UNCAMotorsports/UNCAMotorsports-2017/C-CAN/README.md

PSoC 5LP FIles

This is a collection of the files for the C-CAN, a configurable CAN-based sensor interface designed around a Cypress PSoC 5LP development board. You need PSoC Creator to work with these files; Once PSoC Creator is installed, you can edit the project by opening bootloader-000.cywrk in the bootloader folder.
