UNCAMotorsports/UNCAMotorsports-2017/Brake System Plausibility Device/BSPD_Schematic.PNG

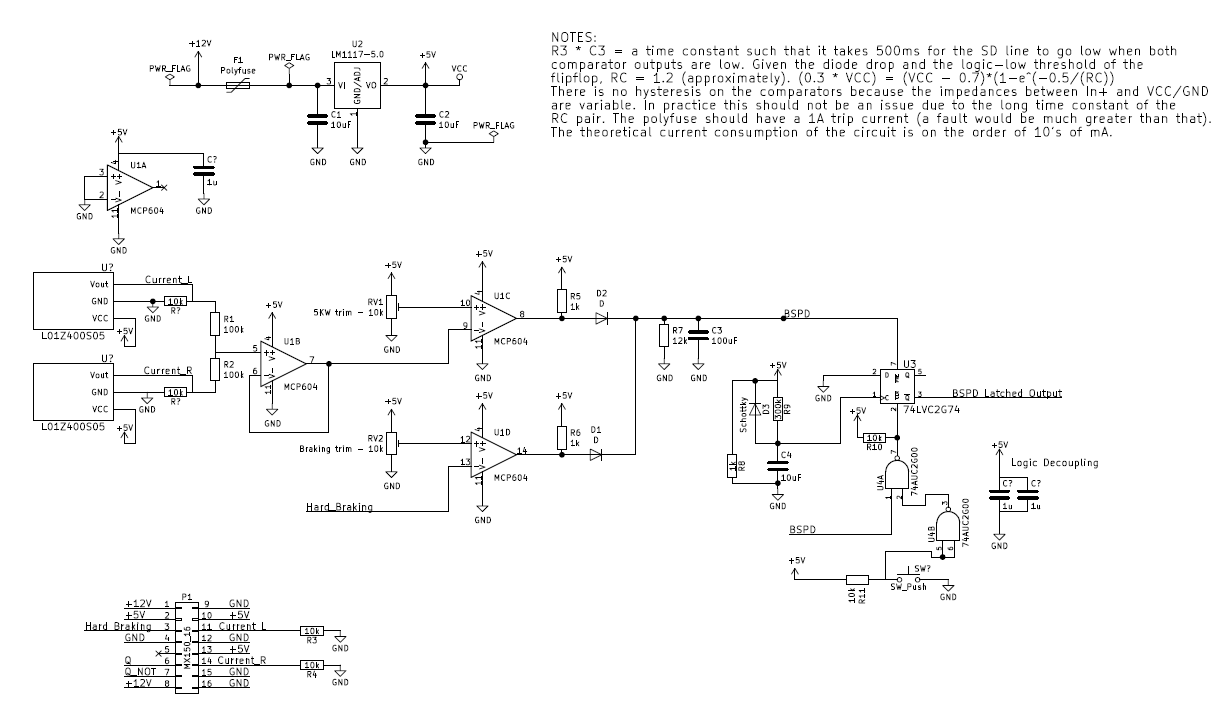
Brake System Plausibility Device/BSPD_Schematic.PNG
