UNCAMotorsports/UNCAMotorsports-2017/ESF_Diagrams/shutdown_circuit.png

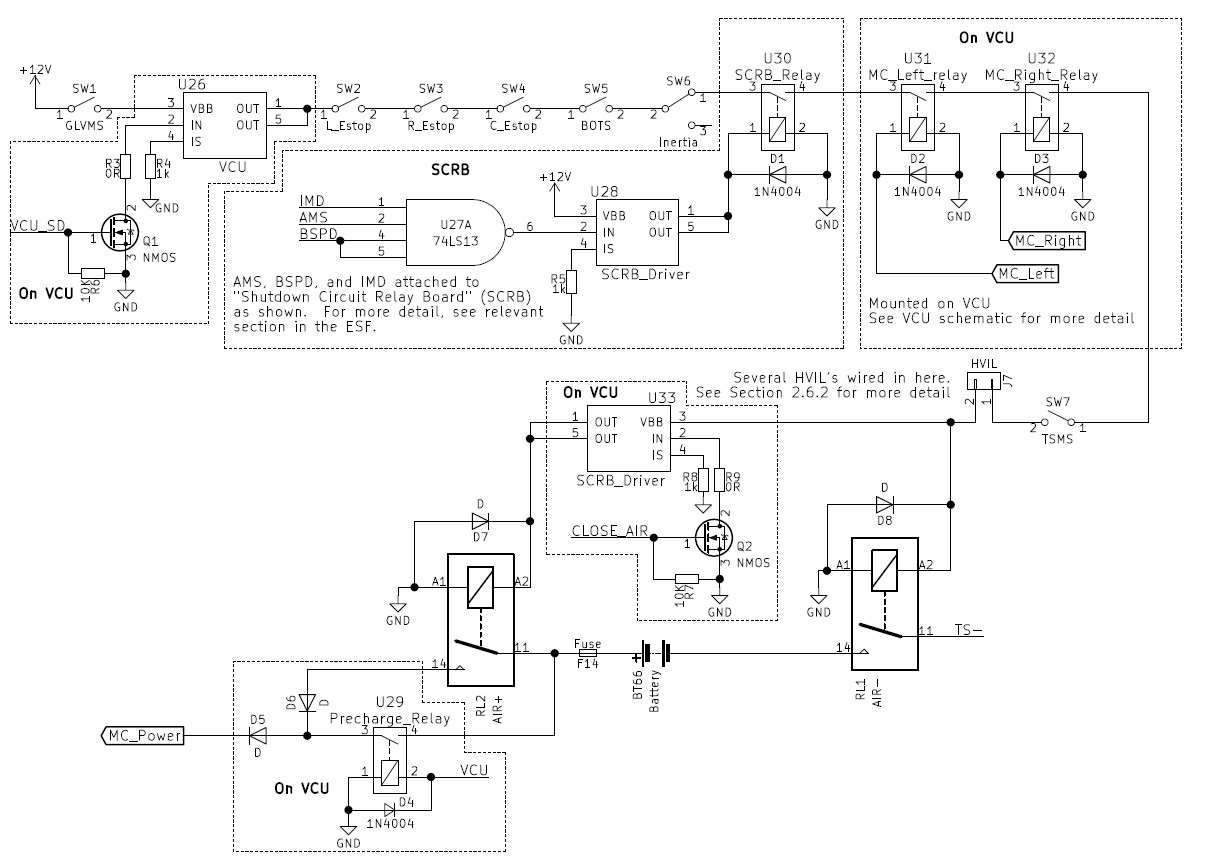
ESF_Diagrams/shutdown_circuit.png
