UNCAMotorsports/UNCAMotorsports-2017/IMD/IMD_Schematic.PNG

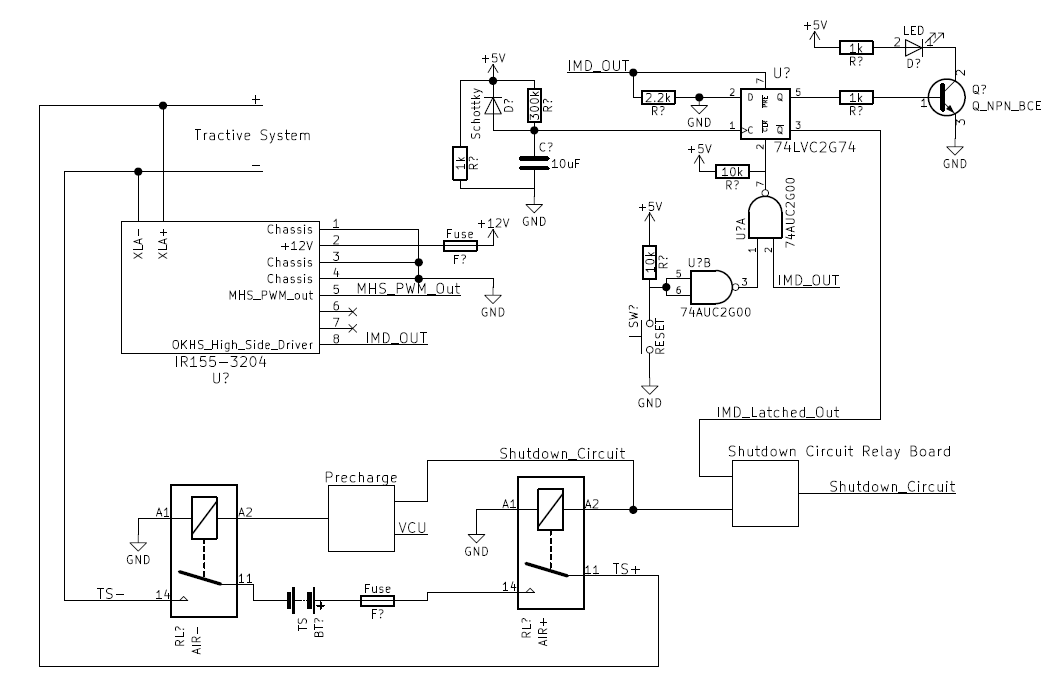
IMD/IMD_Schematic.PNG
