UNCAMotorsports/UNCAMotorsports-2017/latching_IMD-BMS-BSPD.PNG

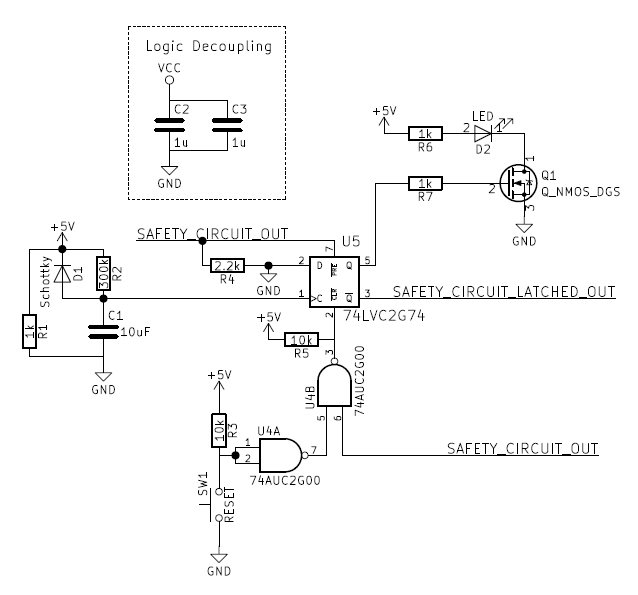
latching_IMD-BMS-BSPD.PNG
