UNCAMotorsports/UNCAMotorsports-2017/Reset_latching_IMD-BMS.PNG

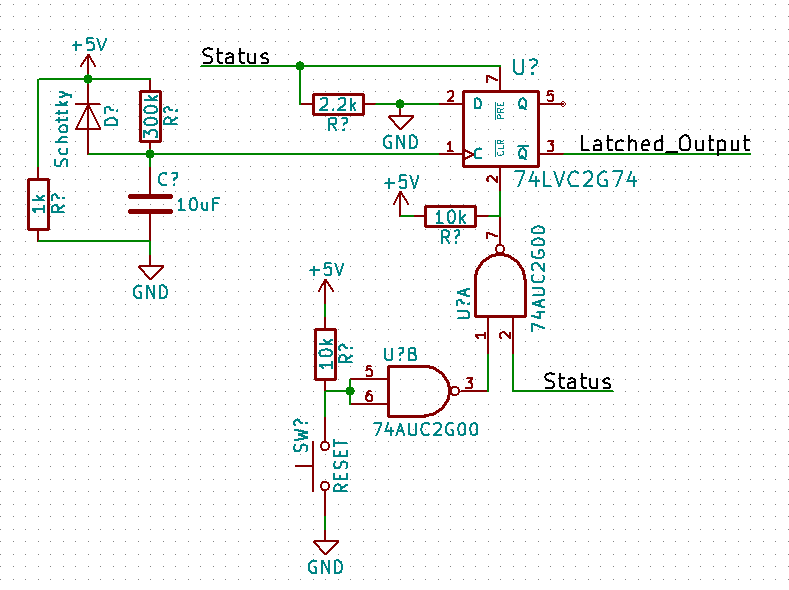
Reset_latching_IMD-BMS.PNG
