UNCAMotorsports/UNCAMotorsports-2017/shutdown_circuit/IMD.PNG

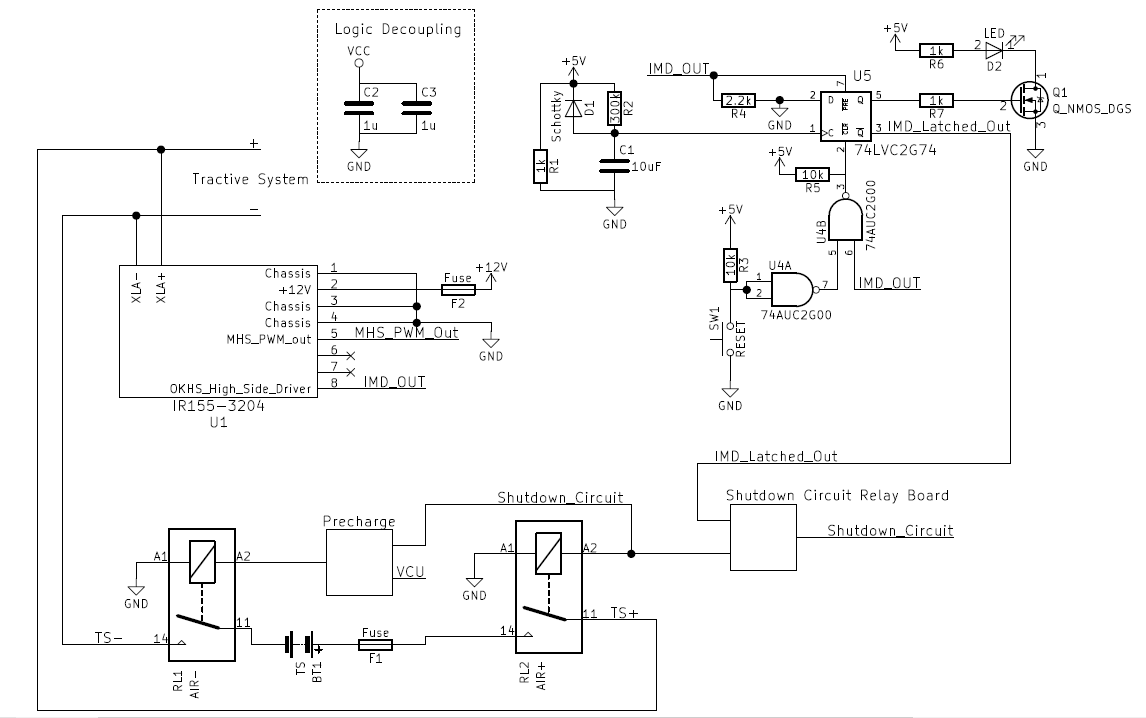
shutdown_circuit/IMD.PNG
