UNCAMotorsports/UNCAMotorsports-2017/shutdown_circuit/shutdown_relay_esf.png

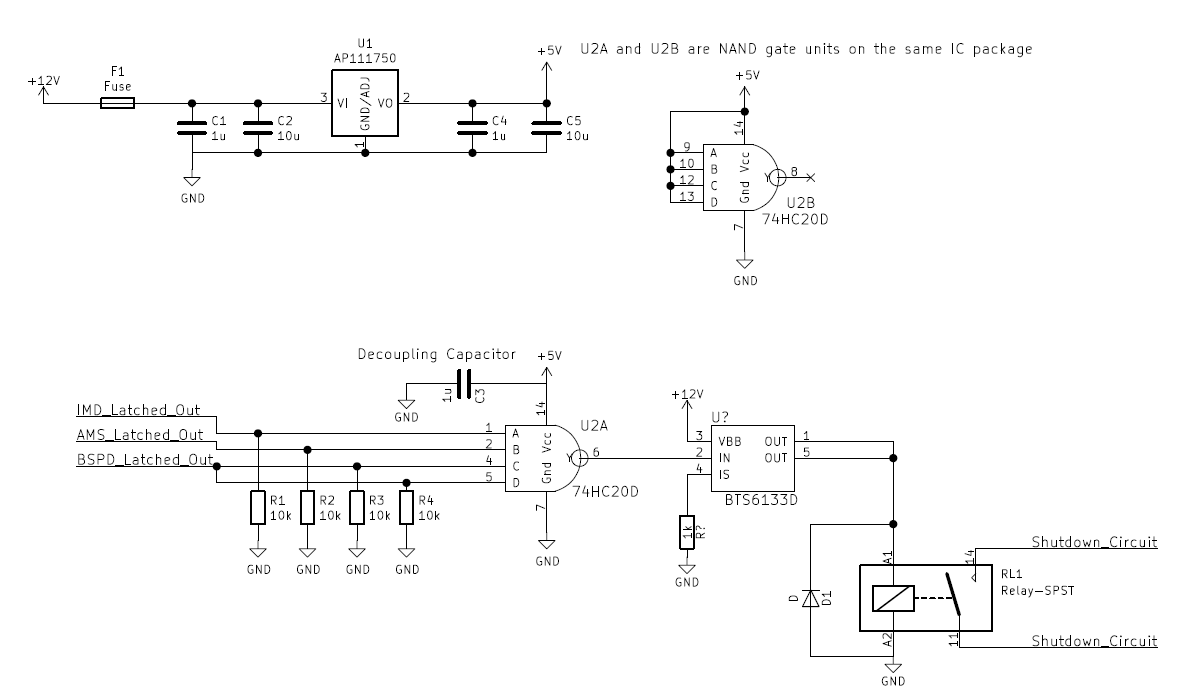
shutdown_circuit/shutdown_relay_esf.png
