UNCAMotorsports/UNCAMotorsports-2017/shutdown_circuit/VCU_shutdown_circuit.png

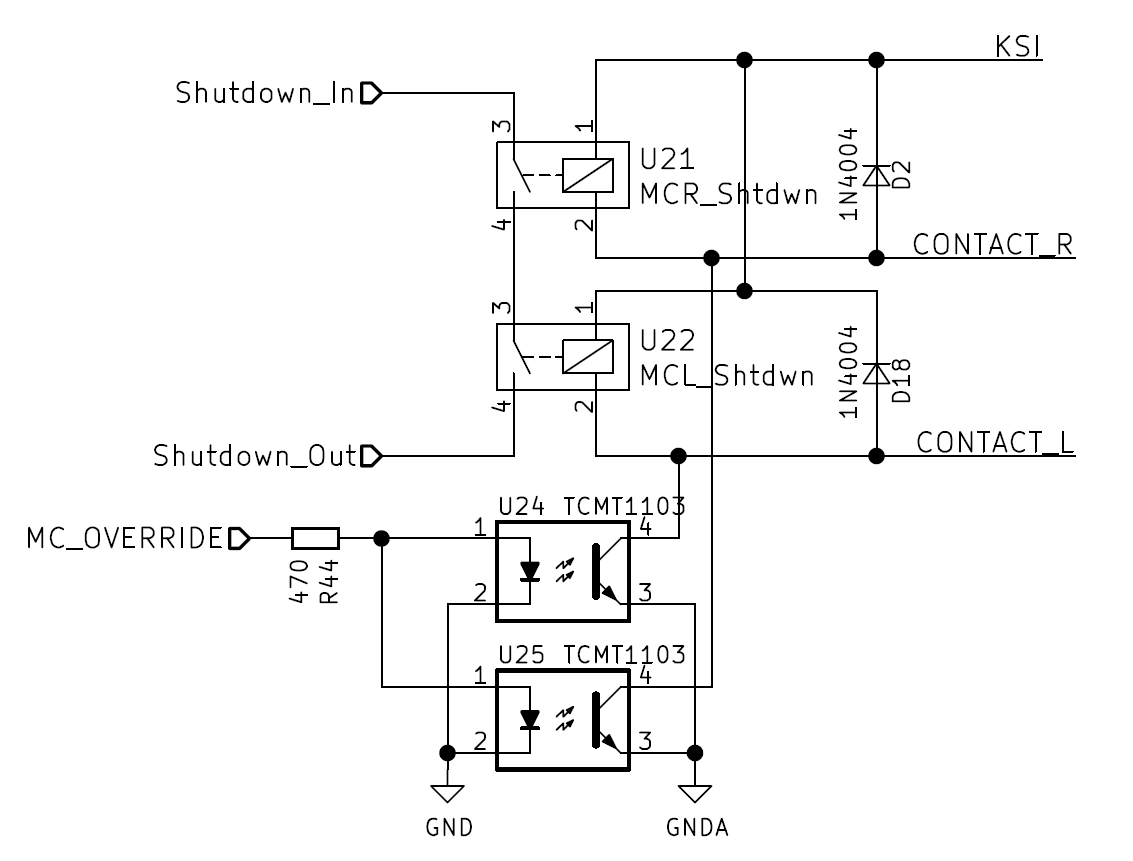
shutdown_circuit/VCU_shutdown_circuit.png
