UNCAMotorsports/UNCAMotorsports-2017/tsal/TSAL.PNG

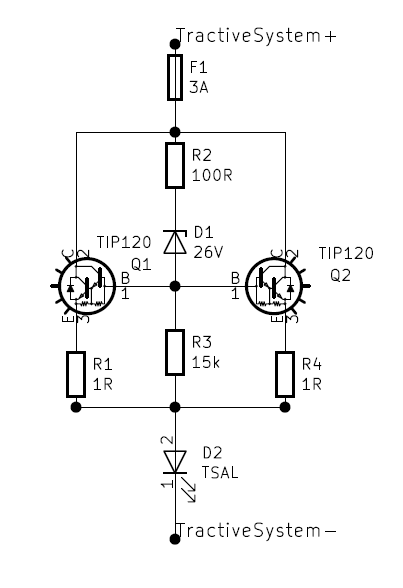
tsal/TSAL.PNG
