UNCAMotorsports/UNCAMotorsports-2017/Energy_Meter/BOM.txt

Current Shunt: Murata 3020-01105-0. 1000A 50mV shunt.
