UNCAMotorsports/UNCAMotorsports-2017/C-CAN/C-CAN_PSoC_DevKit/Bootloader.cydsn/ComponentUpdateLog.txt

Last Modified Date & Time: 10/16/2016 03:30:00

Bootloader: TopDesign.cysch
	USBFS [v3.0] to [v3.10]

Bootloader: Bootloader.cydwr
	cy_boot [v5.40] to [v5.50]

C-CAN: C-CAN.cydwr
	cy_boot [v5.40] to [v5.50]
