UNCAMotorsports/UNCAMotorsports-2017/C-CAN_Y17/enclosure_m12/working_version/5conn/Assem1.SLDASM

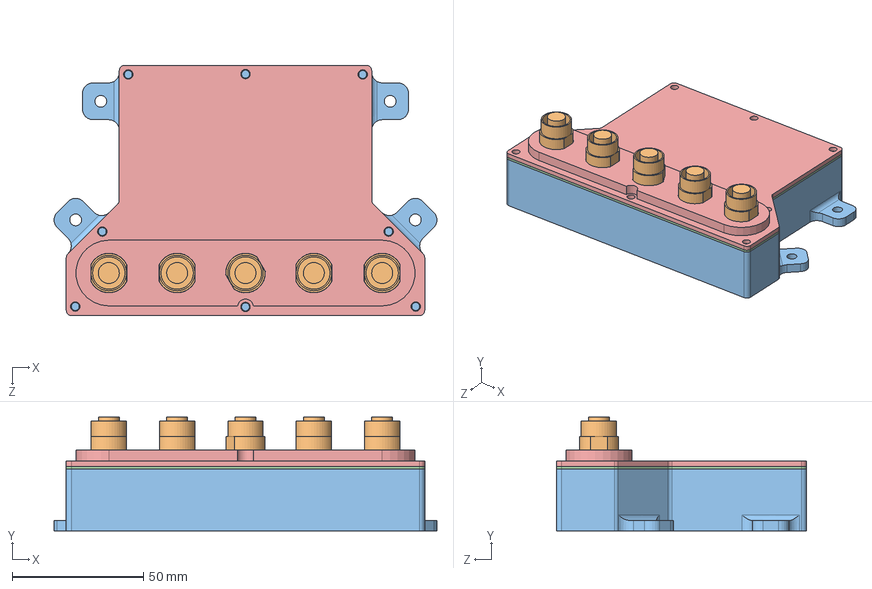
[picture p13: CAD file, 2017-06-10]
C-CAN_Y17/enclosure_m12/working_version/5conn/Assem1.SLDASM
145.7 x 43.2 x 95.2 mm
C-CAN_Y17
m12_connector_female x 5
5_connector_box
5_connector_gasket
5_connector_lid
