UNCAMotorsports/UNCAMotorsports-2017/C-CAN_Y17/enclosure_m12/working_version/new_b_and_c.SLDASM

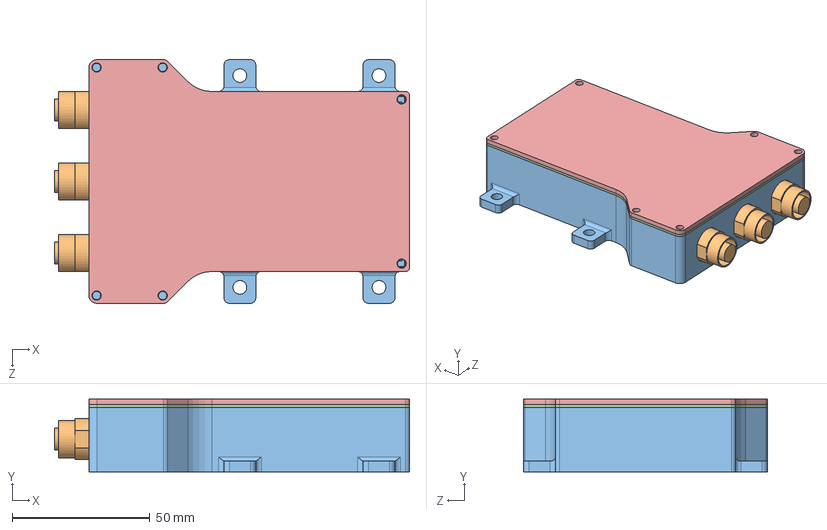
[picture p14: CAD file, 2017-06-07]
C-CAN_Y17/enclosure_m12/working_version/new_b_and_c.SLDASM
129.0 x 26.5 x 88.6 mm
C-CAN_Y17
m12_connector_female x 3
Gasket
lid
