UNCAMotorsports/UNCAMotorsports-2017/shutdown_circuit/scrub_buspod.SLDASM

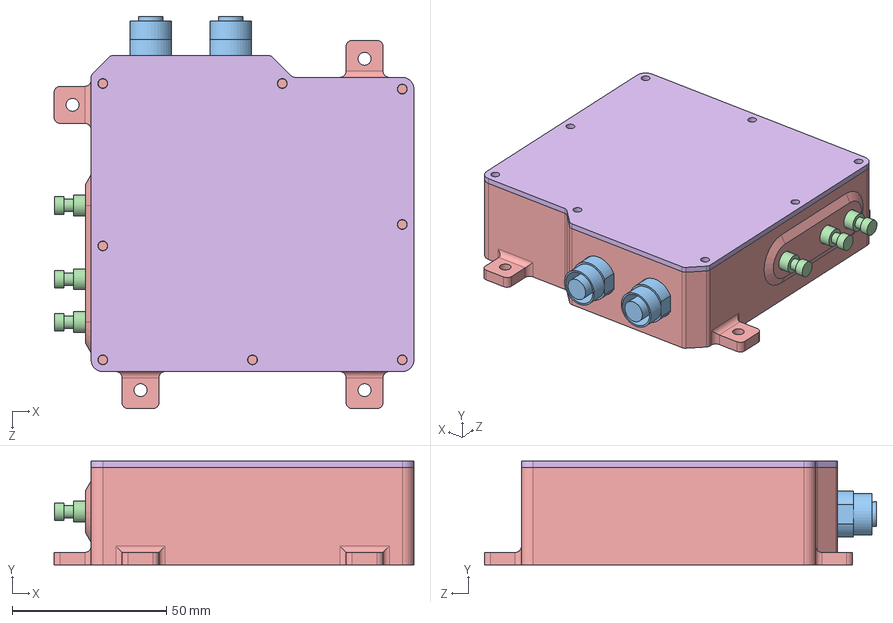
[picture p15: CAD file, 2017-06-13]
shutdown_circuit/scrub_buspod.SLDASM
116.5 x 33.5 x 127.0 mm
bspd x 3
scrb x 3
m12_connector_female x 2
push_button x 3
buspod_box
buspod_lid
