UNCAMotorsports/UNCAMotorsports-2017/C-CAN_Y17/enclosure_molex/Board_and_Connectors.SLDASM

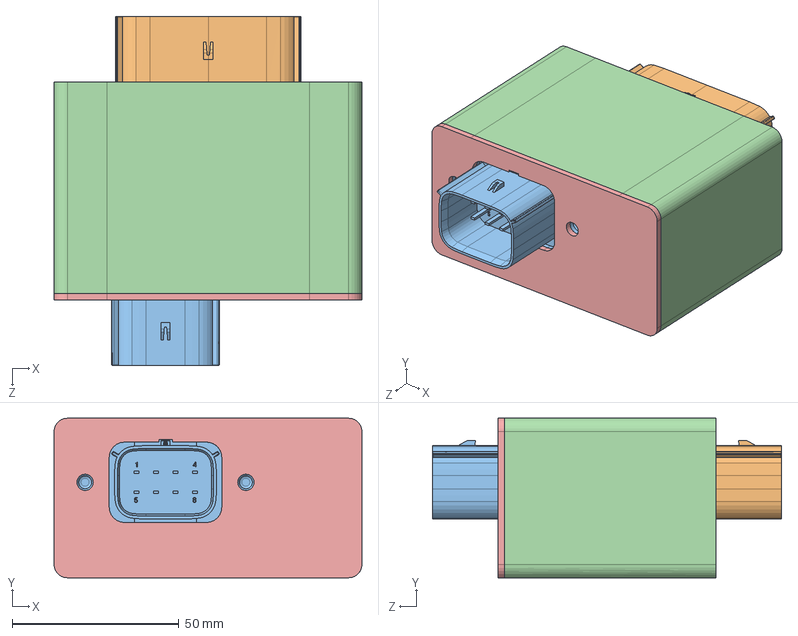
[picture p16: CAD file, 2017-03-09]
C-CAN_Y17/enclosure_molex/Board_and_Connectors.SLDASM
92.5 x 47.9 x 104.8 mm
C-CAN_Y17
mx150_16_pin
mx150_8_pin
C-CAN_Enclosure_1
C_CAN_Enclosure_2
