UNCAMotorsports/UNCAMotorsports-2017/C-CAN_Y17/enclosure_m12/Board_and_Connectors_2.SLDASM

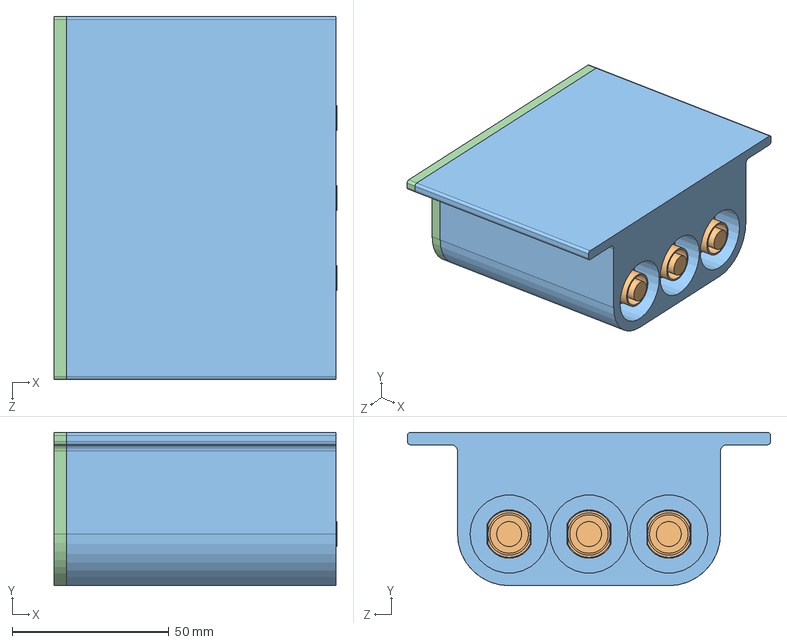
[picture p17: CAD file, 2017-04-11]
C-CAN_Y17/enclosure_m12/Board_and_Connectors_2.SLDASM
90.4 x 49.0 x 116.0 mm
C-CAN_Y17
m12_connector_female x 3
lid
