UNCAMotorsports/UNCAMotorsports-2017/C-CAN_Y17/C-CAN_Y17.stp

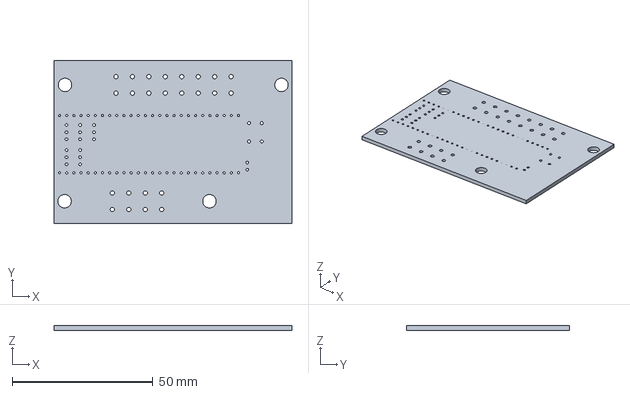
[picture p18: CAD file, 2017-03-09]
C-CAN_Y17/C-CAN_Y17.stp
84.5 x 57.8 x 1.60 mm
