UNCAMotorsports/UNCAMotorsports-2017/C-CAN_Y17/enclosure_m12/m12_connector_female.SLDPRT

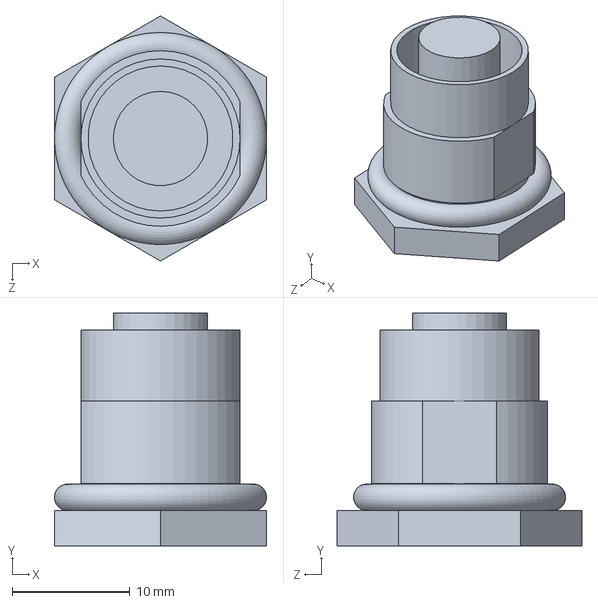
[picture p19: CAD file, 2017-06-13]
C-CAN_Y17/enclosure_m12/m12_connector_female.SLDPRT
18.0 x 19.8 x 20.8 mm
