UNCAMotorsports/UNCAMotorsports-2017/C-CAN_Y17/enclosure_m12/New folder/lid2.STL

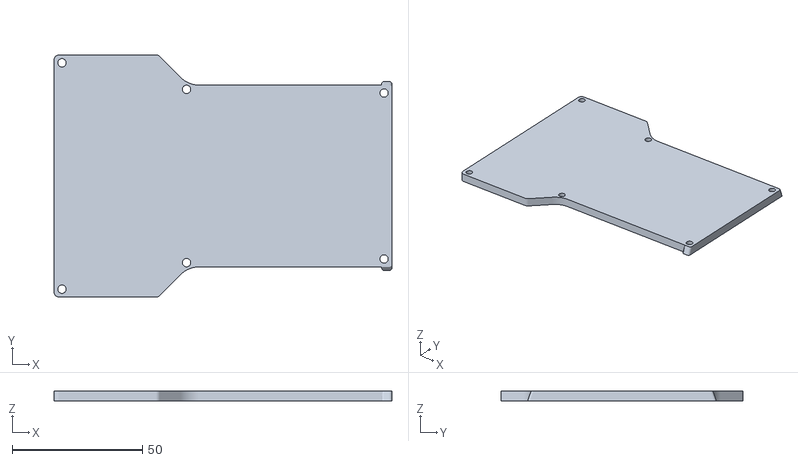
[picture p20: CAD file, 2017-04-20]
C-CAN_Y17/enclosure_m12/New folder/lid2.STL
129.8 x 93.0 x 4.00
