UNCAMotorsports/UNCAMotorsports-2017/C-CAN_Y17/enclosure_m12/working_version/C-CAN_Y17.SLDPRT

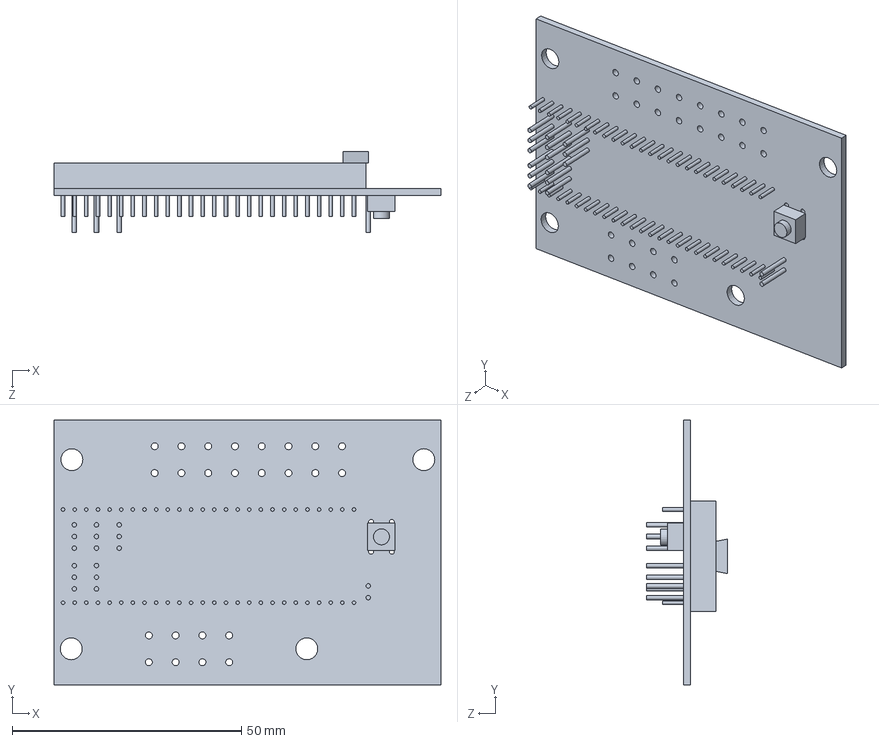
[picture p21: CAD file, 2017-06-07]
C-CAN_Y17/enclosure_m12/working_version/C-CAN_Y17.SLDPRT
84.5 x 57.8 x 17.6 mm
