UNCAMotorsports/UNCAMotorsports-2017/step_files/mx150_16_pin/mx150_16_pin.SLDPRT

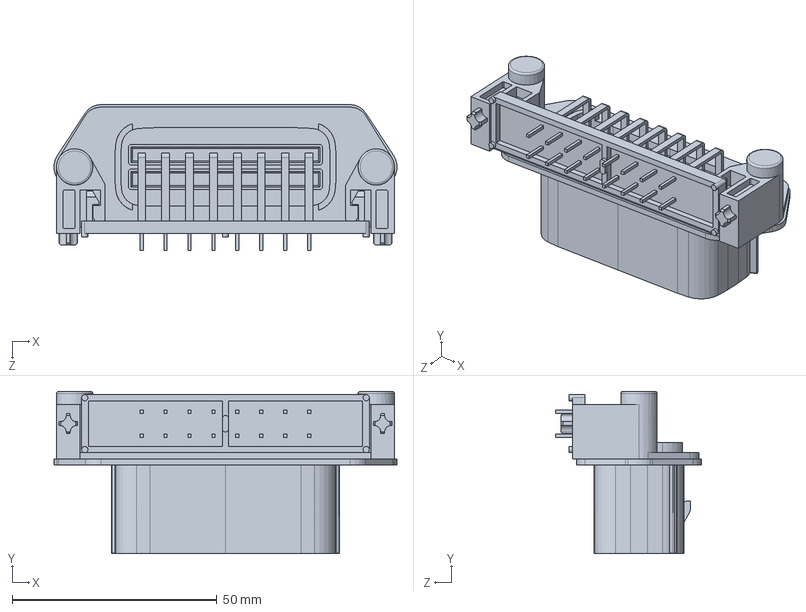
[picture p22: CAD file, 2017-03-09]
step_files/mx150_16_pin/mx150_16_pin.SLDPRT
83.8 x 39.6 x 35.6 mm
