UNCAMotorsports/UNCAMotorsports-2017/step_files/mx150_8_pin/mx150_8_pin.stp

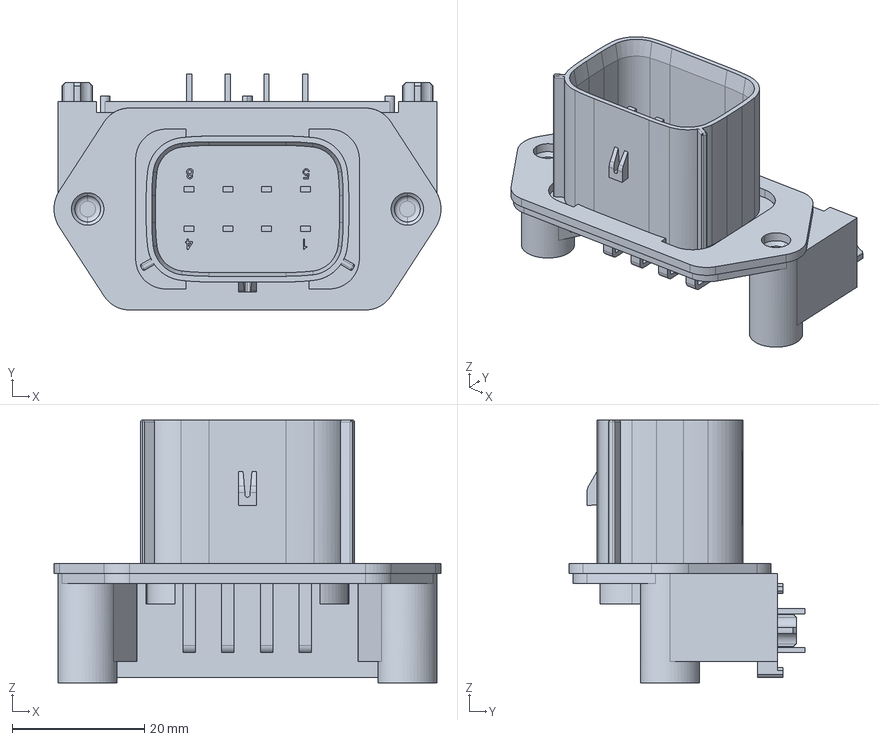
[picture p23: CAD file, 2017-03-09]
step_files/mx150_8_pin/mx150_8_pin.stp
58.4 x 35.6 x 39.6 mm
