UNCAMotorsports/UNCAMotorsports-2017/VehicleController/VehicleController1.step

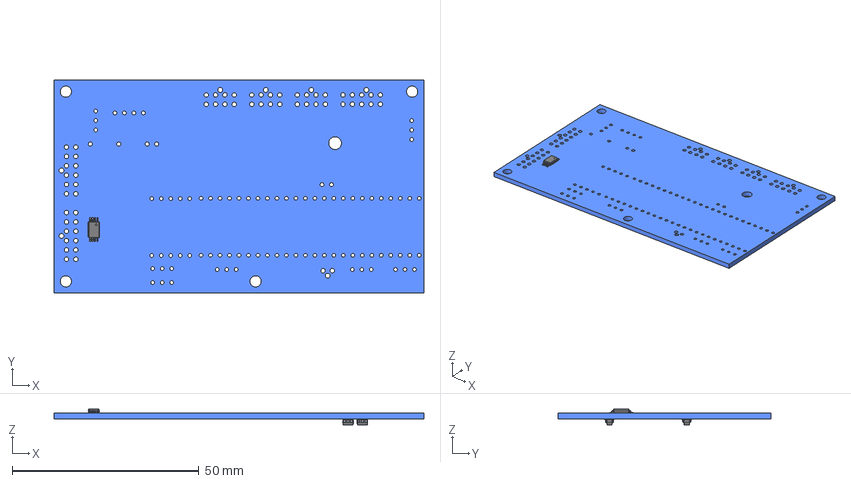
[picture p24: CAD file, 2017-09-07]
VehicleController/VehicleController1.step
99.1 x 57.1 x 4.25 mm
Pcb
SOT_23_6_
SOT_23_6_001
TSSOP_8_44x3mm_Pitch065mm_
