UNCAMotorsports/UNCAMotorsports-2017/C-CAN_Y17/enclosure_m12/working_version/box2.sldprt

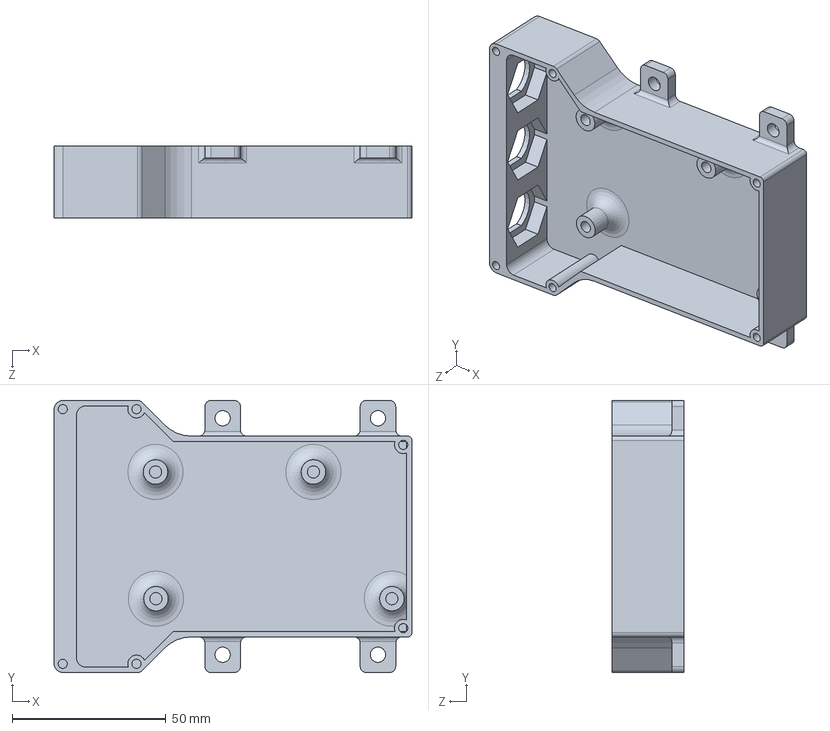
[picture p25: CAD file, 2017-06-07]
C-CAN_Y17/enclosure_m12/working_version/box2.sldprt
116.6 x 88.6 x 23.5 mm
