UNCAMotorsports/UNCAMotorsports-2017/shutdown_circuit/scrb.SLDPRT

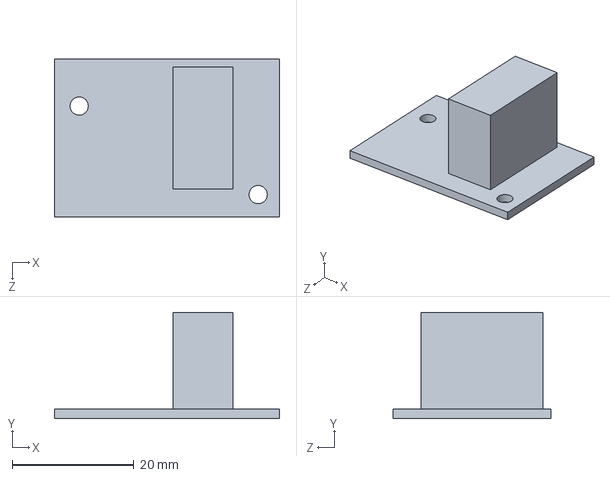
[picture p26: CAD file, 2017-06-13]
shutdown_circuit/scrb.SLDPRT
36.9 x 17.5 x 25.9 mm
