UNCAMotorsports/UNCAMotorsports-2017/VehicleController/VehicleController.stp

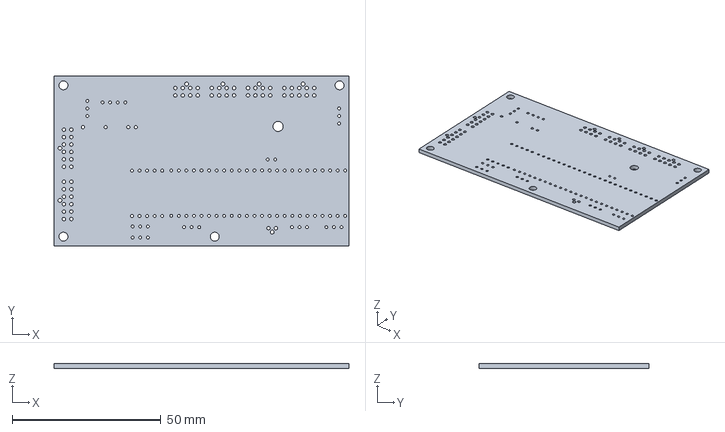
[picture p27: CAD file, 2017-06-15]
VehicleController/VehicleController.stp
99.1 x 57.1 x 1.60 mm
