UNCAMotorsports/UNCAMotorsports-2017/C-CAN_Y17/enclosure_m12/box.sldprt

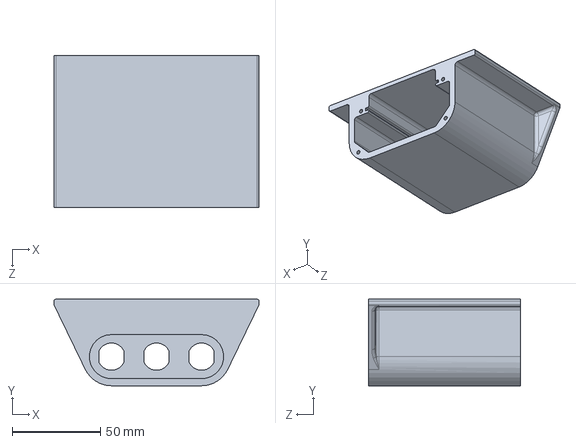
[picture p28: CAD file, 2017-04-16]
C-CAN_Y17/enclosure_m12/box.sldprt
116.0 x 49.0 x 86.2 mm
