UNCAMotorsports/UNCAMotorsports-2017/shutdown_circuit/push_button.SLDPRT

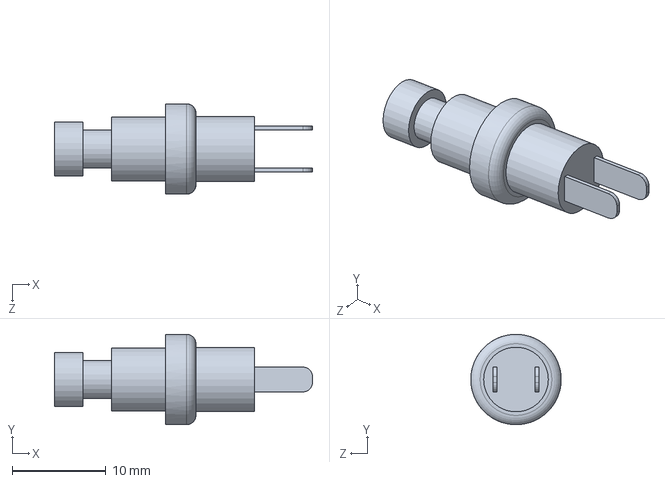
[picture p29: CAD file, 2017-06-13]
shutdown_circuit/push_button.SLDPRT
27.6 x 9.66 x 9.66 mm
