UNCAMotorsports/UNCAMotorsports-2017/C-CAN_Y17/enclosure_m12/lid2.STL

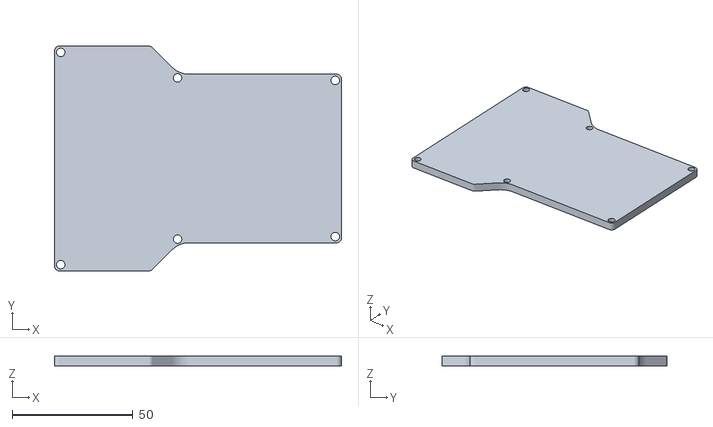
[picture p30: CAD file, 2017-04-13]
C-CAN_Y17/enclosure_m12/lid2.STL
118.8 x 93.0 x 4.00
