UNCAMotorsports/UNCAMotorsports-2017/shutdown_circuit/bspd.SLDPRT

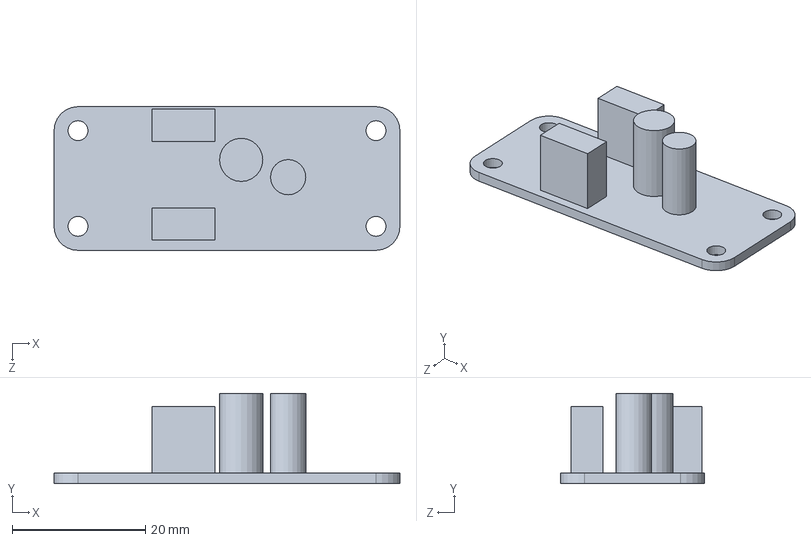
[picture p31: CAD file, 2017-06-13]
shutdown_circuit/bspd.SLDPRT
52.0 x 13.6 x 21.6 mm
