UNCAMotorsports/UNCAMotorsports-2017/C-CAN_Y17/enclosure_m12/working_version/lid.sldprt

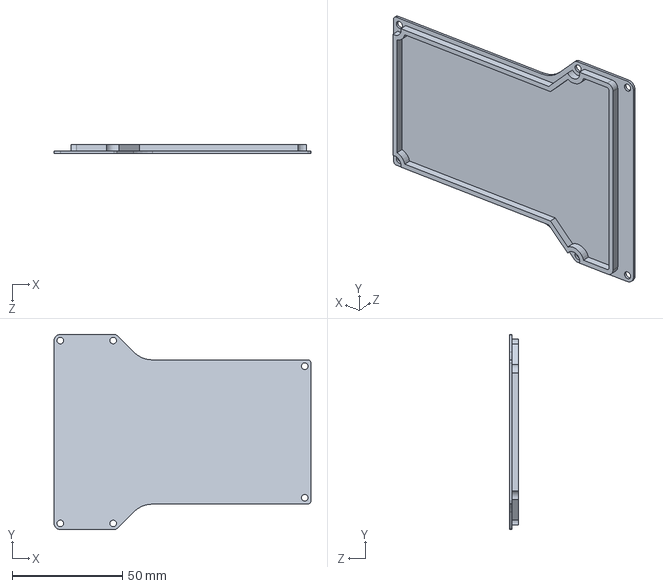
[picture p32: CAD file, 2017-06-07]
C-CAN_Y17/enclosure_m12/working_version/lid.sldprt
116.6 x 88.6 x 4.00 mm
