UNCAMotorsports/UNCAMotorsports-2017/shutdown_circuit/shutdown_circuit.stp

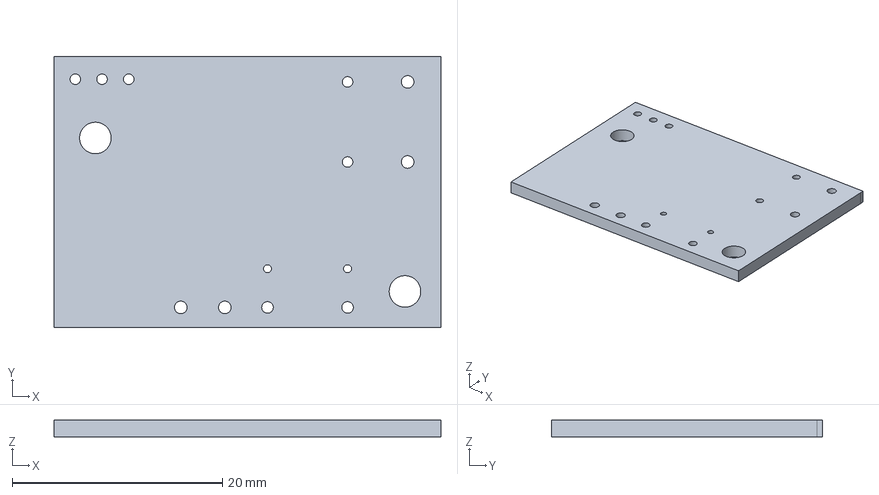
[picture p34: CAD file, 2017-06-10]
shutdown_circuit/shutdown_circuit.stp
36.8 x 25.8 x 1.60 mm
