UNCAMotorsports/UNCAMotorsports-2017/(list of files, cad)

Other CAD files:
C-CAN_Y17/enclosure_molex/C-CAN_Y17.SLDPRT
shutdown_circuit/Part4.sldprt
C-CAN_Y17/enclosure_m12/C-CAN_Y17.SLDPRT
C-CAN_Y17/enclosure_m12/working_version/5conn/Part1.sldprt
C-CAN_Y17/enclosure_molex/C_CAN_Enclosure_2.SLDPRT
C-CAN_Y17/enclosure_m12/working_version/5conn/5_connector_gasket.sldprt
C-CAN_Y17/enclosure_m12/working_version/m12_connector_female.SLDPRT
C-CAN_Y17/enclosure_molex/Part15.sldprt
C-CAN_Y17/enclosure_m12/working_version/5conn/5_connector_lid.sldprt
C-CAN_Y17/enclosure_molex/COMPOUND.sldprt
C-CAN_Y17/enclosure_m12/Part2.sldprt
C-CAN_Y17/enclosure_m12/working_version/5conn/5_connector_box.SLDPRT
C-CAN_Y17/enclosure_m12/working_version/Gasket.sldprt
C-CAN_Y17/enclosure_molex/C-CAN_Enclosure_1.SLDPRT
C-CAN_Y17/enclosure_m12/Part4.sldprt
shutdown_circuit/buspod_lid.sldprt
C-CAN_Y17/enclosure_m12/lid.sldprt
C-CAN_Y17/enclosure_molex/Part14.sldprt
shutdown_circuit/buspod_box.sldprt
shutdown_circuit/shutdown_circuit.wrl.sldprt
C-CAN_Y17/Gerbers/C-CAN_Y17-F.Mask.dxf
C-CAN_Y17/enclosure_m12/box.STL
C-CAN_Y17/enclosure_m12/lid.STL
C-CAN_Y17/enclosure_m12/m3_nut.SLDPRT
C-CAN_Y17/enclosure_m12/working_version/5conn/5_connector_box.STL
C-CAN_Y17/enclosure_m12/working_version/5conn/5_connector_lid.STL
C-CAN_Y17/enclosure_m12/working_version/Gasket.STL
C-CAN_Y17/enclosure_m12/working_version/box2.STL
C-CAN_Y17/enclosure_m12/working_version/lid.STL
VehicleController/VehicleController.FCStd
VehicleController/VehicleController.SLDPRT
shutdown_circuit/buspod_box.STL
shutdown_circuit/buspod_lid.STL
step_files/194270032.stp
step_files/194270049.SLDPRT
step_files/194270049.stp
step_files/mx150_8_pin/mx150_8_pin.SLDPRT
