UNCAMotorsports/UNCAMotorsports-2017/TestMule/Test Data/Aug31_no_differential.csv

Version | Millis | Throttle | Left | Right | Steer | leftRPM | rightRPM
1 | 135 | 0 | 0 | 0 | 16.25 | 0 | 0
1 | 140 | 0 | 0 | 0 | 16.25 | 0 | 0
1 | 145 | 0 | 0 | 0 | 16.25 | 0 | 0
1 | 150 | 0 | 0 | 0 | 16.25 | 0 | 0
1 | 155 | 0 | 0 | 0 | 16.200000762939453 | 0 | 0
1 | 160 | 0 | 0 | 0 | 16.25 | 0 | 0
1 | 165 | 0 | 0 | 0 | 16.350000381469727 | 0 | 0
1 | 170 | 0 | 0 | 0 | 16.25 | 0 | 0
1 | 175 | 0 | 0 | 0 | 16.200000762939453 | 0 | 0
1 | 180 | 0 | 0 | 0 | 16.30000114440918 | 0 | 0
1 | 185 | 0 | 0 | 0 | 16.149999618530273 | 0 | 0
1 | 190 | 0 | 0 | 0 | 16.30000114440918 | 0 | 0
1 | 195 | 0 | 0 | 0 | 16.25 | 0 | 0
1 | 200 | 0 | 0 | 0 | 16.200000762939453 | 0 | 0
1 | 205 | 0 | 0 | 0 | 16.30000114440918 | 0 | 0
1 | 210 | 0 | 0 | 0 | 16.25 | 0 | 0
1 | 215 | 0 | 0 | 0 | 16.350000381469727 | 0 | 0
1 | 220 | 0 | 0 | 0 | 16.25 | 0 | 0
1 | 225 | 0 | 0 | 0 | 16.149999618530273 | 0 | 0
1 | 230 | 0 | 0 | 0 | 16.30000114440918 | 0 | 0
1 | 235 | 0 | 0 | 0 | 16.30000114440918 | 0 | 0
1 | 240 | 0 | 0 | 0 | 16.25 | 0 | 0
1 | 245 | 0 | 0 | 0 | 16.25 | 0 | 0
1 | 250 | 0 | 0 | 0 | 16.200000762939453 | 0 | 0
1 | 255 | 0 | 0 | 0 | 16.30000114440918 | 0 | 0
1 | 300 | 0 | 0 | 0 | 16.149999618530273 | 0 | 0
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
