UNCAMotorsports/UNCAMotorsports-2017/C-CAN/TODO.rtf

8/21/16
Get the system timer interrupt to change the rate of sampling for the sensors/encoders. Global variables? Handler functions?
