UNCAMotorsports/UNCAMotorsports-2017/TestMule/TestMule.pdf

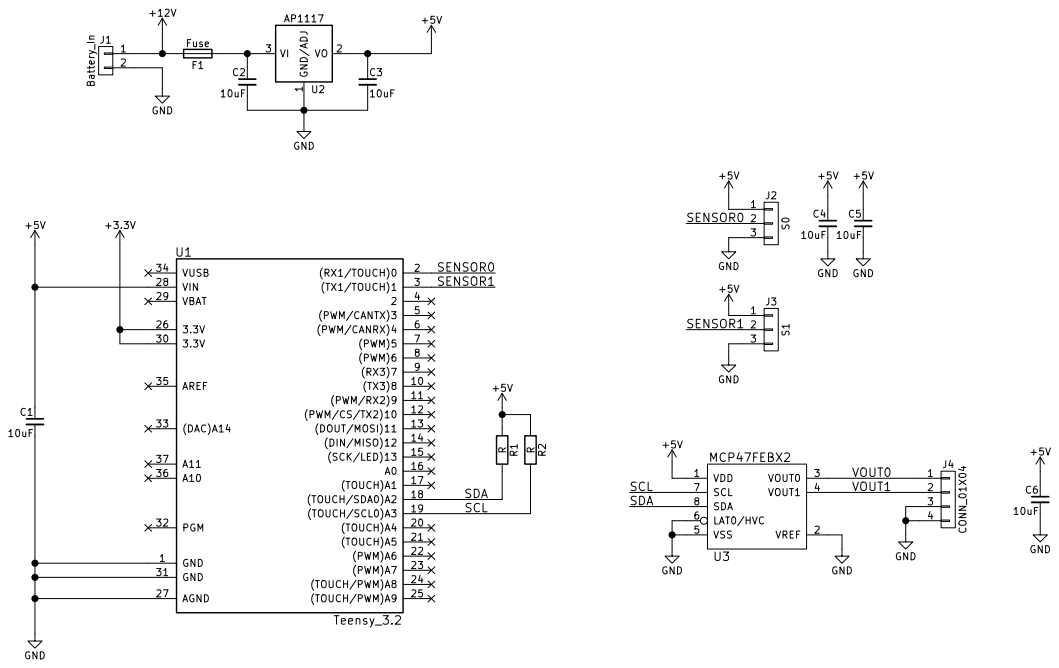
[picture p35: page 1]

Id: 1/1 Title: TestMule Controller File: TestMule.sch Sheet: / UNC Asheville Motorsports GND 1
