UNCAMotorsports/UNCAMotorsports-2017/VehicleController/VehicleController.pdf

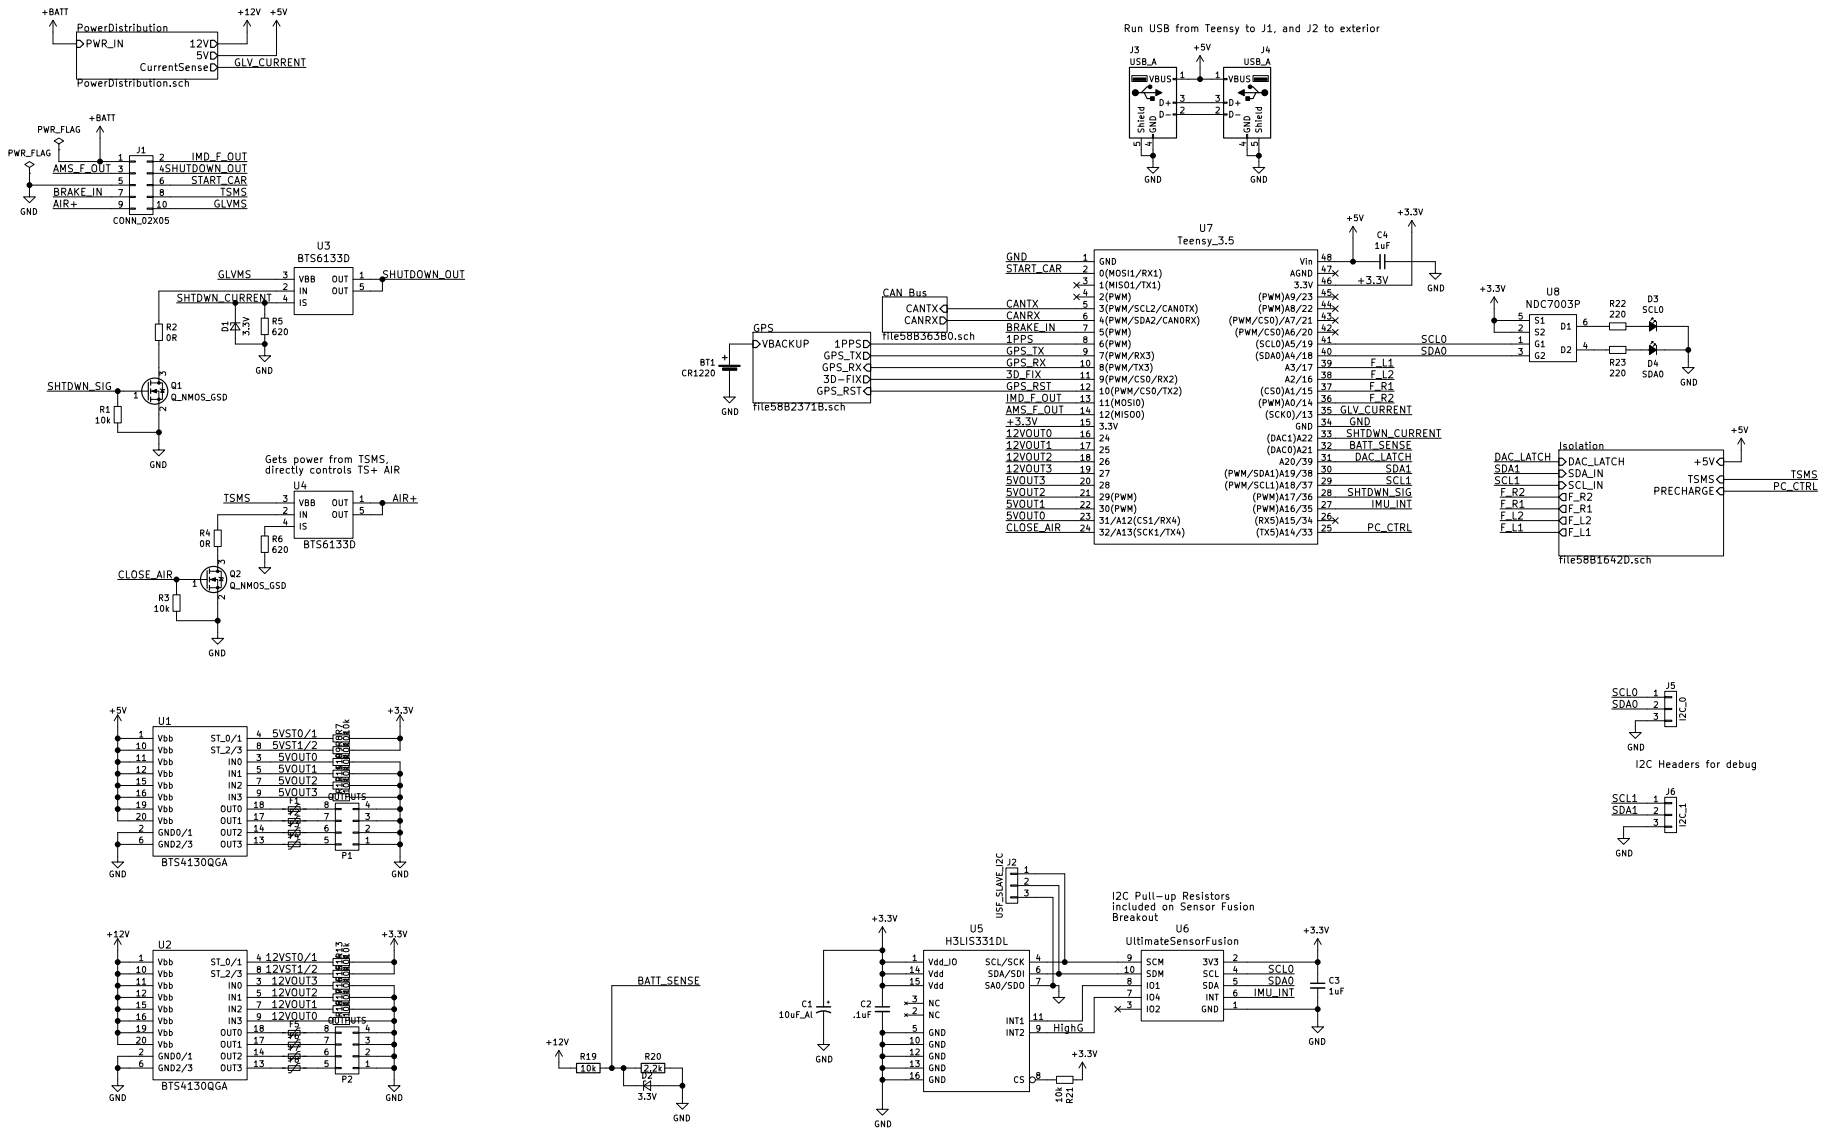
[picture p36: page 1]

PowerDistribution PowerDistribution.sch CurrentSense

9 | | 10

3D-FIX GPS_TX GPS_RX GPS_RST | 1PPS | 6(PWM) 8

7(PWM/RX3) 9 | SDA0

3D_FIX | | 9(PWM/CS0/RX2) 11

10(PWM/CS0/TX2) 12

IMD_F_OUT | | 11(MOSI0) 13

directly controls TS+ AIR

I2C Pull-up Resistors
included on Sensor Fusion Breakout

HighG

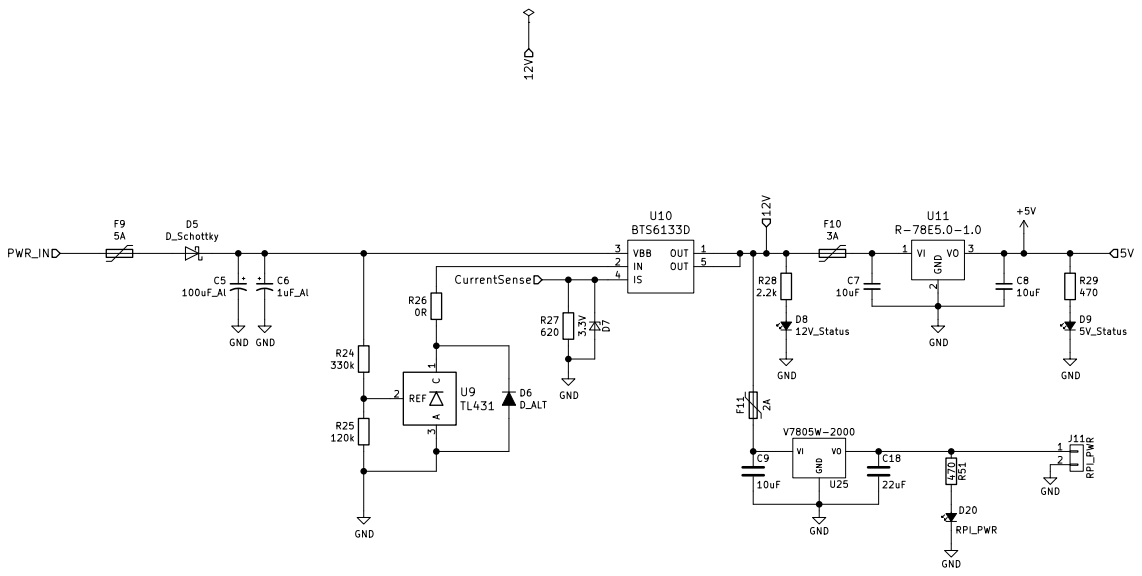
[picture p37: page 2]

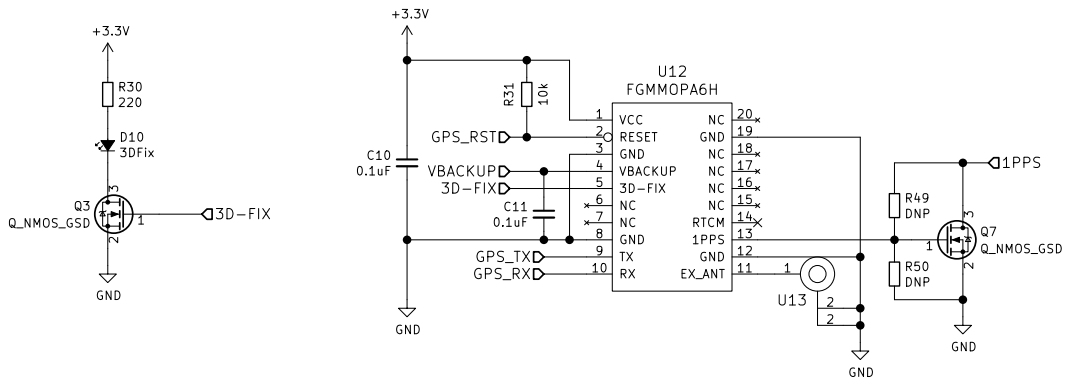
[picture p38: page 3]

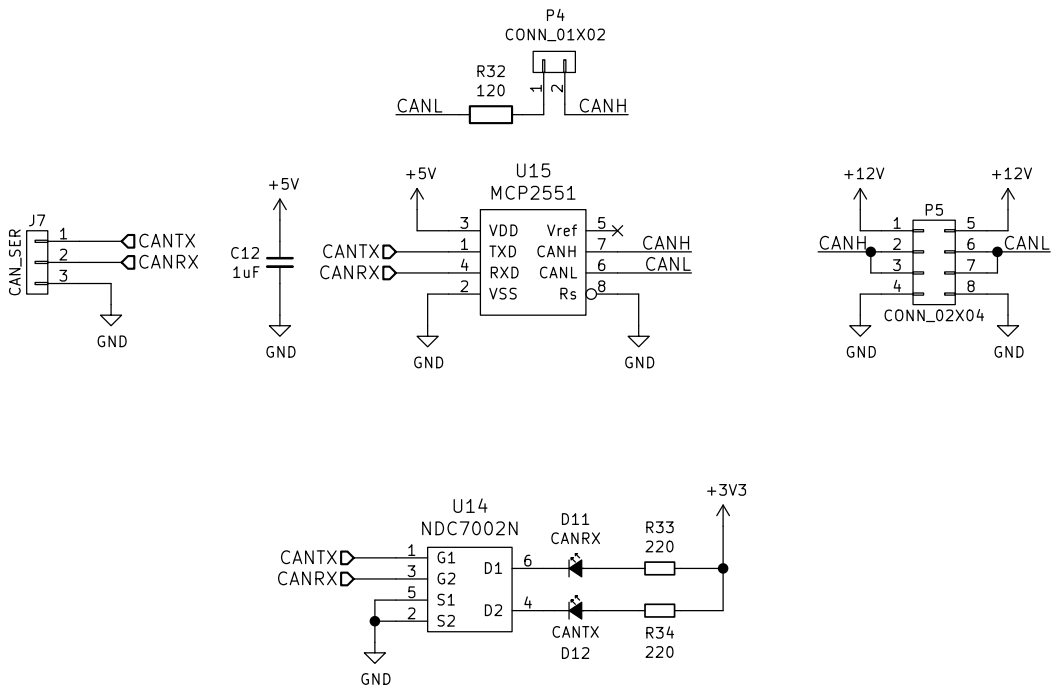
[picture p39: page 4]

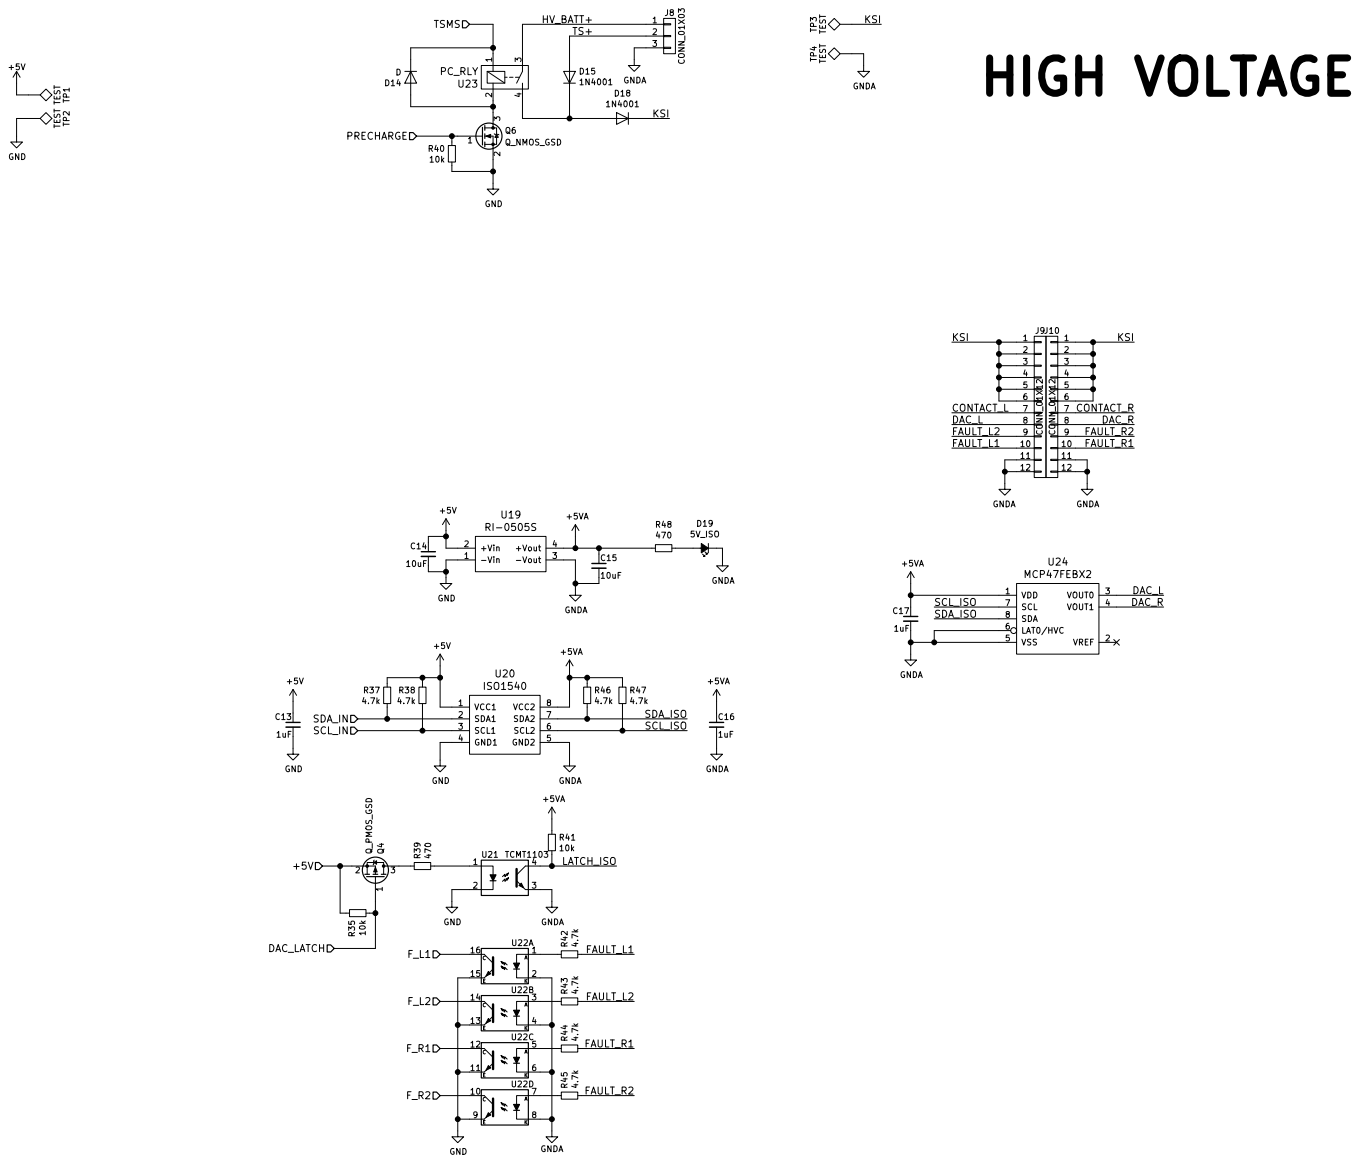
[picture p40: page 5]

2 3 Q6 Q_NMOS_GSD TP1 TEST TP2 TEST TP3 TEST TP4 TEST GNDA

J9 | J10 CONN_01X12

CONN_01X12 | 3

10
