UNCAMotorsports/UNCAMotorsports-2017/IMD/IMD.pdf

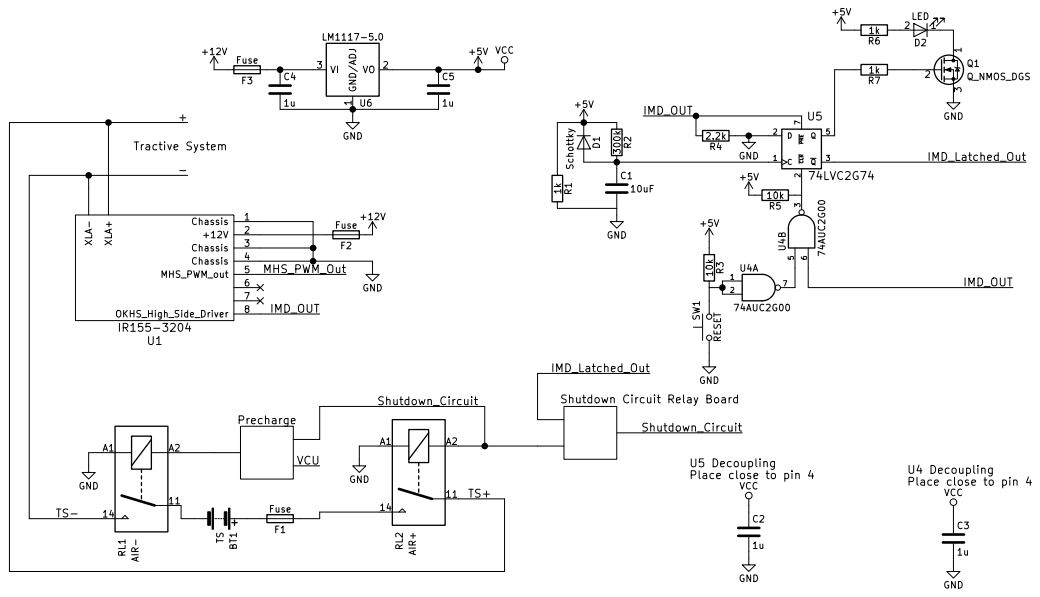
[picture p42: page 1]

Shutdown Circuit Relay Board

Place close to pin 4
