UNCAMotorsports/UNCAMotorsports-2017/Reset_Latching_IMD_AMS/reset_latching.pdf

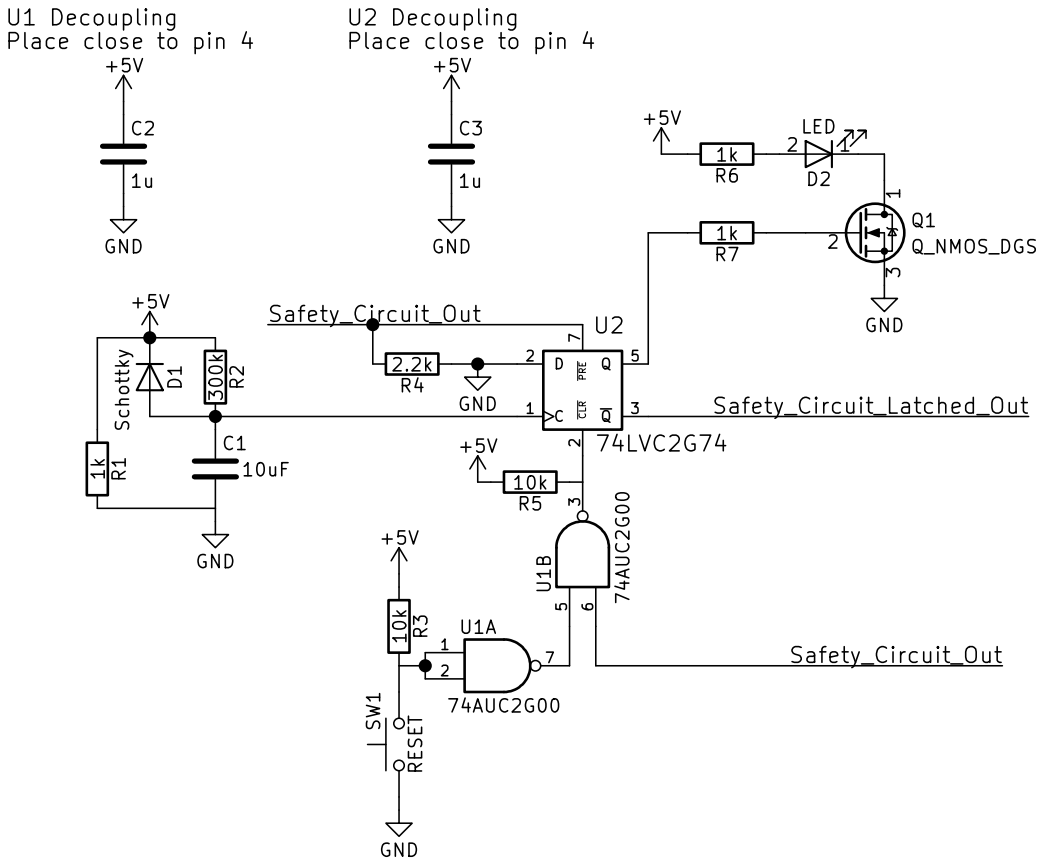
[picture p43: page 1]

Place close to pin 4

U2 Decoupling
