UNCAMotorsports/UNCAMotorsports-2017/ESF_Diagrams/ESF_Diagrams.pdf

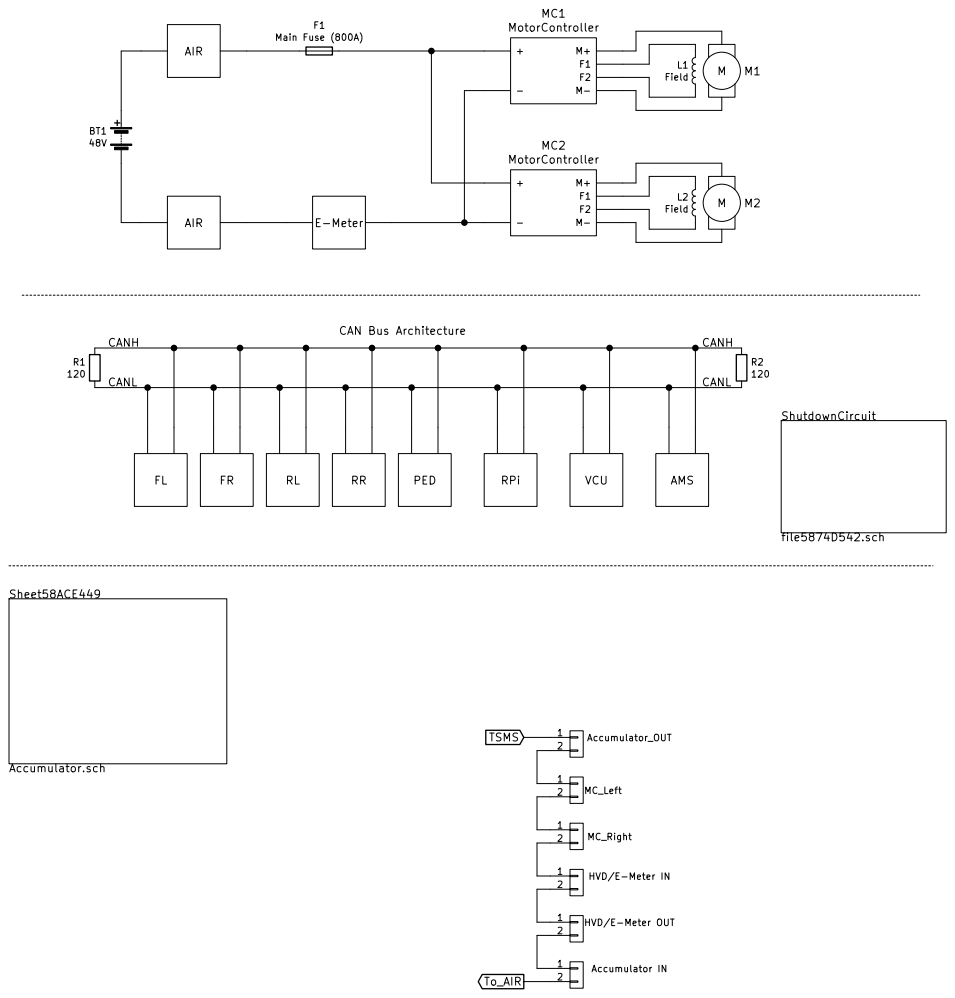
[picture p44: page 1]

file5874D542.sch E-Meter Sheet58ACE449 Accumulator.sch

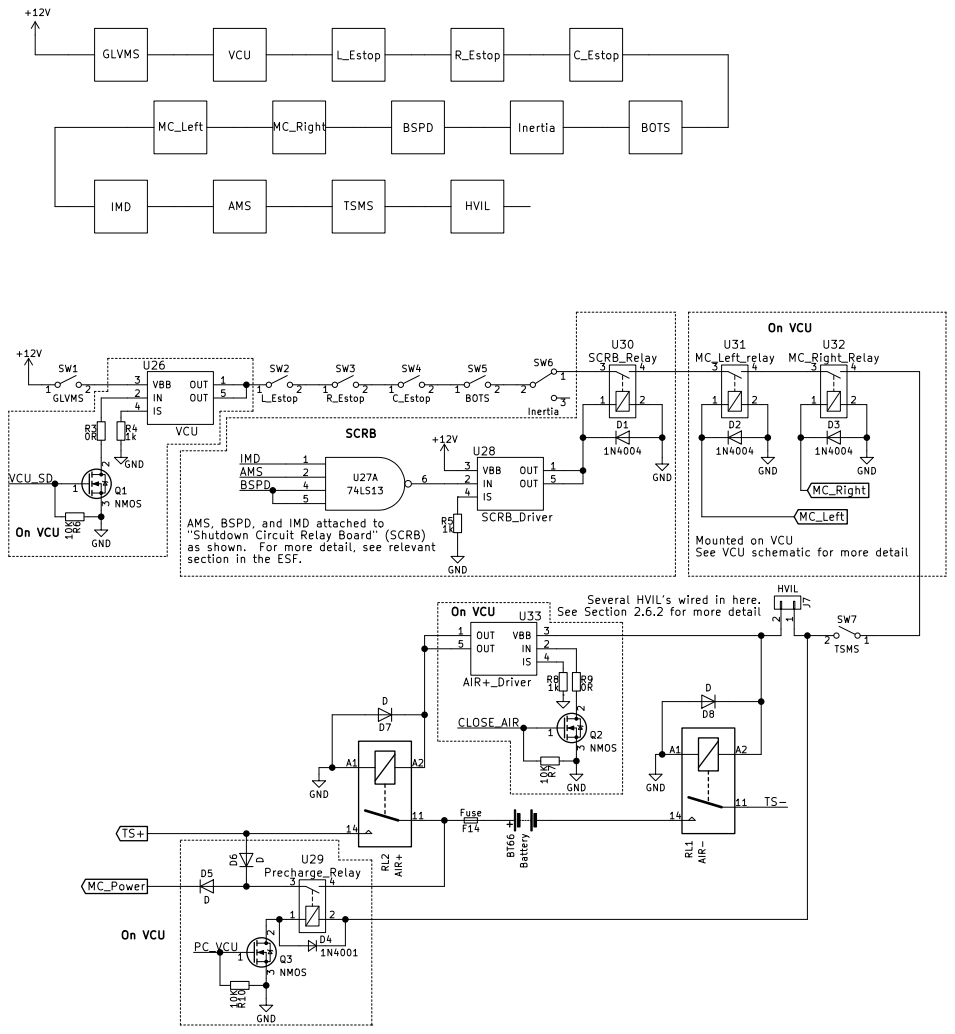
[picture p45: page 2]

Inertia AMS, BSPD, and IMD attached to

"Shutdown Circuit Relay Board" (SCRB)
as shown. For more detail, see relevant

1 J7 HVIL Several HVIL's wired in here.

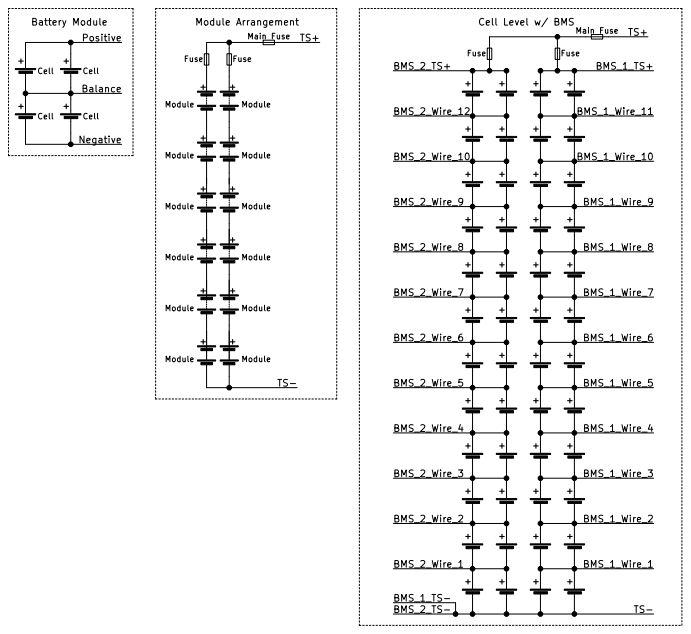
[picture p46: page 3]
