UNCAMotorsports/UNCAMotorsports-2017/VehicleController/Gerbers/Rev02/VehicleController-B.SilkS.pdf

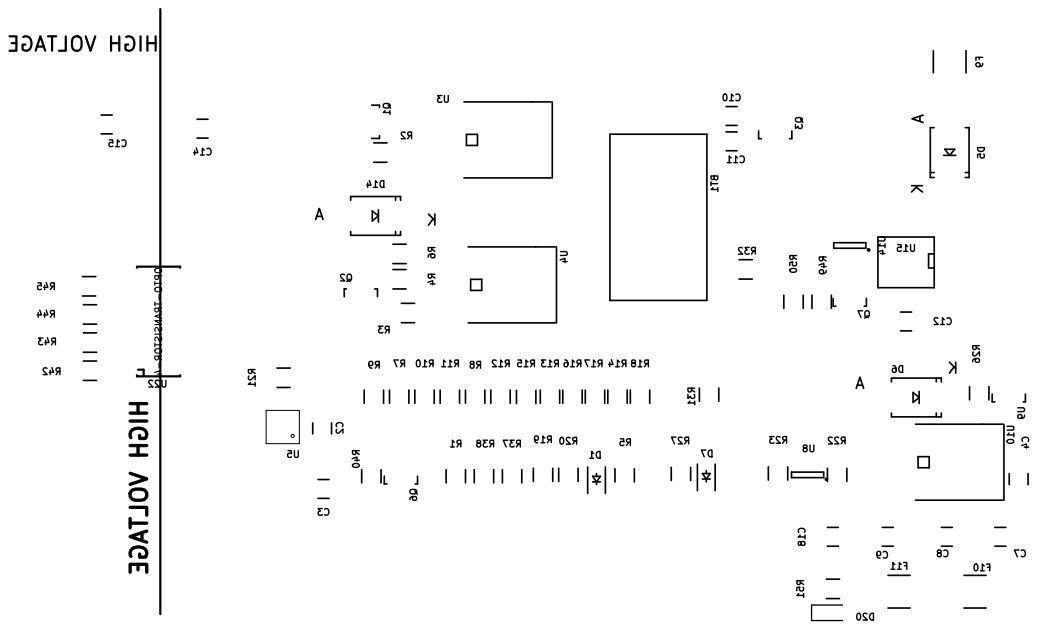
[picture p47: page 1]

HIGH VOLTAGE HIGH VOLTAGE BT1 D5 A K C2 C3 C4 C8 C7 C10 C11 C12 C14 C15 D1 D7 F9 F10 Q1 Q2 Q3 Q6 R1 R2 R3 R4 R5 R6 R9 R7 R10 R11 R8 R12 R15 R13 R16 R17 R14 R18 R19 R20 R21 R23 R22 R26 R27 R31 R32 R40 R38 R37 R42 R43 R44 R45 U3 U4 U5 U8 U9 U10 U14U15 U22 OPTO-TRANSISTOR-4
