UNCAMotorsports/UNCAMotorsports-2017/VehicleController/Gerbers/Rev02/VehicleController-F.SilkS.pdf

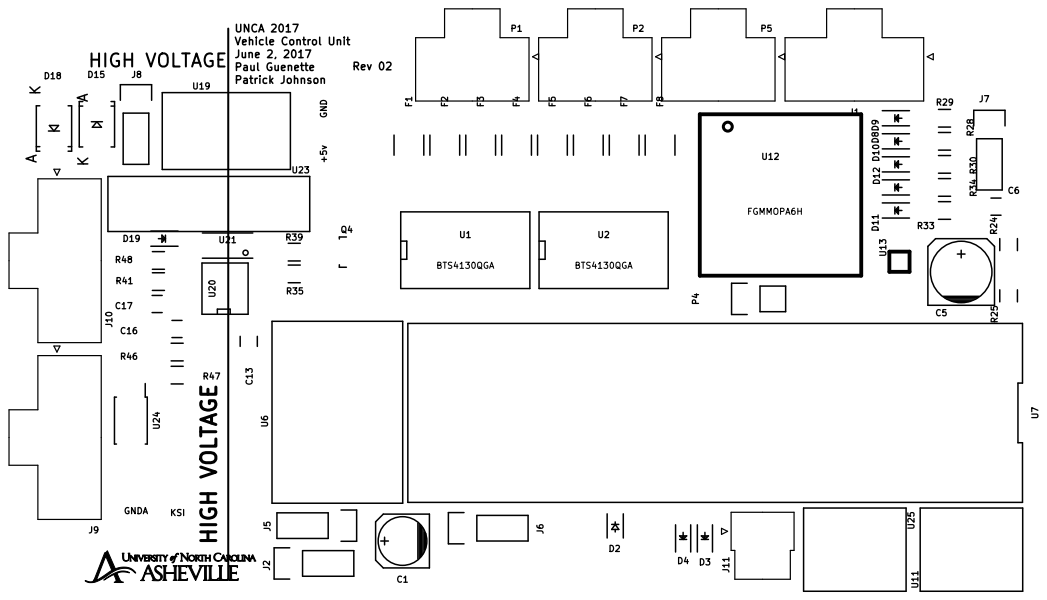
[picture p48: page 1]

Rev 02 UNCA 2017 Vehicle Control Unit June 2, 2017 Paul Guenette Patrick Johnson HIGH VOLTAGEHIGH VOLTAGE
