UNCAMotorsports/UNCAMotorsports-2017/shutdown_circuit/shutdown_circuit.pdf

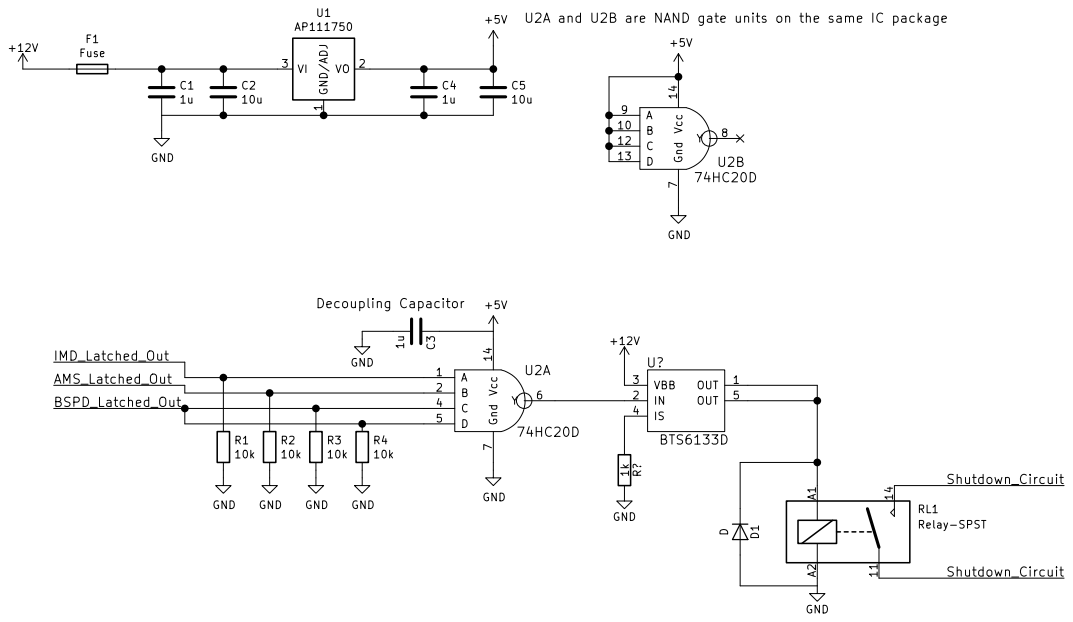
[picture p49: page 1]
