UNCAMotorsports/UNCAMotorsports-2017/tsal/tsal.pdf

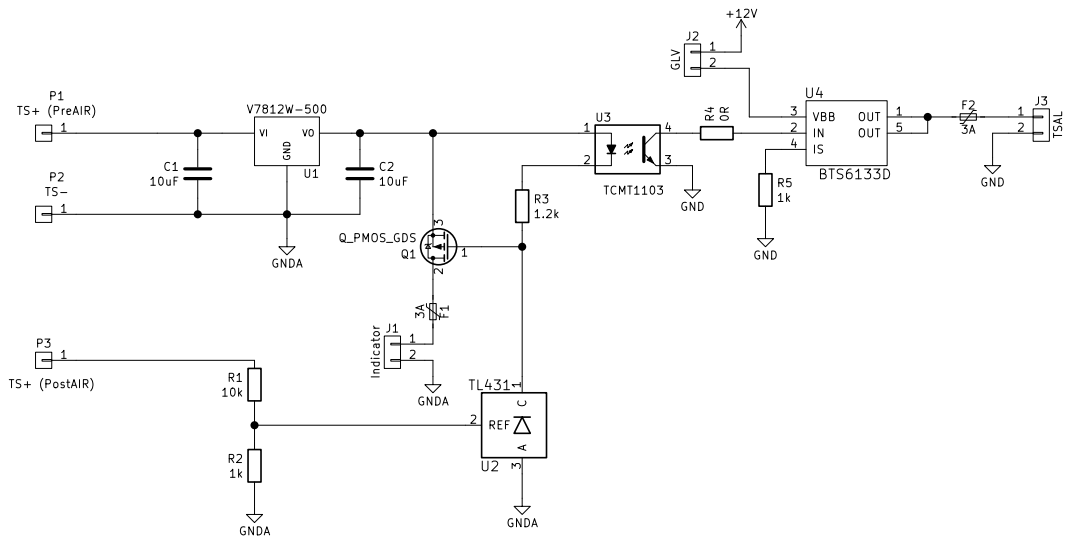
[picture p50: page 1]
