UNCAMotorsports/UNCAMotorsports-2017/C-CAN_Y17/Gerbers/C-CAN_Y17-F.Mask.pdf

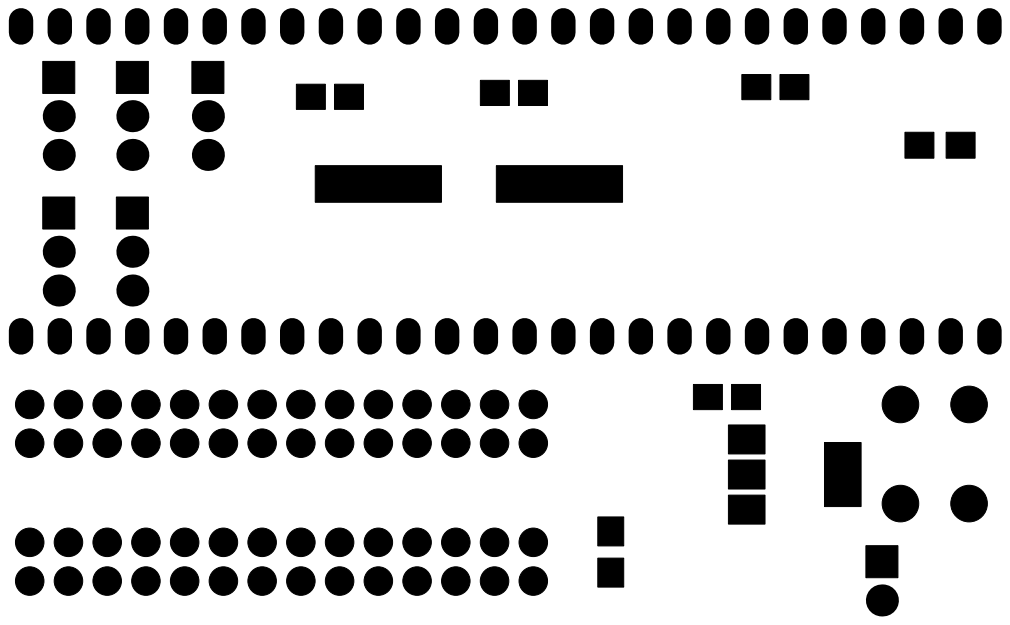
[picture p51: page 1]
