UNCAMotorsports/UNCAMotorsports-2017/VehicleController/Gerbers/Rev02/VehicleController-B.Cu.pdf

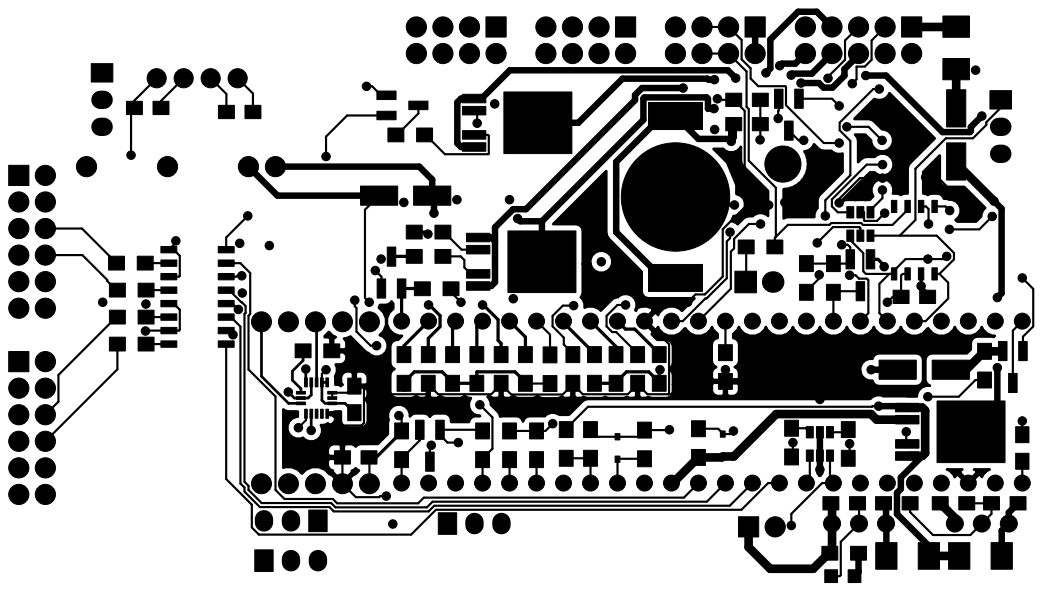
[picture p52: page 1]
