UNCAMotorsports/UNCAMotorsports-2017/VehicleController/Gerbers/Rev02/VehicleController-B.Mask.pdf

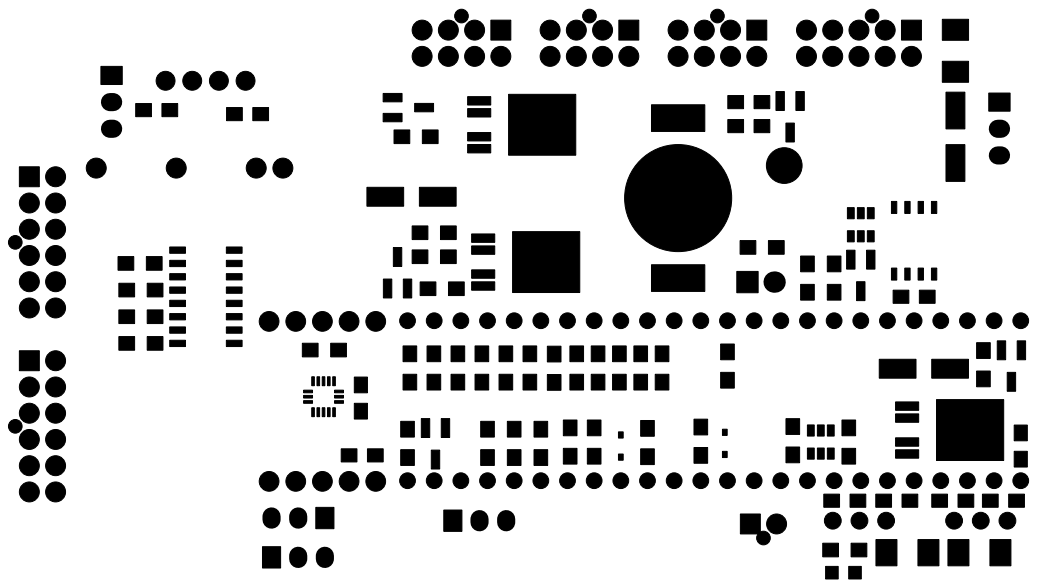
[picture p53: page 1]
