UNCAMotorsports/UNCAMotorsports-2017/VehicleController/Gerbers/Rev02/VehicleController-B.Paste.pdf

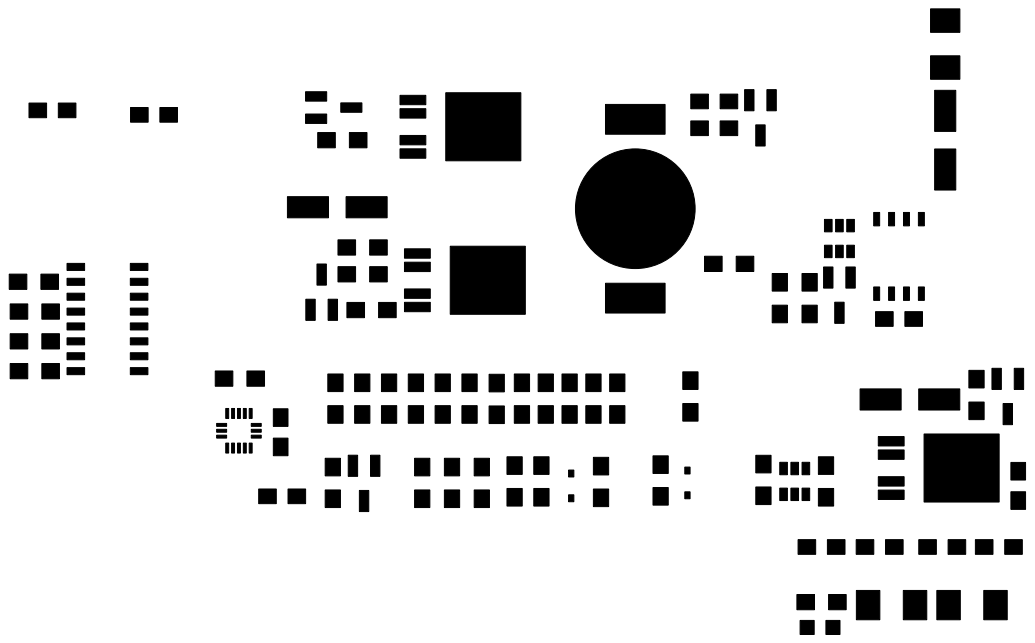
[picture p54: page 1]
