UNCAMotorsports/UNCAMotorsports-2017/VehicleController/Gerbers/Rev02/VehicleController-F.Cu.pdf

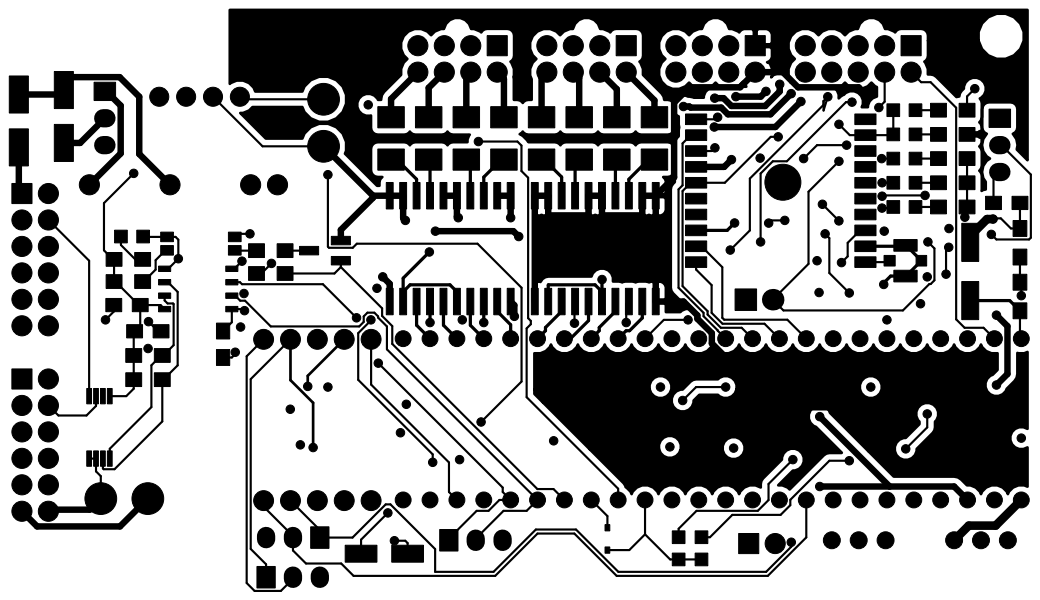
[picture p55: page 1]
