UNCAMotorsports/UNCAMotorsports-2017/VehicleController/Gerbers/Rev02/VehicleController-F.Mask.pdf

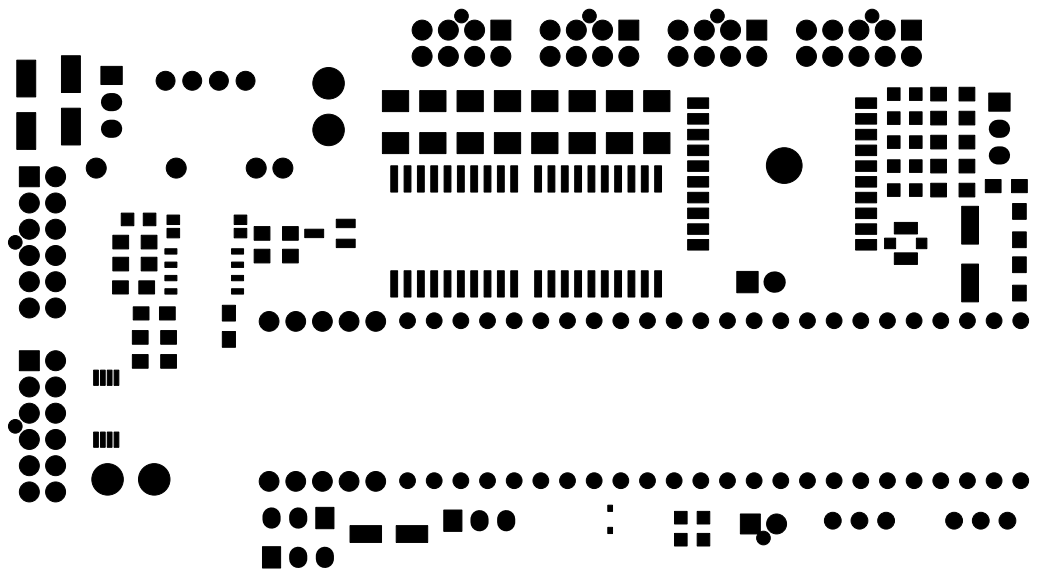
[picture p56: page 1]
