UNCAMotorsports/UNCAMotorsports-2017/VehicleController/Gerbers/Rev02/VehicleController-F.Paste.pdf

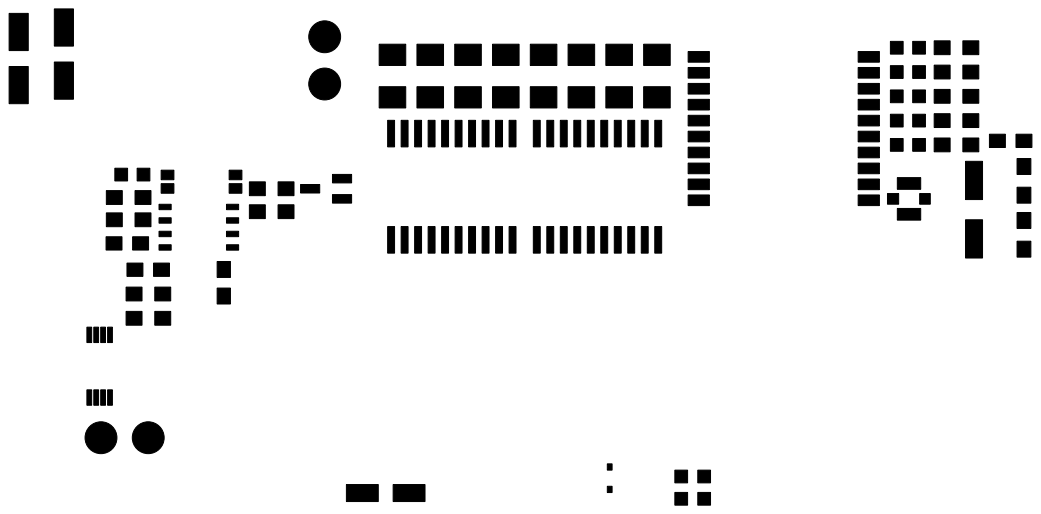
[picture p57: page 1]
