UNCAMotorsports/UNCAMotorsports-2017/VehicleController/VehicleController.ino

#include <EEPROM.h>
#include <kinetis_flexcan.h>
#include <FlexCAN.h>
#include "VC_Timers.h"
#include "VC_VarStore.h"
#include "VC_CAN.h"
#include "VCDefines.h"
#include "VC_GPS.h"
#include <i2c_t3.h>

#include "mcp47FEB22.h"

Adafruit_GPS* gpsPt;

//FlexCAN Can0(1000000);

CAN_message_t rxmsg, txmsg;
CAN_filter_t cmask;

mcp47FEB22 myDAC(0);

IntervalTimer msTimer, globalTimer;

vc_state_type state = VC_INIT_STATE;

void msTimerISR() {
    if (throttleTimer) throttleTimer--;
    if (brakeTimer) brakeTimer--;
}

void globalTimerISR(){
    static uint32_t masterTimer = 0;    // This only gets executed the first time the function is called
    masterTimer++;
    if (masterTimer % (1000 / MSG_RATE_GPS) == 0) gpsFlag = true;
}

void setup(){

    // Increment & store the number of times the device has started
    uint16_t numStartups = EEPROM.read(EEPROM_STARTUP_INDEX) << 8 | EEPROM.read(EEPROM_STARTUP_INDEX + 1);
    numStartups++;
    EEPROM.write(EEPROM_STARTUP_INDEX, numStartups >> 8);   // MSB
    EEPROM.write(EEPROM_STARTUP_INDEX + 1, numStartups & 0xff); // LSB

    // Set Pin Modes
    pinMode(PIN_START_CAR, INPUT_PULLUP);
    pinMode(PIN_BRAKE_IN, INPUT);
    pinMode(PIN_1PPS, INPUT);
    pinMode(PIN_3D_FIX, INPUT);
    pinMode(PIN_IMD_F, INPUT);
    pinMode(PIN_AMS_F, INPUT);
    pinMode(PIN_BATT_SENSE, INPUT);

    pinMode(PIN_FAULT_L1, INPUT);
    pinMode(PIN_FAULT_L2, INPUT);
    pinMode(PIN_FAULT_R1, INPUT);
    pinMode(PIN_FAULT_R2, INPUT);

    // Set 12V Output Pin initial state
    pinMode(PIN_12V_0, OUTPUT);
    pinMode(PIN_12V_1, OUTPUT);
    pinMode(PIN_12V_2, OUTPUT);
    pinMode(PIN_12V_3, OUTPUT);

    digitalWriteFast(PIN_12V_0, LOW);
    digitalWriteFast(PIN_12V_1, LOW);
    digitalWriteFast(PIN_12V_2, LOW);
    digitalWriteFast(PIN_12V_3, LOW);

    // Set 5V Output Pin initial state
    pinMode(PIN_5V_0, OUTPUT);
    pinMode(PIN_5V_1, OUTPUT);
    pinMode(PIN_5V_2, OUTPUT);
    pinMode(PIN_5V_3, OUTPUT);

    digitalWriteFast(PIN_5V_0, LOW);
    digitalWriteFast(PIN_5V_1, LOW);
    digitalWriteFast(PIN_5V_2, LOW);
    digitalWriteFast(PIN_5V_3, LOW);

    // DAC Latch is Active LOW, but is actually NC
    pinMode(PIN_DAC_LATCH, OUTPUT);
    digitalWriteFast(PIN_DAC_LATCH, LOW);

    // CLOSE_AIR controls the +AIR (powered from TSMS)
    pinMode(PIN_CLOSE_AIR, OUTPUT);
    digitalWriteFast(PIN_CLOSE_AIR, LOW);

    // GPS Reset is active low, so make sure we're out of RESET
    pinMode(PIN_GPS_RST, OUTPUT);
    digitalWriteFast(PIN_GPS_RST, HIGH);

    // Precharge is a relay coil, powered by a low side N-FET.  Active HIGH
    pinMode(PIN_PRECHARGE, OUTPUT);
    digitalWriteFast(PIN_PRECHARGE, LOW);

    // Controls the shutdown circuit via high side driver.  Active HIGH
    pinMode(PIN_SHUTDOWN_CTRL, OUTPUT);
    digitalWriteFast(PIN_SHUTDOWN_CTRL, LOW);

    // SENTRAL/Sensor Fusion interrupt.  Not connected due to board mistake.
    pinMode(PIN_IMU_INT, INPUT);

    // Analog pin for sensing battery voltage
    pinMode(PIN_BATT_SENSE, INPUT);

    // Analog pin for sensing shutdown circuit current
    pinMode(PIN_SHUTDOWN_CURRENT, INPUT);

    // Set Analog reads to 12 bits
    analogReadResolution(12);

    Serial.begin(VC_SERIAL_BAUD);
    Serial.print("UNCA Motorsports VCU Firmware Version ");
    Serial.println(VC_FW_VERSION);

    uint16_t battVal = analogRead(PIN_BATT_SENSE);
    Serial.print("Battery Voltage: ");
    Serial.print(battVal*battVal*0.000003 - 0.0073*battVal + 11.738);   // Calculated from curve regression test
    Serial.println("V");

    // Let's wait a bit to make sure the Serial monitor etc catch up.
    delay(1000);
    
    // Initialize CAN Bus
    cmask.ext = 0;
    cmask.id = 0;
    cmask.rtr = 0;
    Can0.begin();


    // Initialize GPS Module
    gpsBegin();
    gpsPt = getGPS();

    // Initialize I2C Busses
    // Start the Sensor Fusion bus
    Wire.begin(I2C_MASTER, 0, I2C_PINS_18_19, I2C_PULLUP_INT, I2C_RATE_400);
#ifdef DEBUG_I2C
    Serial.println("I2C Bus 0: ");
    scanI2CBus(&Wire);
    Serial.println("Done scanning bus 0.");
#endif

    // Start the DAC bus
    Wire1.begin(I2C_MASTER, 0, I2C_PINS_37_38, I2C_PULLUP_EXT, I2C_RATE_400);
#ifdef DEBUG_I2C
    Serial.println("I2C Bus 1: ");
    scanI2CBus(&Wire1);
    Serial.println("Done scanning bus 1.");
#endif

    // Start communication to the DAC & zero the outputs
    myDAC.begin();
    myDAC.analogWrite(0, 0);

#ifdef DEBUG_STATE
    Serial.println("State: INIT_STATE");
#endif

    Serial.println("Waiting on CAN Bus");
    
    while (!Can0.available()){
        checkIncomingBytes();
		Can0.read(rxmsg);
    }
    Serial.println("First CAN message received!");

    globalTimer.begin(globalTimerISR, 1000);    // Starts an IntervalTimer which calls globalTimerISR at 1000Hz (1ms)
}

void loop(){

    // Check for bytes waiting on the Serial connection (Primarily for debug purposes)
    checkIncomingBytes();

    if (Can0.available()) {
        Can0.read(rxmsg);
        handleCANMessage(&rxmsg);
    }

    // This will eventually update the fields in the Adafruit_GPS object
    // Accessing data can be done through the "gpsPt" pointer, as shown below
    gpsTask();

    // gpsFlag is set by globalTimer at 10Hz
    if (gpsFlag){
        txmsg.id = CAN_MSG_GPSTIME; // See VC_CAN.h for enum list
        txmsg.ext = 0;  // 11-bit frame, true for 29-bit frame
        txmsg.len = 8;  // Bytes in data field
        txmsg.buf[0] = gpsPt->year;
        txmsg.buf[1] = gpsPt->month;
        txmsg.buf[2] = gpsPt->day;
        txmsg.buf[3] = gpsPt->hour;
        txmsg.buf[4] = gpsPt->minute;
        txmsg.buf[5] = gpsPt->seconds;
        txmsg.buf[6] = gpsPt->milliseconds >> 8;    // MSB
        txmsg.buf[7] = gpsPt->milliseconds & 0xff;  // LSB
        Can0.write(txmsg);

        gpsFlag = false;
    }

    if (state == VC_INIT_STATE) {
        
        // Start the car!
        if(digitalRead(PIN_START_CAR) == LOW){

            // Beep the beeper
            //digitalWriteFast(PIN_5V_0, HIGH);
            //delay(1500);
            //digitalWriteFast(PIN_5V_0, LOW);

            // Close the shutdown circuit, and precharge for 100ms
            digitalWriteFast(PIN_SHUTDOWN_CTRL, HIGH);
            
            digitalWriteFast(PIN_PRECHARGE, HIGH);
            delay(100);

            // Close AIR+
            digitalWriteFast(PIN_CLOSE_AIR, HIGH);
            delay(100);

            // Open Precharge relay
            digitalWriteFast(PIN_PRECHARGE, LOW);
            delay(100);
            

#ifndef DEBUG_NO_TIMEOUTS
            msTimer.begin(msTimerISR, 1000); // Starts a 1ms timer interrupt
#endif

            state = VC_RUNNING_STATE;
#ifdef DEBUG_STATE
            Serial.println("State: RUNNING_STATE");
#endif
        }
    }

    if (state == VC_RUNNING_STATE) {

        if (digitalRead(PIN_START_CAR) == HIGH) {
            digitalWriteFast(PIN_CLOSE_AIR, LOW);
            digitalWriteFast(PIN_SHUTDOWN_CTRL, LOW);
#ifndef DEBUG_NO_TIMEOUTS
            msTimer.end();
#endif
            
#ifdef DEBUG_STATE
            Serial.println("State: INIT_STATE");
#endif
            state = VC_INIT_STATE;
        }

        uint16_t tempThrottle = getThrottle();
#ifdef DEBUG_THROTTLE
		Serial.println(tempThrottle);
#endif
        if (tempThrottle > 4095) {
            tempThrottle = 0;
            state = VC_ABORT_STATE;
        }
        myDAC.analogWrite(tempThrottle, tempThrottle);

        if (!throttleTimer) {
            state = VC_ABORT_STATE;
#ifdef DEBUG_STATE
            Serial.println("State:  ABORT_STATE");
#endif
            myDAC.analogWrite(0, 0);
            Serial.println("Throttle timeout!");
        }

        if (!brakeTimer) {
            state = VC_ABORT_STATE;
#ifdef DEBUG_STATE
            Serial.println("State:  ABORT_STATE");
#endif
            myDAC.analogWrite(0, 0);
            Serial.println("Brake timeout!");
        }
    }
}

// Called at the beginning of every loop
void checkIncomingBytes(){
    if (Serial.available()){
        char in = Serial.read();
        switch (in){
        case 'v':
            Serial.print("UNCA Motorsports VCU Firmware Version ");
            Serial.println(VC_FW_VERSION);
            break;
        case 'b':
            uint16_t battVal = analogRead(PIN_BATT_SENSE);
            Serial.print("Battery Voltage: ");
            Serial.print(battVal*battVal*0.000003 - 0.0073*battVal + 11.738);
            Serial.println("V");
            break;
        }
        Serial.clear(); // Only accept one command per transaction.
    }
}

// Begins transmission for all available addresses on a given i2c_t3 bus
// If a device reports back, this function will alert the user
void scanI2CBus(i2c_t3* buspt){
    int nDevices = 0;
    for (uint8_t i = 1; i < 127; i++){
        buspt->beginTransmission(i);
        byte error = buspt->endTransmission();

        if (error == 0){
            Serial.print("I2C Device Found at address 0x");
            if (i < 16)
                Serial.print("0");
            Serial.print(i, HEX);
            Serial.println("!");
            nDevices++;
        }

        else if (error == 4){
            Serial.print("Unknown error at address 0x");
            if (i < 16)
                Serial.print("0");
            Serial.println(i, HEX);
        }
    }
    if (nDevices == 0)
        Serial.println("No I2C Devices found.");
}
