UNCAMotorsports/UNCAMotorsports-2017/C-CAN/C-CAN_PSoC_DevKit/C-CAN.cydsn/codegentemp/cyfitter.h

#ifndef INCLUDED_CYFITTER_H
#define INCLUDED_CYFITTER_H
#include "cydevice.h"
#include "cydevice_trm.h"

/* one */
#define one__0__INTTYPE CYREG_PICU3_INTTYPE0
#define one__0__MASK 0x01u
#define one__0__PC CYREG_PRT3_PC0
#define one__0__PORT 3u
#define one__0__SHIFT 0u
#define one__AG CYREG_PRT3_AG
#define one__AMUX CYREG_PRT3_AMUX
#define one__BIE CYREG_PRT3_BIE
#define one__BIT_MASK CYREG_PRT3_BIT_MASK
#define one__BYP CYREG_PRT3_BYP
#define one__CTL CYREG_PRT3_CTL
#define one__DM0 CYREG_PRT3_DM0
#define one__DM1 CYREG_PRT3_DM1
#define one__DM2 CYREG_PRT3_DM2
#define one__DR CYREG_PRT3_DR
#define one__INP_DIS CYREG_PRT3_INP_DIS
#define one__INTTYPE_BASE CYDEV_PICU_INTTYPE_PICU3_BASE
#define one__LCD_COM_SEG CYREG_PRT3_LCD_COM_SEG
#define one__LCD_EN CYREG_PRT3_LCD_EN
#define one__MASK 0x01u
#define one__PORT 3u
#define one__PRT CYREG_PRT3_PRT
#define one__PRTDSI__CAPS_SEL CYREG_PRT3_CAPS_SEL
#define one__PRTDSI__DBL_SYNC_IN CYREG_PRT3_DBL_SYNC_IN
#define one__PRTDSI__OE_SEL0 CYREG_PRT3_OE_SEL0
#define one__PRTDSI__OE_SEL1 CYREG_PRT3_OE_SEL1
#define one__PRTDSI__OUT_SEL0 CYREG_PRT3_OUT_SEL0
#define one__PRTDSI__OUT_SEL1 CYREG_PRT3_OUT_SEL1
#define one__PRTDSI__SYNC_OUT CYREG_PRT3_SYNC_OUT
#define one__PS CYREG_PRT3_PS
#define one__SHIFT 0u
#define one__SLW CYREG_PRT3_SLW

/* two */
#define two__0__INTTYPE CYREG_PICU3_INTTYPE1
#define two__0__MASK 0x02u
#define two__0__PC CYREG_PRT3_PC1
#define two__0__PORT 3u
#define two__0__SHIFT 1u
#define two__AG CYREG_PRT3_AG
#define two__AMUX CYREG_PRT3_AMUX
#define two__BIE CYREG_PRT3_BIE
#define two__BIT_MASK CYREG_PRT3_BIT_MASK
#define two__BYP CYREG_PRT3_BYP
#define two__CTL CYREG_PRT3_CTL
#define two__DM0 CYREG_PRT3_DM0
#define two__DM1 CYREG_PRT3_DM1
#define two__DM2 CYREG_PRT3_DM2
#define two__DR CYREG_PRT3_DR
#define two__INP_DIS CYREG_PRT3_INP_DIS
#define two__INTTYPE_BASE CYDEV_PICU_INTTYPE_PICU3_BASE
#define two__LCD_COM_SEG CYREG_PRT3_LCD_COM_SEG
#define two__LCD_EN CYREG_PRT3_LCD_EN
#define two__MASK 0x02u
#define two__PORT 3u
#define two__PRT CYREG_PRT3_PRT
#define two__PRTDSI__CAPS_SEL CYREG_PRT3_CAPS_SEL
#define two__PRTDSI__DBL_SYNC_IN CYREG_PRT3_DBL_SYNC_IN
#define two__PRTDSI__OE_SEL0 CYREG_PRT3_OE_SEL0
#define two__PRTDSI__OE_SEL1 CYREG_PRT3_OE_SEL1
#define two__PRTDSI__OUT_SEL0 CYREG_PRT3_OUT_SEL0
#define two__PRTDSI__OUT_SEL1 CYREG_PRT3_OUT_SEL1
#define two__PRTDSI__SYNC_OUT CYREG_PRT3_SYNC_OUT
#define two__PS CYREG_PRT3_PS
#define two__SHIFT 1u
#define two__SLW CYREG_PRT3_SLW

/* RX_2 */
#define RX_2__0__INTTYPE CYREG_PICU1_INTTYPE4
#define RX_2__0__MASK 0x10u
#define RX_2__0__PC CYREG_PRT1_PC4
#define RX_2__0__PORT 1u
#define RX_2__0__SHIFT 4u
#define RX_2__AG CYREG_PRT1_AG
#define RX_2__AMUX CYREG_PRT1_AMUX
#define RX_2__BIE CYREG_PRT1_BIE
#define RX_2__BIT_MASK CYREG_PRT1_BIT_MASK
#define RX_2__BYP CYREG_PRT1_BYP
#define RX_2__CTL CYREG_PRT1_CTL
#define RX_2__DM0 CYREG_PRT1_DM0
#define RX_2__DM1 CYREG_PRT1_DM1
#define RX_2__DM2 CYREG_PRT1_DM2
#define RX_2__DR CYREG_PRT1_DR
#define RX_2__INP_DIS CYREG_PRT1_INP_DIS
#define RX_2__INTTYPE_BASE CYDEV_PICU_INTTYPE_PICU1_BASE
#define RX_2__LCD_COM_SEG CYREG_PRT1_LCD_COM_SEG
#define RX_2__LCD_EN CYREG_PRT1_LCD_EN
#define RX_2__MASK 0x10u
#define RX_2__PORT 1u
#define RX_2__PRT CYREG_PRT1_PRT
#define RX_2__PRTDSI__CAPS_SEL CYREG_PRT1_CAPS_SEL
#define RX_2__PRTDSI__DBL_SYNC_IN CYREG_PRT1_DBL_SYNC_IN
#define RX_2__PRTDSI__OE_SEL0 CYREG_PRT1_OE_SEL0
#define RX_2__PRTDSI__OE_SEL1 CYREG_PRT1_OE_SEL1
#define RX_2__PRTDSI__OUT_SEL0 CYREG_PRT1_OUT_SEL0
#define RX_2__PRTDSI__OUT_SEL1 CYREG_PRT1_OUT_SEL1
#define RX_2__PRTDSI__SYNC_OUT CYREG_PRT1_SYNC_OUT
#define RX_2__PS CYREG_PRT1_PS
#define RX_2__SHIFT 4u
#define RX_2__SLW CYREG_PRT1_SLW

/* TX_2 */
#define TX_2__0__INTTYPE CYREG_PICU1_INTTYPE5
#define TX_2__0__MASK 0x20u
#define TX_2__0__PC CYREG_PRT1_PC5
#define TX_2__0__PORT 1u
#define TX_2__0__SHIFT 5u
#define TX_2__AG CYREG_PRT1_AG
#define TX_2__AMUX CYREG_PRT1_AMUX
#define TX_2__BIE CYREG_PRT1_BIE
#define TX_2__BIT_MASK CYREG_PRT1_BIT_MASK
#define TX_2__BYP CYREG_PRT1_BYP
#define TX_2__CTL CYREG_PRT1_CTL
#define TX_2__DM0 CYREG_PRT1_DM0
#define TX_2__DM1 CYREG_PRT1_DM1
#define TX_2__DM2 CYREG_PRT1_DM2
#define TX_2__DR CYREG_PRT1_DR
#define TX_2__INP_DIS CYREG_PRT1_INP_DIS
#define TX_2__INTTYPE_BASE CYDEV_PICU_INTTYPE_PICU1_BASE
#define TX_2__LCD_COM_SEG CYREG_PRT1_LCD_COM_SEG
#define TX_2__LCD_EN CYREG_PRT1_LCD_EN
#define TX_2__MASK 0x20u
#define TX_2__PORT 1u
#define TX_2__PRT CYREG_PRT1_PRT
#define TX_2__PRTDSI__CAPS_SEL CYREG_PRT1_CAPS_SEL
#define TX_2__PRTDSI__DBL_SYNC_IN CYREG_PRT1_DBL_SYNC_IN
#define TX_2__PRTDSI__OE_SEL0 CYREG_PRT1_OE_SEL0
#define TX_2__PRTDSI__OE_SEL1 CYREG_PRT1_OE_SEL1
#define TX_2__PRTDSI__OUT_SEL0 CYREG_PRT1_OUT_SEL0
#define TX_2__PRTDSI__OUT_SEL1 CYREG_PRT1_OUT_SEL1
#define TX_2__PRTDSI__SYNC_OUT CYREG_PRT1_SYNC_OUT
#define TX_2__PS CYREG_PRT1_PS
#define TX_2__SHIFT 5u
#define TX_2__SLW CYREG_PRT1_SLW

/* four */
#define four__0__INTTYPE CYREG_PICU3_INTTYPE4
#define four__0__MASK 0x10u
#define four__0__PC CYREG_PRT3_PC4
#define four__0__PORT 3u
#define four__0__SHIFT 4u
#define four__AG CYREG_PRT3_AG
#define four__AMUX CYREG_PRT3_AMUX
#define four__BIE CYREG_PRT3_BIE
#define four__BIT_MASK CYREG_PRT3_BIT_MASK
#define four__BYP CYREG_PRT3_BYP
#define four__CTL CYREG_PRT3_CTL
#define four__DM0 CYREG_PRT3_DM0
#define four__DM1 CYREG_PRT3_DM1
#define four__DM2 CYREG_PRT3_DM2
#define four__DR CYREG_PRT3_DR
#define four__INP_DIS CYREG_PRT3_INP_DIS
#define four__INTTYPE_BASE CYDEV_PICU_INTTYPE_PICU3_BASE
#define four__LCD_COM_SEG CYREG_PRT3_LCD_COM_SEG
#define four__LCD_EN CYREG_PRT3_LCD_EN
#define four__MASK 0x10u
#define four__PORT 3u
#define four__PRT CYREG_PRT3_PRT
#define four__PRTDSI__CAPS_SEL CYREG_PRT3_CAPS_SEL
#define four__PRTDSI__DBL_SYNC_IN CYREG_PRT3_DBL_SYNC_IN
#define four__PRTDSI__OE_SEL0 CYREG_PRT3_OE_SEL0
#define four__PRTDSI__OE_SEL1 CYREG_PRT3_OE_SEL1
#define four__PRTDSI__OUT_SEL0 CYREG_PRT3_OUT_SEL0
#define four__PRTDSI__OUT_SEL1 CYREG_PRT3_OUT_SEL1
#define four__PRTDSI__SYNC_OUT CYREG_PRT3_SYNC_OUT
#define four__PS CYREG_PRT3_PS
#define four__SHIFT 4u
#define four__SLW CYREG_PRT3_SLW

/* CAN_1_CanIP */
#define CAN_1_CanIP__CSR_BUF_SR CYREG_CAN0_CSR_BUF_SR
#define CAN_1_CanIP__CSR_CFG CYREG_CAN0_CSR_CFG
#define CAN_1_CanIP__CSR_CMD CYREG_CAN0_CSR_CMD
#define CAN_1_CanIP__CSR_ERR_SR CYREG_CAN0_CSR_ERR_SR
#define CAN_1_CanIP__CSR_INT_EN CYREG_CAN0_CSR_INT_EN
#define CAN_1_CanIP__CSR_INT_SR CYREG_CAN0_CSR_INT_SR
#define CAN_1_CanIP__PM_ACT_CFG CYREG_PM_ACT_CFG6
#define CAN_1_CanIP__PM_ACT_MSK 0x01u
#define CAN_1_CanIP__PM_STBY_CFG CYREG_PM_STBY_CFG6
#define CAN_1_CanIP__PM_STBY_MSK 0x01u
#define CAN_1_CanIP__RX0_ACR CYREG_CAN0_RX0_ACR
#define CAN_1_CanIP__RX0_ACRD CYREG_CAN0_RX0_ACRD
#define CAN_1_CanIP__RX0_AMR CYREG_CAN0_RX0_AMR
#define CAN_1_CanIP__RX0_AMRD CYREG_CAN0_RX0_AMRD
#define CAN_1_CanIP__RX0_CMD CYREG_CAN0_RX0_CMD
#define CAN_1_CanIP__RX0_DH CYREG_CAN0_RX0_DH
#define CAN_1_CanIP__RX0_DL CYREG_CAN0_RX0_DL
#define CAN_1_CanIP__RX0_ID CYREG_CAN0_RX0_ID
#define CAN_1_CanIP__RX1_ACR CYREG_CAN0_RX1_ACR
#define CAN_1_CanIP__RX1_ACRD CYREG_CAN0_RX1_ACRD
#define CAN_1_CanIP__RX1_AMR CYREG_CAN0_RX1_AMR
#define CAN_1_CanIP__RX1_AMRD CYREG_CAN0_RX1_AMRD
#define CAN_1_CanIP__RX1_CMD CYREG_CAN0_RX1_CMD
#define CAN_1_CanIP__RX1_DH CYREG_CAN0_RX1_DH
#define CAN_1_CanIP__RX1_DL CYREG_CAN0_RX1_DL
#define CAN_1_CanIP__RX1_ID CYREG_CAN0_RX1_ID
#define CAN_1_CanIP__RX10_ACR CYREG_CAN0_RX10_ACR
#define CAN_1_CanIP__RX10_ACRD CYREG_CAN0_RX10_ACRD
#define CAN_1_CanIP__RX10_AMR CYREG_CAN0_RX10_AMR
#define CAN_1_CanIP__RX10_AMRD CYREG_CAN0_RX10_AMRD
#define CAN_1_CanIP__RX10_CMD CYREG_CAN0_RX10_CMD
#define CAN_1_CanIP__RX10_DH CYREG_CAN0_RX10_DH
#define CAN_1_CanIP__RX10_DL CYREG_CAN0_RX10_DL
#define CAN_1_CanIP__RX10_ID CYREG_CAN0_RX10_ID
#define CAN_1_CanIP__RX11_ACR CYREG_CAN0_RX11_ACR
#define CAN_1_CanIP__RX11_ACRD CYREG_CAN0_RX11_ACRD
#define CAN_1_CanIP__RX11_AMR CYREG_CAN0_RX11_AMR
#define CAN_1_CanIP__RX11_AMRD CYREG_CAN0_RX11_AMRD
#define CAN_1_CanIP__RX11_CMD CYREG_CAN0_RX11_CMD
#define CAN_1_CanIP__RX11_DH CYREG_CAN0_RX11_DH
#define CAN_1_CanIP__RX11_DL CYREG_CAN0_RX11_DL
#define CAN_1_CanIP__RX11_ID CYREG_CAN0_RX11_ID
#define CAN_1_CanIP__RX12_ACR CYREG_CAN0_RX12_ACR
#define CAN_1_CanIP__RX12_ACRD CYREG_CAN0_RX12_ACRD
#define CAN_1_CanIP__RX12_AMR CYREG_CAN0_RX12_AMR
#define CAN_1_CanIP__RX12_AMRD CYREG_CAN0_RX12_AMRD
#define CAN_1_CanIP__RX12_CMD CYREG_CAN0_RX12_CMD
#define CAN_1_CanIP__RX12_DH CYREG_CAN0_RX12_DH
#define CAN_1_CanIP__RX12_DL CYREG_CAN0_RX12_DL
#define CAN_1_CanIP__RX12_ID CYREG_CAN0_RX12_ID
#define CAN_1_CanIP__RX13_ACR CYREG_CAN0_RX13_ACR
#define CAN_1_CanIP__RX13_ACRD CYREG_CAN0_RX13_ACRD
#define CAN_1_CanIP__RX13_AMR CYREG_CAN0_RX13_AMR
#define CAN_1_CanIP__RX13_AMRD CYREG_CAN0_RX13_AMRD
#define CAN_1_CanIP__RX13_CMD CYREG_CAN0_RX13_CMD
#define CAN_1_CanIP__RX13_DH CYREG_CAN0_RX13_DH
#define CAN_1_CanIP__RX13_DL CYREG_CAN0_RX13_DL
#define CAN_1_CanIP__RX13_ID CYREG_CAN0_RX13_ID
#define CAN_1_CanIP__RX14_ACR CYREG_CAN0_RX14_ACR
#define CAN_1_CanIP__RX14_ACRD CYREG_CAN0_RX14_ACRD
#define CAN_1_CanIP__RX14_AMR CYREG_CAN0_RX14_AMR
#define CAN_1_CanIP__RX14_AMRD CYREG_CAN0_RX14_AMRD
#define CAN_1_CanIP__RX14_CMD CYREG_CAN0_RX14_CMD
#define CAN_1_CanIP__RX14_DH CYREG_CAN0_RX14_DH
#define CAN_1_CanIP__RX14_DL CYREG_CAN0_RX14_DL
#define CAN_1_CanIP__RX14_ID CYREG_CAN0_RX14_ID
#define CAN_1_CanIP__RX15_ACR CYREG_CAN0_RX15_ACR
#define CAN_1_CanIP__RX15_ACRD CYREG_CAN0_RX15_ACRD
#define CAN_1_CanIP__RX15_AMR CYREG_CAN0_RX15_AMR
#define CAN_1_CanIP__RX15_AMRD CYREG_CAN0_RX15_AMRD
#define CAN_1_CanIP__RX15_CMD CYREG_CAN0_RX15_CMD
#define CAN_1_CanIP__RX15_DH CYREG_CAN0_RX15_DH
#define CAN_1_CanIP__RX15_DL CYREG_CAN0_RX15_DL
#define CAN_1_CanIP__RX15_ID CYREG_CAN0_RX15_ID
#define CAN_1_CanIP__RX2_ACR CYREG_CAN0_RX2_ACR
#define CAN_1_CanIP__RX2_ACRD CYREG_CAN0_RX2_ACRD
#define CAN_1_CanIP__RX2_AMR CYREG_CAN0_RX2_AMR
#define CAN_1_CanIP__RX2_AMRD CYREG_CAN0_RX2_AMRD
#define CAN_1_CanIP__RX2_CMD CYREG_CAN0_RX2_CMD
#define CAN_1_CanIP__RX2_DH CYREG_CAN0_RX2_DH
#define CAN_1_CanIP__RX2_DL CYREG_CAN0_RX2_DL
#define CAN_1_CanIP__RX2_ID CYREG_CAN0_RX2_ID
#define CAN_1_CanIP__RX3_ACR CYREG_CAN0_RX3_ACR
#define CAN_1_CanIP__RX3_ACRD CYREG_CAN0_RX3_ACRD
#define CAN_1_CanIP__RX3_AMR CYREG_CAN0_RX3_AMR
#define CAN_1_CanIP__RX3_AMRD CYREG_CAN0_RX3_AMRD
#define CAN_1_CanIP__RX3_CMD CYREG_CAN0_RX3_CMD
#define CAN_1_CanIP__RX3_DH CYREG_CAN0_RX3_DH
#define CAN_1_CanIP__RX3_DL CYREG_CAN0_RX3_DL
#define CAN_1_CanIP__RX3_ID CYREG_CAN0_RX3_ID
#define CAN_1_CanIP__RX4_ACR CYREG_CAN0_RX4_ACR
#define CAN_1_CanIP__RX4_ACRD CYREG_CAN0_RX4_ACRD
#define CAN_1_CanIP__RX4_AMR CYREG_CAN0_RX4_AMR
#define CAN_1_CanIP__RX4_AMRD CYREG_CAN0_RX4_AMRD
#define CAN_1_CanIP__RX4_CMD CYREG_CAN0_RX4_CMD
#define CAN_1_CanIP__RX4_DH CYREG_CAN0_RX4_DH
#define CAN_1_CanIP__RX4_DL CYREG_CAN0_RX4_DL
#define CAN_1_CanIP__RX4_ID CYREG_CAN0_RX4_ID
#define CAN_1_CanIP__RX5_ACR CYREG_CAN0_RX5_ACR
#define CAN_1_CanIP__RX5_ACRD CYREG_CAN0_RX5_ACRD
#define CAN_1_CanIP__RX5_AMR CYREG_CAN0_RX5_AMR
#define CAN_1_CanIP__RX5_AMRD CYREG_CAN0_RX5_AMRD
#define CAN_1_CanIP__RX5_CMD CYREG_CAN0_RX5_CMD
#define CAN_1_CanIP__RX5_DH CYREG_CAN0_RX5_DH
#define CAN_1_CanIP__RX5_DL CYREG_CAN0_RX5_DL
#define CAN_1_CanIP__RX5_ID CYREG_CAN0_RX5_ID
#define CAN_1_CanIP__RX6_ACR CYREG_CAN0_RX6_ACR
#define CAN_1_CanIP__RX6_ACRD CYREG_CAN0_RX6_ACRD
#define CAN_1_CanIP__RX6_AMR CYREG_CAN0_RX6_AMR
#define CAN_1_CanIP__RX6_AMRD CYREG_CAN0_RX6_AMRD
#define CAN_1_CanIP__RX6_CMD CYREG_CAN0_RX6_CMD
#define CAN_1_CanIP__RX6_DH CYREG_CAN0_RX6_DH
#define CAN_1_CanIP__RX6_DL CYREG_CAN0_RX6_DL
#define CAN_1_CanIP__RX6_ID CYREG_CAN0_RX6_ID
#define CAN_1_CanIP__RX7_ACR CYREG_CAN0_RX7_ACR
#define CAN_1_CanIP__RX7_ACRD CYREG_CAN0_RX7_ACRD
#define CAN_1_CanIP__RX7_AMR CYREG_CAN0_RX7_AMR
#define CAN_1_CanIP__RX7_AMRD CYREG_CAN0_RX7_AMRD
#define CAN_1_CanIP__RX7_CMD CYREG_CAN0_RX7_CMD
#define CAN_1_CanIP__RX7_DH CYREG_CAN0_RX7_DH
#define CAN_1_CanIP__RX7_DL CYREG_CAN0_RX7_DL
#define CAN_1_CanIP__RX7_ID CYREG_CAN0_RX7_ID
#define CAN_1_CanIP__RX8_ACR CYREG_CAN0_RX8_ACR
#define CAN_1_CanIP__RX8_ACRD CYREG_CAN0_RX8_ACRD
#define CAN_1_CanIP__RX8_AMR CYREG_CAN0_RX8_AMR
#define CAN_1_CanIP__RX8_AMRD CYREG_CAN0_RX8_AMRD
#define CAN_1_CanIP__RX8_CMD CYREG_CAN0_RX8_CMD
#define CAN_1_CanIP__RX8_DH CYREG_CAN0_RX8_DH
#define CAN_1_CanIP__RX8_DL CYREG_CAN0_RX8_DL
#define CAN_1_CanIP__RX8_ID CYREG_CAN0_RX8_ID
#define CAN_1_CanIP__RX9_ACR CYREG_CAN0_RX9_ACR
#define CAN_1_CanIP__RX9_ACRD CYREG_CAN0_RX9_ACRD
#define CAN_1_CanIP__RX9_AMR CYREG_CAN0_RX9_AMR
#define CAN_1_CanIP__RX9_AMRD CYREG_CAN0_RX9_AMRD
#define CAN_1_CanIP__RX9_CMD CYREG_CAN0_RX9_CMD
#define CAN_1_CanIP__RX9_DH CYREG_CAN0_RX9_DH
#define CAN_1_CanIP__RX9_DL CYREG_CAN0_RX9_DL
#define CAN_1_CanIP__RX9_ID CYREG_CAN0_RX9_ID
#define CAN_1_CanIP__TX0_CMD CYREG_CAN0_TX0_CMD
#define CAN_1_CanIP__TX0_DH CYREG_CAN0_TX0_DH
#define CAN_1_CanIP__TX0_DL CYREG_CAN0_TX0_DL
#define CAN_1_CanIP__TX0_ID CYREG_CAN0_TX0_ID
#define CAN_1_CanIP__TX1_CMD CYREG_CAN0_TX1_CMD
#define CAN_1_CanIP__TX1_DH CYREG_CAN0_TX1_DH
#define CAN_1_CanIP__TX1_DL CYREG_CAN0_TX1_DL
#define CAN_1_CanIP__TX1_ID CYREG_CAN0_TX1_ID
#define CAN_1_CanIP__TX2_CMD CYREG_CAN0_TX2_CMD
#define CAN_1_CanIP__TX2_DH CYREG_CAN0_TX2_DH
#define CAN_1_CanIP__TX2_DL CYREG_CAN0_TX2_DL
#define CAN_1_CanIP__TX2_ID CYREG_CAN0_TX2_ID
#define CAN_1_CanIP__TX3_CMD CYREG_CAN0_TX3_CMD
#define CAN_1_CanIP__TX3_DH CYREG_CAN0_TX3_DH
#define CAN_1_CanIP__TX3_DL CYREG_CAN0_TX3_DL
#define CAN_1_CanIP__TX3_ID CYREG_CAN0_TX3_ID
#define CAN_1_CanIP__TX4_CMD CYREG_CAN0_TX4_CMD
#define CAN_1_CanIP__TX4_DH CYREG_CAN0_TX4_DH
#define CAN_1_CanIP__TX4_DL CYREG_CAN0_TX4_DL
#define CAN_1_CanIP__TX4_ID CYREG_CAN0_TX4_ID
#define CAN_1_CanIP__TX5_CMD CYREG_CAN0_TX5_CMD
#define CAN_1_CanIP__TX5_DH CYREG_CAN0_TX5_DH
#define CAN_1_CanIP__TX5_DL CYREG_CAN0_TX5_DL
#define CAN_1_CanIP__TX5_ID CYREG_CAN0_TX5_ID
#define CAN_1_CanIP__TX6_CMD CYREG_CAN0_TX6_CMD
#define CAN_1_CanIP__TX6_DH CYREG_CAN0_TX6_DH
#define CAN_1_CanIP__TX6_DL CYREG_CAN0_TX6_DL
#define CAN_1_CanIP__TX6_ID CYREG_CAN0_TX6_ID
#define CAN_1_CanIP__TX7_CMD CYREG_CAN0_TX7_CMD
#define CAN_1_CanIP__TX7_DH CYREG_CAN0_TX7_DH
#define CAN_1_CanIP__TX7_DL CYREG_CAN0_TX7_DL
#define CAN_1_CanIP__TX7_ID CYREG_CAN0_TX7_ID

/* CAN_1_isr */
#define CAN_1_isr__INTC_CLR_EN_REG CYREG_NVIC_CLRENA0
#define CAN_1_isr__INTC_CLR_PD_REG CYREG_NVIC_CLRPEND0
#define CAN_1_isr__INTC_MASK 0x10000u
#define CAN_1_isr__INTC_NUMBER 16u
#define CAN_1_isr__INTC_PRIOR_NUM 7u
#define CAN_1_isr__INTC_PRIOR_REG CYREG_NVIC_PRI_16
#define CAN_1_isr__INTC_SET_EN_REG CYREG_NVIC_SETENA0
#define CAN_1_isr__INTC_SET_PD_REG CYREG_NVIC_SETPEND0

/* DMA_1 */
#define DMA_1__DRQ_CTL CYREG_IDMUX_DRQ_CTL0
#define DMA_1__DRQ_NUMBER 0u
#define DMA_1__NUMBEROF_TDS 0u
#define DMA_1__PRIORITY 2u
#define DMA_1__TERMIN_EN 0u
#define DMA_1__TERMIN_SEL 0u
#define DMA_1__TERMOUT0_EN 0u
#define DMA_1__TERMOUT0_SEL 0u
#define DMA_1__TERMOUT1_EN 0u
#define DMA_1__TERMOUT1_SEL 0u

/* three */
#define three__0__INTTYPE CYREG_PICU3_INTTYPE3
#define three__0__MASK 0x08u
#define three__0__PC CYREG_PRT3_PC3
#define three__0__PORT 3u
#define three__0__SHIFT 3u
#define three__AG CYREG_PRT3_AG
#define three__AMUX CYREG_PRT3_AMUX
#define three__BIE CYREG_PRT3_BIE
#define three__BIT_MASK CYREG_PRT3_BIT_MASK
#define three__BYP CYREG_PRT3_BYP
#define three__CTL CYREG_PRT3_CTL
#define three__DM0 CYREG_PRT3_DM0
#define three__DM1 CYREG_PRT3_DM1
#define three__DM2 CYREG_PRT3_DM2
#define three__DR CYREG_PRT3_DR
#define three__INP_DIS CYREG_PRT3_INP_DIS
#define three__INTTYPE_BASE CYDEV_PICU_INTTYPE_PICU3_BASE
#define three__LCD_COM_SEG CYREG_PRT3_LCD_COM_SEG
#define three__LCD_EN CYREG_PRT3_LCD_EN
#define three__MASK 0x08u
#define three__PORT 3u
#define three__PRT CYREG_PRT3_PRT
#define three__PRTDSI__CAPS_SEL CYREG_PRT3_CAPS_SEL
#define three__PRTDSI__DBL_SYNC_IN CYREG_PRT3_DBL_SYNC_IN
#define three__PRTDSI__OE_SEL0 CYREG_PRT3_OE_SEL0
#define three__PRTDSI__OE_SEL1 CYREG_PRT3_OE_SEL1
#define three__PRTDSI__OUT_SEL0 CYREG_PRT3_OUT_SEL0
#define three__PRTDSI__OUT_SEL1 CYREG_PRT3_OUT_SEL1
#define three__PRTDSI__SYNC_OUT CYREG_PRT3_SYNC_OUT
#define three__PS CYREG_PRT3_PS
#define three__SHIFT 3u
#define three__SLW CYREG_PRT3_SLW

/* Clock_4 */
#define Clock_4__CFG0 CYREG_CLKDIST_DCFG0_CFG0
#define Clock_4__CFG1 CYREG_CLKDIST_DCFG0_CFG1
#define Clock_4__CFG2 CYREG_CLKDIST_DCFG0_CFG2
#define Clock_4__CFG2_SRC_SEL_MASK 0x07u
#define Clock_4__INDEX 0x00u
#define Clock_4__PM_ACT_CFG CYREG_PM_ACT_CFG2
#define Clock_4__PM_ACT_MSK 0x01u
#define Clock_4__PM_STBY_CFG CYREG_PM_STBY_CFG2
#define Clock_4__PM_STBY_MSK 0x01u

/* ADC_SAR_1_ADC_SAR */
#define ADC_SAR_1_ADC_SAR__CLK CYREG_SAR0_CLK
#define ADC_SAR_1_ADC_SAR__CSR0 CYREG_SAR0_CSR0
#define ADC_SAR_1_ADC_SAR__CSR1 CYREG_SAR0_CSR1
#define ADC_SAR_1_ADC_SAR__CSR2 CYREG_SAR0_CSR2
#define ADC_SAR_1_ADC_SAR__CSR3 CYREG_SAR0_CSR3
#define ADC_SAR_1_ADC_SAR__CSR4 CYREG_SAR0_CSR4
#define ADC_SAR_1_ADC_SAR__CSR5 CYREG_SAR0_CSR5
#define ADC_SAR_1_ADC_SAR__CSR6 CYREG_SAR0_CSR6
#define ADC_SAR_1_ADC_SAR__PM_ACT_CFG CYREG_PM_ACT_CFG11
#define ADC_SAR_1_ADC_SAR__PM_ACT_MSK 0x01u
#define ADC_SAR_1_ADC_SAR__PM_STBY_CFG CYREG_PM_STBY_CFG11
#define ADC_SAR_1_ADC_SAR__PM_STBY_MSK 0x01u
#define ADC_SAR_1_ADC_SAR__SW0 CYREG_SAR0_SW0
#define ADC_SAR_1_ADC_SAR__SW2 CYREG_SAR0_SW2
#define ADC_SAR_1_ADC_SAR__SW3 CYREG_SAR0_SW3
#define ADC_SAR_1_ADC_SAR__SW4 CYREG_SAR0_SW4
#define ADC_SAR_1_ADC_SAR__SW6 CYREG_SAR0_SW6
#define ADC_SAR_1_ADC_SAR__TR0 CYREG_SAR0_TR0
#define ADC_SAR_1_ADC_SAR__WRK0 CYREG_SAR0_WRK0
#define ADC_SAR_1_ADC_SAR__WRK1 CYREG_SAR0_WRK1

/* ADC_SAR_1_Bypass */
#define ADC_SAR_1_Bypass__0__INTTYPE CYREG_PICU0_INTTYPE4
#define ADC_SAR_1_Bypass__0__MASK 0x10u
#define ADC_SAR_1_Bypass__0__PC CYREG_PRT0_PC4
#define ADC_SAR_1_Bypass__0__PORT 0u
#define ADC_SAR_1_Bypass__0__SHIFT 4u
#define ADC_SAR_1_Bypass__AG CYREG_PRT0_AG
#define ADC_SAR_1_Bypass__AMUX CYREG_PRT0_AMUX
#define ADC_SAR_1_Bypass__BIE CYREG_PRT0_BIE
#define ADC_SAR_1_Bypass__BIT_MASK CYREG_PRT0_BIT_MASK
#define ADC_SAR_1_Bypass__BYP CYREG_PRT0_BYP
#define ADC_SAR_1_Bypass__CTL CYREG_PRT0_CTL
#define ADC_SAR_1_Bypass__DM0 CYREG_PRT0_DM0
#define ADC_SAR_1_Bypass__DM1 CYREG_PRT0_DM1
#define ADC_SAR_1_Bypass__DM2 CYREG_PRT0_DM2
#define ADC_SAR_1_Bypass__DR CYREG_PRT0_DR
#define ADC_SAR_1_Bypass__INP_DIS CYREG_PRT0_INP_DIS
#define ADC_SAR_1_Bypass__INTTYPE_BASE CYDEV_PICU_INTTYPE_PICU0_BASE
#define ADC_SAR_1_Bypass__LCD_COM_SEG CYREG_PRT0_LCD_COM_SEG
#define ADC_SAR_1_Bypass__LCD_EN CYREG_PRT0_LCD_EN
#define ADC_SAR_1_Bypass__MASK 0x10u
#define ADC_SAR_1_Bypass__PORT 0u
#define ADC_SAR_1_Bypass__PRT CYREG_PRT0_PRT
#define ADC_SAR_1_Bypass__PRTDSI__CAPS_SEL CYREG_PRT0_CAPS_SEL
#define ADC_SAR_1_Bypass__PRTDSI__DBL_SYNC_IN CYREG_PRT0_DBL_SYNC_IN
#define ADC_SAR_1_Bypass__PRTDSI__OE_SEL0 CYREG_PRT0_OE_SEL0
#define ADC_SAR_1_Bypass__PRTDSI__OE_SEL1 CYREG_PRT0_OE_SEL1
#define ADC_SAR_1_Bypass__PRTDSI__OUT_SEL0 CYREG_PRT0_OUT_SEL0
#define ADC_SAR_1_Bypass__PRTDSI__OUT_SEL1 CYREG_PRT0_OUT_SEL1
#define ADC_SAR_1_Bypass__PRTDSI__SYNC_OUT CYREG_PRT0_SYNC_OUT
#define ADC_SAR_1_Bypass__PS CYREG_PRT0_PS
#define ADC_SAR_1_Bypass__SHIFT 4u
#define ADC_SAR_1_Bypass__SLW CYREG_PRT0_SLW

/* ADC_SAR_1_IRQ */
#define ADC_SAR_1_IRQ__INTC_CLR_EN_REG CYREG_NVIC_CLRENA0
#define ADC_SAR_1_IRQ__INTC_CLR_PD_REG CYREG_NVIC_CLRPEND0
#define ADC_SAR_1_IRQ__INTC_MASK 0x01u
#define ADC_SAR_1_IRQ__INTC_NUMBER 0u
#define ADC_SAR_1_IRQ__INTC_PRIOR_NUM 7u
#define ADC_SAR_1_IRQ__INTC_PRIOR_REG CYREG_NVIC_PRI_0
#define ADC_SAR_1_IRQ__INTC_SET_EN_REG CYREG_NVIC_SETENA0
#define ADC_SAR_1_IRQ__INTC_SET_PD_REG CYREG_NVIC_SETPEND0

/* Port_for_fun */
#define Port_for_fun_Sync_ctrl_reg__REMOVED 1u

/* Miscellaneous */
#define BCLK__BUS_CLK__HZ 72000000U
#define BCLK__BUS_CLK__KHZ 72000U
#define BCLK__BUS_CLK__MHZ 72U
#define CY_PROJECT_NAME "C-CAN"
#define CY_VERSION "PSoC Creator  4.0 Update 1"
#define CYDEV_CHIP_DIE_LEOPARD 1u
#define CYDEV_CHIP_DIE_PSOC4A 12u
#define CYDEV_CHIP_DIE_PSOC5LP 19u
#define CYDEV_CHIP_DIE_PSOC5TM 20u
#define CYDEV_CHIP_DIE_TMA4 2u
#define CYDEV_CHIP_DIE_UNKNOWN 0u
#define CYDEV_CHIP_FAMILY_FM0P 4u
#define CYDEV_CHIP_FAMILY_FM3 5u
#define CYDEV_CHIP_FAMILY_FM4 6u
#define CYDEV_CHIP_FAMILY_PSOC3 1u
#define CYDEV_CHIP_FAMILY_PSOC4 2u
#define CYDEV_CHIP_FAMILY_PSOC5 3u
#define CYDEV_CHIP_FAMILY_UNKNOWN 0u
#define CYDEV_CHIP_FAMILY_USED CYDEV_CHIP_FAMILY_PSOC5
#define CYDEV_CHIP_JTAG_ID 0x2E161069u
#define CYDEV_CHIP_MEMBER_3A 1u
#define CYDEV_CHIP_MEMBER_4A 12u
#define CYDEV_CHIP_MEMBER_4C 18u
#define CYDEV_CHIP_MEMBER_4D 8u
#define CYDEV_CHIP_MEMBER_4E 4u
#define CYDEV_CHIP_MEMBER_4F 13u
#define CYDEV_CHIP_MEMBER_4G 2u
#define CYDEV_CHIP_MEMBER_4H 11u
#define CYDEV_CHIP_MEMBER_4I 17u
#define CYDEV_CHIP_MEMBER_4J 9u
#define CYDEV_CHIP_MEMBER_4K 10u
#define CYDEV_CHIP_MEMBER_4L 16u
#define CYDEV_CHIP_MEMBER_4M 15u
#define CYDEV_CHIP_MEMBER_4N 6u
#define CYDEV_CHIP_MEMBER_4O 5u
#define CYDEV_CHIP_MEMBER_4P 14u
#define CYDEV_CHIP_MEMBER_4Q 7u
#define CYDEV_CHIP_MEMBER_4U 3u
#define CYDEV_CHIP_MEMBER_5A 20u
#define CYDEV_CHIP_MEMBER_5B 19u
#define CYDEV_CHIP_MEMBER_FM3 24u
#define CYDEV_CHIP_MEMBER_FM4 25u
#define CYDEV_CHIP_MEMBER_PDL_FM0P_TYPE1 21u
#define CYDEV_CHIP_MEMBER_PDL_FM0P_TYPE2 22u
#define CYDEV_CHIP_MEMBER_PDL_FM0P_TYPE3 23u
#define CYDEV_CHIP_MEMBER_UNKNOWN 0u
#define CYDEV_CHIP_MEMBER_USED CYDEV_CHIP_MEMBER_5B
#define CYDEV_CHIP_DIE_EXPECT CYDEV_CHIP_MEMBER_USED
#define CYDEV_CHIP_DIE_ACTUAL CYDEV_CHIP_DIE_EXPECT
#define CYDEV_CHIP_REV_LEOPARD_ES1 0u
#define CYDEV_CHIP_REV_LEOPARD_ES2 1u
#define CYDEV_CHIP_REV_LEOPARD_ES3 3u
#define CYDEV_CHIP_REV_LEOPARD_PRODUCTION 3u
#define CYDEV_CHIP_REV_PSOC4A_ES0 17u
#define CYDEV_CHIP_REV_PSOC4A_PRODUCTION 17u
#define CYDEV_CHIP_REV_PSOC5LP_ES0 0u
#define CYDEV_CHIP_REV_PSOC5LP_PRODUCTION 0u
#define CYDEV_CHIP_REV_PSOC5TM_ES0 0u
#define CYDEV_CHIP_REV_PSOC5TM_ES1 1u
#define CYDEV_CHIP_REV_PSOC5TM_PRODUCTION 1u
#define CYDEV_CHIP_REV_TMA4_ES 17u
#define CYDEV_CHIP_REV_TMA4_ES2 33u
#define CYDEV_CHIP_REV_TMA4_PRODUCTION 17u
#define CYDEV_CHIP_REVISION_3A_ES1 0u
#define CYDEV_CHIP_REVISION_3A_ES2 1u
#define CYDEV_CHIP_REVISION_3A_ES3 3u
#define CYDEV_CHIP_REVISION_3A_PRODUCTION 3u
#define CYDEV_CHIP_REVISION_4A_ES0 17u
#define CYDEV_CHIP_REVISION_4A_PRODUCTION 17u
#define CYDEV_CHIP_REVISION_4C_PRODUCTION 0u
#define CYDEV_CHIP_REVISION_4D_PRODUCTION 0u
#define CYDEV_CHIP_REVISION_4E_PRODUCTION 0u
#define CYDEV_CHIP_REVISION_4F_PRODUCTION 0u
#define CYDEV_CHIP_REVISION_4F_PRODUCTION_256DMA 0u
#define CYDEV_CHIP_REVISION_4F_PRODUCTION_256K 0u
#define CYDEV_CHIP_REVISION_4G_ES 17u
#define CYDEV_CHIP_REVISION_4G_ES2 33u
#define CYDEV_CHIP_REVISION_4G_PRODUCTION 17u
#define CYDEV_CHIP_REVISION_4H_PRODUCTION 0u
#define CYDEV_CHIP_REVISION_4I_PRODUCTION 0u
#define CYDEV_CHIP_REVISION_4J_PRODUCTION 0u
#define CYDEV_CHIP_REVISION_4K_PRODUCTION 0u
#define CYDEV_CHIP_REVISION_4L_PRODUCTION 0u
#define CYDEV_CHIP_REVISION_4M_PRODUCTION 0u
#define CYDEV_CHIP_REVISION_4N_PRODUCTION 0u
#define CYDEV_CHIP_REVISION_4O_PRODUCTION 0u
#define CYDEV_CHIP_REVISION_4P_PRODUCTION 0u
#define CYDEV_CHIP_REVISION_4Q_PRODUCTION 0u
#define CYDEV_CHIP_REVISION_4U_PRODUCTION 0u
#define CYDEV_CHIP_REVISION_5A_ES0 0u
#define CYDEV_CHIP_REVISION_5A_ES1 1u
#define CYDEV_CHIP_REVISION_5A_PRODUCTION 1u
#define CYDEV_CHIP_REVISION_5B_ES0 0u
#define CYDEV_CHIP_REVISION_5B_PRODUCTION 0u
#define CYDEV_CHIP_REVISION_FM3_PRODUCTION 0u
#define CYDEV_CHIP_REVISION_FM4_PRODUCTION 0u
#define CYDEV_CHIP_REVISION_PDL_FM0P_TYPE1_PRODUCTION 0u
#define CYDEV_CHIP_REVISION_PDL_FM0P_TYPE2_PRODUCTION 0u
#define CYDEV_CHIP_REVISION_PDL_FM0P_TYPE3_PRODUCTION 0u
#define CYDEV_CHIP_REVISION_USED CYDEV_CHIP_REVISION_5B_PRODUCTION
#define CYDEV_CHIP_REV_EXPECT CYDEV_CHIP_REVISION_USED
#define CYDEV_CONFIG_FASTBOOT_ENABLED 1
#define CYDEV_CONFIG_UNUSED_IO_AllowButWarn 0
#define CYDEV_CONFIG_UNUSED_IO CYDEV_CONFIG_UNUSED_IO_AllowButWarn
#define CYDEV_CONFIG_UNUSED_IO_AllowWithInfo 1
#define CYDEV_CONFIG_UNUSED_IO_Disallowed 2
#define CYDEV_CONFIGURATION_COMPRESSED 1
#define CYDEV_CONFIGURATION_DMA 0
#define CYDEV_CONFIGURATION_ECC 1
#define CYDEV_CONFIGURATION_IMOENABLED CYDEV_CONFIG_FASTBOOT_ENABLED
#define CYDEV_CONFIGURATION_MODE_COMPRESSED 0
#define CYDEV_CONFIGURATION_MODE CYDEV_CONFIGURATION_MODE_COMPRESSED
#define CYDEV_CONFIGURATION_MODE_DMA 2
#define CYDEV_CONFIGURATION_MODE_UNCOMPRESSED 1
#define CYDEV_DEBUG_ENABLE_MASK 0x20u
#define CYDEV_DEBUG_ENABLE_REGISTER CYREG_MLOGIC_DEBUG
#define CYDEV_DEBUGGING_DPS_SWD 2
#define CYDEV_DEBUGGING_DPS_SWD_SWV 6
#define CYDEV_DEBUGGING_DPS CYDEV_DEBUGGING_DPS_SWD_SWV
#define CYDEV_DEBUGGING_ENABLE 1
#define CYDEV_DEBUGGING_XRES 0
#define CYDEV_DMA_CHANNELS_AVAILABLE 24u
#define CYDEV_ECC_ENABLE 0
#define CYDEV_HEAP_SIZE 0x80
#define CYDEV_INSTRUCT_CACHE_ENABLED 0
#define CYDEV_INTR_RISING 0x00000001u
#define CYDEV_IS_EXPORTING_CODE 0
#define CYDEV_IS_IMPORTING_CODE 0
#define CYDEV_PROJ_TYPE 2
#define CYDEV_PROJ_TYPE_BOOTLOADER 1
#define CYDEV_PROJ_TYPE_LAUNCHER 5
#define CYDEV_PROJ_TYPE_LOADABLE 2
#define CYDEV_PROJ_TYPE_LOADABLEANDBOOTLOADER 4
#define CYDEV_PROJ_TYPE_MULTIAPPBOOTLOADER 3
#define CYDEV_PROJ_TYPE_STANDARD 0
#define CYDEV_PROTECTION_ENABLE 0
#define CYDEV_STACK_SIZE 0x0800
#define CYDEV_USE_BUNDLED_CMSIS 1
#define CYDEV_VARIABLE_VDDA 0
#define CYDEV_VDDA 5.0
#define CYDEV_VDDA_MV 5000
#define CYDEV_VDDD 5.0
#define CYDEV_VDDD_MV 5000
#define CYDEV_VDDIO0 5.0
#define CYDEV_VDDIO0_MV 5000
#define CYDEV_VDDIO1 5.0
#define CYDEV_VDDIO1_MV 5000
#define CYDEV_VDDIO2 5.0
#define CYDEV_VDDIO2_MV 5000
#define CYDEV_VDDIO3 5.0
#define CYDEV_VDDIO3_MV 5000
#define CYDEV_VIO0 5.0
#define CYDEV_VIO0_MV 5000
#define CYDEV_VIO1 5.0
#define CYDEV_VIO1_MV 5000
#define CYDEV_VIO2 5.0
#define CYDEV_VIO2_MV 5000
#define CYDEV_VIO3 5.0
#define CYDEV_VIO3_MV 5000
#define CYIPBLOCK_ARM_CM3_VERSION 0
#define CYIPBLOCK_P3_ANAIF_VERSION 0
#define CYIPBLOCK_P3_CAN_VERSION 0
#define CYIPBLOCK_P3_CAPSENSE_VERSION 0
#define CYIPBLOCK_P3_COMP_VERSION 0
#define CYIPBLOCK_P3_DECIMATOR_VERSION 0
#define CYIPBLOCK_P3_DFB_VERSION 0
#define CYIPBLOCK_P3_DMA_VERSION 0
#define CYIPBLOCK_P3_DRQ_VERSION 0
#define CYIPBLOCK_P3_DSM_VERSION 0
#define CYIPBLOCK_P3_EMIF_VERSION 0
#define CYIPBLOCK_P3_I2C_VERSION 0
#define CYIPBLOCK_P3_LCD_VERSION 0
#define CYIPBLOCK_P3_LPF_VERSION 0
#define CYIPBLOCK_P3_OPAMP_VERSION 0
#define CYIPBLOCK_P3_PM_VERSION 0
#define CYIPBLOCK_P3_SCCT_VERSION 0
#define CYIPBLOCK_P3_TIMER_VERSION 0
#define CYIPBLOCK_P3_USB_VERSION 0
#define CYIPBLOCK_P3_VIDAC_VERSION 0
#define CYIPBLOCK_P3_VREF_VERSION 0
#define CYIPBLOCK_S8_GPIO_VERSION 0
#define CYIPBLOCK_S8_IRQ_VERSION 0
#define CYIPBLOCK_S8_SAR_VERSION 0
#define CYIPBLOCK_S8_SIO_VERSION 0
#define CYIPBLOCK_S8_UDB_VERSION 0
#define DMA_CHANNELS_USED__MASK0 0x00000001u
#define CYDEV_BOOTLOADER_ENABLE 0

#endif /* INCLUDED_CYFITTER_H */
