UNCAMotorsports/UNCAMotorsports-2017/AMS_psoc/AMS.cydsn/codegentemp/cyfitter.h

#ifndef INCLUDED_CYFITTER_H
#define INCLUDED_CYFITTER_H
#include "cydevice.h"
#include "cydevice_trm.h"

/* CAN_CanIP */
#define CAN_CanIP__CSR_BUF_SR CYREG_CAN0_CSR_BUF_SR
#define CAN_CanIP__CSR_CFG CYREG_CAN0_CSR_CFG
#define CAN_CanIP__CSR_CMD CYREG_CAN0_CSR_CMD
#define CAN_CanIP__CSR_ERR_SR CYREG_CAN0_CSR_ERR_SR
#define CAN_CanIP__CSR_INT_EN CYREG_CAN0_CSR_INT_EN
#define CAN_CanIP__CSR_INT_SR CYREG_CAN0_CSR_INT_SR
#define CAN_CanIP__PM_ACT_CFG CYREG_PM_ACT_CFG6
#define CAN_CanIP__PM_ACT_MSK 0x01u
#define CAN_CanIP__PM_STBY_CFG CYREG_PM_STBY_CFG6
#define CAN_CanIP__PM_STBY_MSK 0x01u
#define CAN_CanIP__RX0_ACR CYREG_CAN0_RX0_ACR
#define CAN_CanIP__RX0_ACRD CYREG_CAN0_RX0_ACRD
#define CAN_CanIP__RX0_AMR CYREG_CAN0_RX0_AMR
#define CAN_CanIP__RX0_AMRD CYREG_CAN0_RX0_AMRD
#define CAN_CanIP__RX0_CMD CYREG_CAN0_RX0_CMD
#define CAN_CanIP__RX0_DH CYREG_CAN0_RX0_DH
#define CAN_CanIP__RX0_DL CYREG_CAN0_RX0_DL
#define CAN_CanIP__RX0_ID CYREG_CAN0_RX0_ID
#define CAN_CanIP__RX1_ACR CYREG_CAN0_RX1_ACR
#define CAN_CanIP__RX1_ACRD CYREG_CAN0_RX1_ACRD
#define CAN_CanIP__RX1_AMR CYREG_CAN0_RX1_AMR
#define CAN_CanIP__RX1_AMRD CYREG_CAN0_RX1_AMRD
#define CAN_CanIP__RX1_CMD CYREG_CAN0_RX1_CMD
#define CAN_CanIP__RX1_DH CYREG_CAN0_RX1_DH
#define CAN_CanIP__RX1_DL CYREG_CAN0_RX1_DL
#define CAN_CanIP__RX1_ID CYREG_CAN0_RX1_ID
#define CAN_CanIP__RX10_ACR CYREG_CAN0_RX10_ACR
#define CAN_CanIP__RX10_ACRD CYREG_CAN0_RX10_ACRD
#define CAN_CanIP__RX10_AMR CYREG_CAN0_RX10_AMR
#define CAN_CanIP__RX10_AMRD CYREG_CAN0_RX10_AMRD
#define CAN_CanIP__RX10_CMD CYREG_CAN0_RX10_CMD
#define CAN_CanIP__RX10_DH CYREG_CAN0_RX10_DH
#define CAN_CanIP__RX10_DL CYREG_CAN0_RX10_DL
#define CAN_CanIP__RX10_ID CYREG_CAN0_RX10_ID
#define CAN_CanIP__RX11_ACR CYREG_CAN0_RX11_ACR
#define CAN_CanIP__RX11_ACRD CYREG_CAN0_RX11_ACRD
#define CAN_CanIP__RX11_AMR CYREG_CAN0_RX11_AMR
#define CAN_CanIP__RX11_AMRD CYREG_CAN0_RX11_AMRD
#define CAN_CanIP__RX11_CMD CYREG_CAN0_RX11_CMD
#define CAN_CanIP__RX11_DH CYREG_CAN0_RX11_DH
#define CAN_CanIP__RX11_DL CYREG_CAN0_RX11_DL
#define CAN_CanIP__RX11_ID CYREG_CAN0_RX11_ID
#define CAN_CanIP__RX12_ACR CYREG_CAN0_RX12_ACR
#define CAN_CanIP__RX12_ACRD CYREG_CAN0_RX12_ACRD
#define CAN_CanIP__RX12_AMR CYREG_CAN0_RX12_AMR
#define CAN_CanIP__RX12_AMRD CYREG_CAN0_RX12_AMRD
#define CAN_CanIP__RX12_CMD CYREG_CAN0_RX12_CMD
#define CAN_CanIP__RX12_DH CYREG_CAN0_RX12_DH
#define CAN_CanIP__RX12_DL CYREG_CAN0_RX12_DL
#define CAN_CanIP__RX12_ID CYREG_CAN0_RX12_ID
#define CAN_CanIP__RX13_ACR CYREG_CAN0_RX13_ACR
#define CAN_CanIP__RX13_ACRD CYREG_CAN0_RX13_ACRD
#define CAN_CanIP__RX13_AMR CYREG_CAN0_RX13_AMR
#define CAN_CanIP__RX13_AMRD CYREG_CAN0_RX13_AMRD
#define CAN_CanIP__RX13_CMD CYREG_CAN0_RX13_CMD
#define CAN_CanIP__RX13_DH CYREG_CAN0_RX13_DH
#define CAN_CanIP__RX13_DL CYREG_CAN0_RX13_DL
#define CAN_CanIP__RX13_ID CYREG_CAN0_RX13_ID
#define CAN_CanIP__RX14_ACR CYREG_CAN0_RX14_ACR
#define CAN_CanIP__RX14_ACRD CYREG_CAN0_RX14_ACRD
#define CAN_CanIP__RX14_AMR CYREG_CAN0_RX14_AMR
#define CAN_CanIP__RX14_AMRD CYREG_CAN0_RX14_AMRD
#define CAN_CanIP__RX14_CMD CYREG_CAN0_RX14_CMD
#define CAN_CanIP__RX14_DH CYREG_CAN0_RX14_DH
#define CAN_CanIP__RX14_DL CYREG_CAN0_RX14_DL
#define CAN_CanIP__RX14_ID CYREG_CAN0_RX14_ID
#define CAN_CanIP__RX15_ACR CYREG_CAN0_RX15_ACR
#define CAN_CanIP__RX15_ACRD CYREG_CAN0_RX15_ACRD
#define CAN_CanIP__RX15_AMR CYREG_CAN0_RX15_AMR
#define CAN_CanIP__RX15_AMRD CYREG_CAN0_RX15_AMRD
#define CAN_CanIP__RX15_CMD CYREG_CAN0_RX15_CMD
#define CAN_CanIP__RX15_DH CYREG_CAN0_RX15_DH
#define CAN_CanIP__RX15_DL CYREG_CAN0_RX15_DL
#define CAN_CanIP__RX15_ID CYREG_CAN0_RX15_ID
#define CAN_CanIP__RX2_ACR CYREG_CAN0_RX2_ACR
#define CAN_CanIP__RX2_ACRD CYREG_CAN0_RX2_ACRD
#define CAN_CanIP__RX2_AMR CYREG_CAN0_RX2_AMR
#define CAN_CanIP__RX2_AMRD CYREG_CAN0_RX2_AMRD
#define CAN_CanIP__RX2_CMD CYREG_CAN0_RX2_CMD
#define CAN_CanIP__RX2_DH CYREG_CAN0_RX2_DH
#define CAN_CanIP__RX2_DL CYREG_CAN0_RX2_DL
#define CAN_CanIP__RX2_ID CYREG_CAN0_RX2_ID
#define CAN_CanIP__RX3_ACR CYREG_CAN0_RX3_ACR
#define CAN_CanIP__RX3_ACRD CYREG_CAN0_RX3_ACRD
#define CAN_CanIP__RX3_AMR CYREG_CAN0_RX3_AMR
#define CAN_CanIP__RX3_AMRD CYREG_CAN0_RX3_AMRD
#define CAN_CanIP__RX3_CMD CYREG_CAN0_RX3_CMD
#define CAN_CanIP__RX3_DH CYREG_CAN0_RX3_DH
#define CAN_CanIP__RX3_DL CYREG_CAN0_RX3_DL
#define CAN_CanIP__RX3_ID CYREG_CAN0_RX3_ID
#define CAN_CanIP__RX4_ACR CYREG_CAN0_RX4_ACR
#define CAN_CanIP__RX4_ACRD CYREG_CAN0_RX4_ACRD
#define CAN_CanIP__RX4_AMR CYREG_CAN0_RX4_AMR
#define CAN_CanIP__RX4_AMRD CYREG_CAN0_RX4_AMRD
#define CAN_CanIP__RX4_CMD CYREG_CAN0_RX4_CMD
#define CAN_CanIP__RX4_DH CYREG_CAN0_RX4_DH
#define CAN_CanIP__RX4_DL CYREG_CAN0_RX4_DL
#define CAN_CanIP__RX4_ID CYREG_CAN0_RX4_ID
#define CAN_CanIP__RX5_ACR CYREG_CAN0_RX5_ACR
#define CAN_CanIP__RX5_ACRD CYREG_CAN0_RX5_ACRD
#define CAN_CanIP__RX5_AMR CYREG_CAN0_RX5_AMR
#define CAN_CanIP__RX5_AMRD CYREG_CAN0_RX5_AMRD
#define CAN_CanIP__RX5_CMD CYREG_CAN0_RX5_CMD
#define CAN_CanIP__RX5_DH CYREG_CAN0_RX5_DH
#define CAN_CanIP__RX5_DL CYREG_CAN0_RX5_DL
#define CAN_CanIP__RX5_ID CYREG_CAN0_RX5_ID
#define CAN_CanIP__RX6_ACR CYREG_CAN0_RX6_ACR
#define CAN_CanIP__RX6_ACRD CYREG_CAN0_RX6_ACRD
#define CAN_CanIP__RX6_AMR CYREG_CAN0_RX6_AMR
#define CAN_CanIP__RX6_AMRD CYREG_CAN0_RX6_AMRD
#define CAN_CanIP__RX6_CMD CYREG_CAN0_RX6_CMD
#define CAN_CanIP__RX6_DH CYREG_CAN0_RX6_DH
#define CAN_CanIP__RX6_DL CYREG_CAN0_RX6_DL
#define CAN_CanIP__RX6_ID CYREG_CAN0_RX6_ID
#define CAN_CanIP__RX7_ACR CYREG_CAN0_RX7_ACR
#define CAN_CanIP__RX7_ACRD CYREG_CAN0_RX7_ACRD
#define CAN_CanIP__RX7_AMR CYREG_CAN0_RX7_AMR
#define CAN_CanIP__RX7_AMRD CYREG_CAN0_RX7_AMRD
#define CAN_CanIP__RX7_CMD CYREG_CAN0_RX7_CMD
#define CAN_CanIP__RX7_DH CYREG_CAN0_RX7_DH
#define CAN_CanIP__RX7_DL CYREG_CAN0_RX7_DL
#define CAN_CanIP__RX7_ID CYREG_CAN0_RX7_ID
#define CAN_CanIP__RX8_ACR CYREG_CAN0_RX8_ACR
#define CAN_CanIP__RX8_ACRD CYREG_CAN0_RX8_ACRD
#define CAN_CanIP__RX8_AMR CYREG_CAN0_RX8_AMR
#define CAN_CanIP__RX8_AMRD CYREG_CAN0_RX8_AMRD
#define CAN_CanIP__RX8_CMD CYREG_CAN0_RX8_CMD
#define CAN_CanIP__RX8_DH CYREG_CAN0_RX8_DH
#define CAN_CanIP__RX8_DL CYREG_CAN0_RX8_DL
#define CAN_CanIP__RX8_ID CYREG_CAN0_RX8_ID
#define CAN_CanIP__RX9_ACR CYREG_CAN0_RX9_ACR
#define CAN_CanIP__RX9_ACRD CYREG_CAN0_RX9_ACRD
#define CAN_CanIP__RX9_AMR CYREG_CAN0_RX9_AMR
#define CAN_CanIP__RX9_AMRD CYREG_CAN0_RX9_AMRD
#define CAN_CanIP__RX9_CMD CYREG_CAN0_RX9_CMD
#define CAN_CanIP__RX9_DH CYREG_CAN0_RX9_DH
#define CAN_CanIP__RX9_DL CYREG_CAN0_RX9_DL
#define CAN_CanIP__RX9_ID CYREG_CAN0_RX9_ID
#define CAN_CanIP__TX0_CMD CYREG_CAN0_TX0_CMD
#define CAN_CanIP__TX0_DH CYREG_CAN0_TX0_DH
#define CAN_CanIP__TX0_DL CYREG_CAN0_TX0_DL
#define CAN_CanIP__TX0_ID CYREG_CAN0_TX0_ID
#define CAN_CanIP__TX1_CMD CYREG_CAN0_TX1_CMD
#define CAN_CanIP__TX1_DH CYREG_CAN0_TX1_DH
#define CAN_CanIP__TX1_DL CYREG_CAN0_TX1_DL
#define CAN_CanIP__TX1_ID CYREG_CAN0_TX1_ID
#define CAN_CanIP__TX2_CMD CYREG_CAN0_TX2_CMD
#define CAN_CanIP__TX2_DH CYREG_CAN0_TX2_DH
#define CAN_CanIP__TX2_DL CYREG_CAN0_TX2_DL
#define CAN_CanIP__TX2_ID CYREG_CAN0_TX2_ID
#define CAN_CanIP__TX3_CMD CYREG_CAN0_TX3_CMD
#define CAN_CanIP__TX3_DH CYREG_CAN0_TX3_DH
#define CAN_CanIP__TX3_DL CYREG_CAN0_TX3_DL
#define CAN_CanIP__TX3_ID CYREG_CAN0_TX3_ID
#define CAN_CanIP__TX4_CMD CYREG_CAN0_TX4_CMD
#define CAN_CanIP__TX4_DH CYREG_CAN0_TX4_DH
#define CAN_CanIP__TX4_DL CYREG_CAN0_TX4_DL
#define CAN_CanIP__TX4_ID CYREG_CAN0_TX4_ID
#define CAN_CanIP__TX5_CMD CYREG_CAN0_TX5_CMD
#define CAN_CanIP__TX5_DH CYREG_CAN0_TX5_DH
#define CAN_CanIP__TX5_DL CYREG_CAN0_TX5_DL
#define CAN_CanIP__TX5_ID CYREG_CAN0_TX5_ID
#define CAN_CanIP__TX6_CMD CYREG_CAN0_TX6_CMD
#define CAN_CanIP__TX6_DH CYREG_CAN0_TX6_DH
#define CAN_CanIP__TX6_DL CYREG_CAN0_TX6_DL
#define CAN_CanIP__TX6_ID CYREG_CAN0_TX6_ID
#define CAN_CanIP__TX7_CMD CYREG_CAN0_TX7_CMD
#define CAN_CanIP__TX7_DH CYREG_CAN0_TX7_DH
#define CAN_CanIP__TX7_DL CYREG_CAN0_TX7_DL
#define CAN_CanIP__TX7_ID CYREG_CAN0_TX7_ID

/* CAN_isr */
#define CAN_isr__INTC_CLR_EN_REG CYREG_NVIC_CLRENA0
#define CAN_isr__INTC_CLR_PD_REG CYREG_NVIC_CLRPEND0
#define CAN_isr__INTC_MASK 0x10000u
#define CAN_isr__INTC_NUMBER 16u
#define CAN_isr__INTC_PRIOR_NUM 7u
#define CAN_isr__INTC_PRIOR_REG CYREG_NVIC_PRI_16
#define CAN_isr__INTC_SET_EN_REG CYREG_NVIC_SETENA0
#define CAN_isr__INTC_SET_PD_REG CYREG_NVIC_SETPEND0

/* LED */
#define LED__0__INTTYPE CYREG_PICU2_INTTYPE1
#define LED__0__MASK 0x02u
#define LED__0__PC CYREG_PRT2_PC1
#define LED__0__PORT 2u
#define LED__0__SHIFT 1u
#define LED__AG CYREG_PRT2_AG
#define LED__AMUX CYREG_PRT2_AMUX
#define LED__BIE CYREG_PRT2_BIE
#define LED__BIT_MASK CYREG_PRT2_BIT_MASK
#define LED__BYP CYREG_PRT2_BYP
#define LED__CTL CYREG_PRT2_CTL
#define LED__DM0 CYREG_PRT2_DM0
#define LED__DM1 CYREG_PRT2_DM1
#define LED__DM2 CYREG_PRT2_DM2
#define LED__DR CYREG_PRT2_DR
#define LED__INP_DIS CYREG_PRT2_INP_DIS
#define LED__INTTYPE_BASE CYDEV_PICU_INTTYPE_PICU2_BASE
#define LED__LCD_COM_SEG CYREG_PRT2_LCD_COM_SEG
#define LED__LCD_EN CYREG_PRT2_LCD_EN
#define LED__MASK 0x02u
#define LED__PORT 2u
#define LED__PRT CYREG_PRT2_PRT
#define LED__PRTDSI__CAPS_SEL CYREG_PRT2_CAPS_SEL
#define LED__PRTDSI__DBL_SYNC_IN CYREG_PRT2_DBL_SYNC_IN
#define LED__PRTDSI__OE_SEL0 CYREG_PRT2_OE_SEL0
#define LED__PRTDSI__OE_SEL1 CYREG_PRT2_OE_SEL1
#define LED__PRTDSI__OUT_SEL0 CYREG_PRT2_OUT_SEL0
#define LED__PRTDSI__OUT_SEL1 CYREG_PRT2_OUT_SEL1
#define LED__PRTDSI__SYNC_OUT CYREG_PRT2_SYNC_OUT
#define LED__PS CYREG_PRT2_PS
#define LED__SHIFT 1u
#define LED__SLW CYREG_PRT2_SLW

/* RX_1 */
#define RX_1__0__INTTYPE CYREG_PICU12_INTTYPE2
#define RX_1__0__MASK 0x04u
#define RX_1__0__PC CYREG_PRT12_PC2
#define RX_1__0__PORT 12u
#define RX_1__0__SHIFT 2u
#define RX_1__AG CYREG_PRT12_AG
#define RX_1__BIE CYREG_PRT12_BIE
#define RX_1__BIT_MASK CYREG_PRT12_BIT_MASK
#define RX_1__BYP CYREG_PRT12_BYP
#define RX_1__DM0 CYREG_PRT12_DM0
#define RX_1__DM1 CYREG_PRT12_DM1
#define RX_1__DM2 CYREG_PRT12_DM2
#define RX_1__DR CYREG_PRT12_DR
#define RX_1__INP_DIS CYREG_PRT12_INP_DIS
#define RX_1__INTTYPE_BASE CYDEV_PICU_INTTYPE_PICU12_BASE
#define RX_1__MASK 0x04u
#define RX_1__PORT 12u
#define RX_1__PRT CYREG_PRT12_PRT
#define RX_1__PRTDSI__DBL_SYNC_IN CYREG_PRT12_DBL_SYNC_IN
#define RX_1__PRTDSI__OE_SEL0 CYREG_PRT12_OE_SEL0
#define RX_1__PRTDSI__OE_SEL1 CYREG_PRT12_OE_SEL1
#define RX_1__PRTDSI__OUT_SEL0 CYREG_PRT12_OUT_SEL0
#define RX_1__PRTDSI__OUT_SEL1 CYREG_PRT12_OUT_SEL1
#define RX_1__PRTDSI__SYNC_OUT CYREG_PRT12_SYNC_OUT
#define RX_1__PS CYREG_PRT12_PS
#define RX_1__SHIFT 2u
#define RX_1__SIO_CFG CYREG_PRT12_SIO_CFG
#define RX_1__SIO_DIFF CYREG_PRT12_SIO_DIFF
#define RX_1__SIO_HYST_EN CYREG_PRT12_SIO_HYST_EN
#define RX_1__SIO_REG_HIFREQ CYREG_PRT12_SIO_REG_HIFREQ
#define RX_1__SLW CYREG_PRT12_SLW

/* TX_1 */
#define TX_1__0__INTTYPE CYREG_PICU12_INTTYPE3
#define TX_1__0__MASK 0x08u
#define TX_1__0__PC CYREG_PRT12_PC3
#define TX_1__0__PORT 12u
#define TX_1__0__SHIFT 3u
#define TX_1__AG CYREG_PRT12_AG
#define TX_1__BIE CYREG_PRT12_BIE
#define TX_1__BIT_MASK CYREG_PRT12_BIT_MASK
#define TX_1__BYP CYREG_PRT12_BYP
#define TX_1__DM0 CYREG_PRT12_DM0
#define TX_1__DM1 CYREG_PRT12_DM1
#define TX_1__DM2 CYREG_PRT12_DM2
#define TX_1__DR CYREG_PRT12_DR
#define TX_1__INP_DIS CYREG_PRT12_INP_DIS
#define TX_1__INTTYPE_BASE CYDEV_PICU_INTTYPE_PICU12_BASE
#define TX_1__MASK 0x08u
#define TX_1__PORT 12u
#define TX_1__PRT CYREG_PRT12_PRT
#define TX_1__PRTDSI__DBL_SYNC_IN CYREG_PRT12_DBL_SYNC_IN
#define TX_1__PRTDSI__OE_SEL0 CYREG_PRT12_OE_SEL0
#define TX_1__PRTDSI__OE_SEL1 CYREG_PRT12_OE_SEL1
#define TX_1__PRTDSI__OUT_SEL0 CYREG_PRT12_OUT_SEL0
#define TX_1__PRTDSI__OUT_SEL1 CYREG_PRT12_OUT_SEL1
#define TX_1__PRTDSI__SYNC_OUT CYREG_PRT12_SYNC_OUT
#define TX_1__PS CYREG_PRT12_PS
#define TX_1__SHIFT 3u
#define TX_1__SIO_CFG CYREG_PRT12_SIO_CFG
#define TX_1__SIO_DIFF CYREG_PRT12_SIO_DIFF
#define TX_1__SIO_HYST_EN CYREG_PRT12_SIO_HYST_EN
#define TX_1__SIO_REG_HIFREQ CYREG_PRT12_SIO_REG_HIFREQ
#define TX_1__SLW CYREG_PRT12_SLW

/* USBUART_arb_int */
#define USBUART_arb_int__INTC_CLR_EN_REG CYREG_NVIC_CLRENA0
#define USBUART_arb_int__INTC_CLR_PD_REG CYREG_NVIC_CLRPEND0
#define USBUART_arb_int__INTC_MASK 0x400000u
#define USBUART_arb_int__INTC_NUMBER 22u
#define USBUART_arb_int__INTC_PRIOR_NUM 7u
#define USBUART_arb_int__INTC_PRIOR_REG CYREG_NVIC_PRI_22
#define USBUART_arb_int__INTC_SET_EN_REG CYREG_NVIC_SETENA0
#define USBUART_arb_int__INTC_SET_PD_REG CYREG_NVIC_SETPEND0

/* USBUART_bus_reset */
#define USBUART_bus_reset__INTC_CLR_EN_REG CYREG_NVIC_CLRENA0
#define USBUART_bus_reset__INTC_CLR_PD_REG CYREG_NVIC_CLRPEND0
#define USBUART_bus_reset__INTC_MASK 0x800000u
#define USBUART_bus_reset__INTC_NUMBER 23u
#define USBUART_bus_reset__INTC_PRIOR_NUM 7u
#define USBUART_bus_reset__INTC_PRIOR_REG CYREG_NVIC_PRI_23
#define USBUART_bus_reset__INTC_SET_EN_REG CYREG_NVIC_SETENA0
#define USBUART_bus_reset__INTC_SET_PD_REG CYREG_NVIC_SETPEND0

/* USBUART_Dm */
#define USBUART_Dm__0__INTTYPE CYREG_PICU15_INTTYPE7
#define USBUART_Dm__0__MASK 0x80u
#define USBUART_Dm__0__PC CYREG_IO_PC_PRT15_7_6_PC1
#define USBUART_Dm__0__PORT 15u
#define USBUART_Dm__0__SHIFT 7u
#define USBUART_Dm__AG CYREG_PRT15_AG
#define USBUART_Dm__AMUX CYREG_PRT15_AMUX
#define USBUART_Dm__BIE CYREG_PRT15_BIE
#define USBUART_Dm__BIT_MASK CYREG_PRT15_BIT_MASK
#define USBUART_Dm__BYP CYREG_PRT15_BYP
#define USBUART_Dm__CTL CYREG_PRT15_CTL
#define USBUART_Dm__DM0 CYREG_PRT15_DM0
#define USBUART_Dm__DM1 CYREG_PRT15_DM1
#define USBUART_Dm__DM2 CYREG_PRT15_DM2
#define USBUART_Dm__DR CYREG_PRT15_DR
#define USBUART_Dm__INP_DIS CYREG_PRT15_INP_DIS
#define USBUART_Dm__INTTYPE_BASE CYDEV_PICU_INTTYPE_PICU15_BASE
#define USBUART_Dm__LCD_COM_SEG CYREG_PRT15_LCD_COM_SEG
#define USBUART_Dm__LCD_EN CYREG_PRT15_LCD_EN
#define USBUART_Dm__MASK 0x80u
#define USBUART_Dm__PORT 15u
#define USBUART_Dm__PRT CYREG_PRT15_PRT
#define USBUART_Dm__PRTDSI__CAPS_SEL CYREG_PRT15_CAPS_SEL
#define USBUART_Dm__PRTDSI__DBL_SYNC_IN CYREG_PRT15_DBL_SYNC_IN
#define USBUART_Dm__PRTDSI__OE_SEL0 CYREG_PRT15_OE_SEL0
#define USBUART_Dm__PRTDSI__OE_SEL1 CYREG_PRT15_OE_SEL1
#define USBUART_Dm__PRTDSI__OUT_SEL0 CYREG_PRT15_OUT_SEL0
#define USBUART_Dm__PRTDSI__OUT_SEL1 CYREG_PRT15_OUT_SEL1
#define USBUART_Dm__PRTDSI__SYNC_OUT CYREG_PRT15_SYNC_OUT
#define USBUART_Dm__PS CYREG_PRT15_PS
#define USBUART_Dm__SHIFT 7u
#define USBUART_Dm__SLW CYREG_PRT15_SLW

/* USBUART_Dp */
#define USBUART_Dp__0__INTTYPE CYREG_PICU15_INTTYPE6
#define USBUART_Dp__0__MASK 0x40u
#define USBUART_Dp__0__PC CYREG_IO_PC_PRT15_7_6_PC0
#define USBUART_Dp__0__PORT 15u
#define USBUART_Dp__0__SHIFT 6u
#define USBUART_Dp__AG CYREG_PRT15_AG
#define USBUART_Dp__AMUX CYREG_PRT15_AMUX
#define USBUART_Dp__BIE CYREG_PRT15_BIE
#define USBUART_Dp__BIT_MASK CYREG_PRT15_BIT_MASK
#define USBUART_Dp__BYP CYREG_PRT15_BYP
#define USBUART_Dp__CTL CYREG_PRT15_CTL
#define USBUART_Dp__DM0 CYREG_PRT15_DM0
#define USBUART_Dp__DM1 CYREG_PRT15_DM1
#define USBUART_Dp__DM2 CYREG_PRT15_DM2
#define USBUART_Dp__DR CYREG_PRT15_DR
#define USBUART_Dp__INP_DIS CYREG_PRT15_INP_DIS
#define USBUART_Dp__INTSTAT CYREG_PICU15_INTSTAT
#define USBUART_Dp__INTTYPE_BASE CYDEV_PICU_INTTYPE_PICU15_BASE
#define USBUART_Dp__LCD_COM_SEG CYREG_PRT15_LCD_COM_SEG
#define USBUART_Dp__LCD_EN CYREG_PRT15_LCD_EN
#define USBUART_Dp__MASK 0x40u
#define USBUART_Dp__PORT 15u
#define USBUART_Dp__PRT CYREG_PRT15_PRT
#define USBUART_Dp__PRTDSI__CAPS_SEL CYREG_PRT15_CAPS_SEL
#define USBUART_Dp__PRTDSI__DBL_SYNC_IN CYREG_PRT15_DBL_SYNC_IN
#define USBUART_Dp__PRTDSI__OE_SEL0 CYREG_PRT15_OE_SEL0
#define USBUART_Dp__PRTDSI__OE_SEL1 CYREG_PRT15_OE_SEL1
#define USBUART_Dp__PRTDSI__OUT_SEL0 CYREG_PRT15_OUT_SEL0
#define USBUART_Dp__PRTDSI__OUT_SEL1 CYREG_PRT15_OUT_SEL1
#define USBUART_Dp__PRTDSI__SYNC_OUT CYREG_PRT15_SYNC_OUT
#define USBUART_Dp__PS CYREG_PRT15_PS
#define USBUART_Dp__SHIFT 6u
#define USBUART_Dp__SLW CYREG_PRT15_SLW
#define USBUART_Dp__SNAP CYREG_PICU_15_SNAP_15

/* USBUART_dp_int */
#define USBUART_dp_int__INTC_CLR_EN_REG CYREG_NVIC_CLRENA0
#define USBUART_dp_int__INTC_CLR_PD_REG CYREG_NVIC_CLRPEND0
#define USBUART_dp_int__INTC_MASK 0x1000u
#define USBUART_dp_int__INTC_NUMBER 12u
#define USBUART_dp_int__INTC_PRIOR_NUM 7u
#define USBUART_dp_int__INTC_PRIOR_REG CYREG_NVIC_PRI_12
#define USBUART_dp_int__INTC_SET_EN_REG CYREG_NVIC_SETENA0
#define USBUART_dp_int__INTC_SET_PD_REG CYREG_NVIC_SETPEND0

/* USBUART_ep_0 */
#define USBUART_ep_0__INTC_CLR_EN_REG CYREG_NVIC_CLRENA0
#define USBUART_ep_0__INTC_CLR_PD_REG CYREG_NVIC_CLRPEND0
#define USBUART_ep_0__INTC_MASK 0x1000000u
#define USBUART_ep_0__INTC_NUMBER 24u
#define USBUART_ep_0__INTC_PRIOR_NUM 7u
#define USBUART_ep_0__INTC_PRIOR_REG CYREG_NVIC_PRI_24
#define USBUART_ep_0__INTC_SET_EN_REG CYREG_NVIC_SETENA0
#define USBUART_ep_0__INTC_SET_PD_REG CYREG_NVIC_SETPEND0

/* USBUART_ep_1 */
#define USBUART_ep_1__INTC_CLR_EN_REG CYREG_NVIC_CLRENA0
#define USBUART_ep_1__INTC_CLR_PD_REG CYREG_NVIC_CLRPEND0
#define USBUART_ep_1__INTC_MASK 0x01u
#define USBUART_ep_1__INTC_NUMBER 0u
#define USBUART_ep_1__INTC_PRIOR_NUM 7u
#define USBUART_ep_1__INTC_PRIOR_REG CYREG_NVIC_PRI_0
#define USBUART_ep_1__INTC_SET_EN_REG CYREG_NVIC_SETENA0
#define USBUART_ep_1__INTC_SET_PD_REG CYREG_NVIC_SETPEND0

/* USBUART_ep_2 */
#define USBUART_ep_2__INTC_CLR_EN_REG CYREG_NVIC_CLRENA0
#define USBUART_ep_2__INTC_CLR_PD_REG CYREG_NVIC_CLRPEND0
#define USBUART_ep_2__INTC_MASK 0x02u
#define USBUART_ep_2__INTC_NUMBER 1u
#define USBUART_ep_2__INTC_PRIOR_NUM 7u
#define USBUART_ep_2__INTC_PRIOR_REG CYREG_NVIC_PRI_1
#define USBUART_ep_2__INTC_SET_EN_REG CYREG_NVIC_SETENA0
#define USBUART_ep_2__INTC_SET_PD_REG CYREG_NVIC_SETPEND0

/* USBUART_ep_3 */
#define USBUART_ep_3__INTC_CLR_EN_REG CYREG_NVIC_CLRENA0
#define USBUART_ep_3__INTC_CLR_PD_REG CYREG_NVIC_CLRPEND0
#define USBUART_ep_3__INTC_MASK 0x04u
#define USBUART_ep_3__INTC_NUMBER 2u
#define USBUART_ep_3__INTC_PRIOR_NUM 7u
#define USBUART_ep_3__INTC_PRIOR_REG CYREG_NVIC_PRI_2
#define USBUART_ep_3__INTC_SET_EN_REG CYREG_NVIC_SETENA0
#define USBUART_ep_3__INTC_SET_PD_REG CYREG_NVIC_SETPEND0

/* USBUART_sof_int */
#define USBUART_sof_int__INTC_CLR_EN_REG CYREG_NVIC_CLRENA0
#define USBUART_sof_int__INTC_CLR_PD_REG CYREG_NVIC_CLRPEND0
#define USBUART_sof_int__INTC_MASK 0x200000u
#define USBUART_sof_int__INTC_NUMBER 21u
#define USBUART_sof_int__INTC_PRIOR_NUM 7u
#define USBUART_sof_int__INTC_PRIOR_REG CYREG_NVIC_PRI_21
#define USBUART_sof_int__INTC_SET_EN_REG CYREG_NVIC_SETENA0
#define USBUART_sof_int__INTC_SET_PD_REG CYREG_NVIC_SETPEND0

/* USBUART_USB */
#define USBUART_USB__ARB_CFG CYREG_USB_ARB_CFG
#define USBUART_USB__ARB_EP1_CFG CYREG_USB_ARB_EP1_CFG
#define USBUART_USB__ARB_EP1_INT_EN CYREG_USB_ARB_EP1_INT_EN
#define USBUART_USB__ARB_EP1_SR CYREG_USB_ARB_EP1_SR
#define USBUART_USB__ARB_EP2_CFG CYREG_USB_ARB_EP2_CFG
#define USBUART_USB__ARB_EP2_INT_EN CYREG_USB_ARB_EP2_INT_EN
#define USBUART_USB__ARB_EP2_SR CYREG_USB_ARB_EP2_SR
#define USBUART_USB__ARB_EP3_CFG CYREG_USB_ARB_EP3_CFG
#define USBUART_USB__ARB_EP3_INT_EN CYREG_USB_ARB_EP3_INT_EN
#define USBUART_USB__ARB_EP3_SR CYREG_USB_ARB_EP3_SR
#define USBUART_USB__ARB_EP4_CFG CYREG_USB_ARB_EP4_CFG
#define USBUART_USB__ARB_EP4_INT_EN CYREG_USB_ARB_EP4_INT_EN
#define USBUART_USB__ARB_EP4_SR CYREG_USB_ARB_EP4_SR
#define USBUART_USB__ARB_EP5_CFG CYREG_USB_ARB_EP5_CFG
#define USBUART_USB__ARB_EP5_INT_EN CYREG_USB_ARB_EP5_INT_EN
#define USBUART_USB__ARB_EP5_SR CYREG_USB_ARB_EP5_SR
#define USBUART_USB__ARB_EP6_CFG CYREG_USB_ARB_EP6_CFG
#define USBUART_USB__ARB_EP6_INT_EN CYREG_USB_ARB_EP6_INT_EN
#define USBUART_USB__ARB_EP6_SR CYREG_USB_ARB_EP6_SR
#define USBUART_USB__ARB_EP7_CFG CYREG_USB_ARB_EP7_CFG
#define USBUART_USB__ARB_EP7_INT_EN CYREG_USB_ARB_EP7_INT_EN
#define USBUART_USB__ARB_EP7_SR CYREG_USB_ARB_EP7_SR
#define USBUART_USB__ARB_EP8_CFG CYREG_USB_ARB_EP8_CFG
#define USBUART_USB__ARB_EP8_INT_EN CYREG_USB_ARB_EP8_INT_EN
#define USBUART_USB__ARB_EP8_SR CYREG_USB_ARB_EP8_SR
#define USBUART_USB__ARB_INT_EN CYREG_USB_ARB_INT_EN
#define USBUART_USB__ARB_INT_SR CYREG_USB_ARB_INT_SR
#define USBUART_USB__ARB_RW1_DR CYREG_USB_ARB_RW1_DR
#define USBUART_USB__ARB_RW1_RA CYREG_USB_ARB_RW1_RA
#define USBUART_USB__ARB_RW1_RA_MSB CYREG_USB_ARB_RW1_RA_MSB
#define USBUART_USB__ARB_RW1_WA CYREG_USB_ARB_RW1_WA
#define USBUART_USB__ARB_RW1_WA_MSB CYREG_USB_ARB_RW1_WA_MSB
#define USBUART_USB__ARB_RW2_DR CYREG_USB_ARB_RW2_DR
#define USBUART_USB__ARB_RW2_RA CYREG_USB_ARB_RW2_RA
#define USBUART_USB__ARB_RW2_RA_MSB CYREG_USB_ARB_RW2_RA_MSB
#define USBUART_USB__ARB_RW2_WA CYREG_USB_ARB_RW2_WA
#define USBUART_USB__ARB_RW2_WA_MSB CYREG_USB_ARB_RW2_WA_MSB
#define USBUART_USB__ARB_RW3_DR CYREG_USB_ARB_RW3_DR
#define USBUART_USB__ARB_RW3_RA CYREG_USB_ARB_RW3_RA
#define USBUART_USB__ARB_RW3_RA_MSB CYREG_USB_ARB_RW3_RA_MSB
#define USBUART_USB__ARB_RW3_WA CYREG_USB_ARB_RW3_WA
#define USBUART_USB__ARB_RW3_WA_MSB CYREG_USB_ARB_RW3_WA_MSB
#define USBUART_USB__ARB_RW4_DR CYREG_USB_ARB_RW4_DR
#define USBUART_USB__ARB_RW4_RA CYREG_USB_ARB_RW4_RA
#define USBUART_USB__ARB_RW4_RA_MSB CYREG_USB_ARB_RW4_RA_MSB
#define USBUART_USB__ARB_RW4_WA CYREG_USB_ARB_RW4_WA
#define USBUART_USB__ARB_RW4_WA_MSB CYREG_USB_ARB_RW4_WA_MSB
#define USBUART_USB__ARB_RW5_DR CYREG_USB_ARB_RW5_DR
#define USBUART_USB__ARB_RW5_RA CYREG_USB_ARB_RW5_RA
#define USBUART_USB__ARB_RW5_RA_MSB CYREG_USB_ARB_RW5_RA_MSB
#define USBUART_USB__ARB_RW5_WA CYREG_USB_ARB_RW5_WA
#define USBUART_USB__ARB_RW5_WA_MSB CYREG_USB_ARB_RW5_WA_MSB
#define USBUART_USB__ARB_RW6_DR CYREG_USB_ARB_RW6_DR
#define USBUART_USB__ARB_RW6_RA CYREG_USB_ARB_RW6_RA
#define USBUART_USB__ARB_RW6_RA_MSB CYREG_USB_ARB_RW6_RA_MSB
#define USBUART_USB__ARB_RW6_WA CYREG_USB_ARB_RW6_WA
#define USBUART_USB__ARB_RW6_WA_MSB CYREG_USB_ARB_RW6_WA_MSB
#define USBUART_USB__ARB_RW7_DR CYREG_USB_ARB_RW7_DR
#define USBUART_USB__ARB_RW7_RA CYREG_USB_ARB_RW7_RA
#define USBUART_USB__ARB_RW7_RA_MSB CYREG_USB_ARB_RW7_RA_MSB
#define USBUART_USB__ARB_RW7_WA CYREG_USB_ARB_RW7_WA
#define USBUART_USB__ARB_RW7_WA_MSB CYREG_USB_ARB_RW7_WA_MSB
#define USBUART_USB__ARB_RW8_DR CYREG_USB_ARB_RW8_DR
#define USBUART_USB__ARB_RW8_RA CYREG_USB_ARB_RW8_RA
#define USBUART_USB__ARB_RW8_RA_MSB CYREG_USB_ARB_RW8_RA_MSB
#define USBUART_USB__ARB_RW8_WA CYREG_USB_ARB_RW8_WA
#define USBUART_USB__ARB_RW8_WA_MSB CYREG_USB_ARB_RW8_WA_MSB
#define USBUART_USB__BUF_SIZE CYREG_USB_BUF_SIZE
#define USBUART_USB__BUS_RST_CNT CYREG_USB_BUS_RST_CNT
#define USBUART_USB__CR0 CYREG_USB_CR0
#define USBUART_USB__CR1 CYREG_USB_CR1
#define USBUART_USB__CWA CYREG_USB_CWA
#define USBUART_USB__CWA_MSB CYREG_USB_CWA_MSB
#define USBUART_USB__DMA_THRES CYREG_USB_DMA_THRES
#define USBUART_USB__DMA_THRES_MSB CYREG_USB_DMA_THRES_MSB
#define USBUART_USB__DYN_RECONFIG CYREG_USB_DYN_RECONFIG
#define USBUART_USB__EP_ACTIVE CYREG_USB_EP_ACTIVE
#define USBUART_USB__EP_TYPE CYREG_USB_EP_TYPE
#define USBUART_USB__EP0_CNT CYREG_USB_EP0_CNT
#define USBUART_USB__EP0_CR CYREG_USB_EP0_CR
#define USBUART_USB__EP0_DR0 CYREG_USB_EP0_DR0
#define USBUART_USB__EP0_DR1 CYREG_USB_EP0_DR1
#define USBUART_USB__EP0_DR2 CYREG_USB_EP0_DR2
#define USBUART_USB__EP0_DR3 CYREG_USB_EP0_DR3
#define USBUART_USB__EP0_DR4 CYREG_USB_EP0_DR4
#define USBUART_USB__EP0_DR5 CYREG_USB_EP0_DR5
#define USBUART_USB__EP0_DR6 CYREG_USB_EP0_DR6
#define USBUART_USB__EP0_DR7 CYREG_USB_EP0_DR7
#define USBUART_USB__MEM_DATA CYREG_USB_MEM_DATA_MBASE
#define USBUART_USB__PM_ACT_CFG CYREG_PM_ACT_CFG5
#define USBUART_USB__PM_ACT_MSK 0x01u
#define USBUART_USB__PM_STBY_CFG CYREG_PM_STBY_CFG5
#define USBUART_USB__PM_STBY_MSK 0x01u
#define USBUART_USB__SIE_EP_INT_EN CYREG_USB_SIE_EP_INT_EN
#define USBUART_USB__SIE_EP_INT_SR CYREG_USB_SIE_EP_INT_SR
#define USBUART_USB__SIE_EP1_CNT0 CYREG_USB_SIE_EP1_CNT0
#define USBUART_USB__SIE_EP1_CNT1 CYREG_USB_SIE_EP1_CNT1
#define USBUART_USB__SIE_EP1_CR0 CYREG_USB_SIE_EP1_CR0
#define USBUART_USB__SIE_EP2_CNT0 CYREG_USB_SIE_EP2_CNT0
#define USBUART_USB__SIE_EP2_CNT1 CYREG_USB_SIE_EP2_CNT1
#define USBUART_USB__SIE_EP2_CR0 CYREG_USB_SIE_EP2_CR0
#define USBUART_USB__SIE_EP3_CNT0 CYREG_USB_SIE_EP3_CNT0
#define USBUART_USB__SIE_EP3_CNT1 CYREG_USB_SIE_EP3_CNT1
#define USBUART_USB__SIE_EP3_CR0 CYREG_USB_SIE_EP3_CR0
#define USBUART_USB__SIE_EP4_CNT0 CYREG_USB_SIE_EP4_CNT0
#define USBUART_USB__SIE_EP4_CNT1 CYREG_USB_SIE_EP4_CNT1
#define USBUART_USB__SIE_EP4_CR0 CYREG_USB_SIE_EP4_CR0
#define USBUART_USB__SIE_EP5_CNT0 CYREG_USB_SIE_EP5_CNT0
#define USBUART_USB__SIE_EP5_CNT1 CYREG_USB_SIE_EP5_CNT1
#define USBUART_USB__SIE_EP5_CR0 CYREG_USB_SIE_EP5_CR0
#define USBUART_USB__SIE_EP6_CNT0 CYREG_USB_SIE_EP6_CNT0
#define USBUART_USB__SIE_EP6_CNT1 CYREG_USB_SIE_EP6_CNT1
#define USBUART_USB__SIE_EP6_CR0 CYREG_USB_SIE_EP6_CR0
#define USBUART_USB__SIE_EP7_CNT0 CYREG_USB_SIE_EP7_CNT0
#define USBUART_USB__SIE_EP7_CNT1 CYREG_USB_SIE_EP7_CNT1
#define USBUART_USB__SIE_EP7_CR0 CYREG_USB_SIE_EP7_CR0
#define USBUART_USB__SIE_EP8_CNT0 CYREG_USB_SIE_EP8_CNT0
#define USBUART_USB__SIE_EP8_CNT1 CYREG_USB_SIE_EP8_CNT1
#define USBUART_USB__SIE_EP8_CR0 CYREG_USB_SIE_EP8_CR0
#define USBUART_USB__SOF0 CYREG_USB_SOF0
#define USBUART_USB__SOF1 CYREG_USB_SOF1
#define USBUART_USB__USB_CLK_EN CYREG_USB_USB_CLK_EN
#define USBUART_USB__USBIO_CR0 CYREG_USB_USBIO_CR0
#define USBUART_USB__USBIO_CR1 CYREG_USB_USBIO_CR1

/* Control_Reg_1 */
#define Control_Reg_1_Sync_ctrl_reg__0__MASK 0x01u
#define Control_Reg_1_Sync_ctrl_reg__0__POS 0
#define Control_Reg_1_Sync_ctrl_reg__16BIT_CONTROL_AUX_CTL_REG CYREG_B0_UDB13_14_ACTL
#define Control_Reg_1_Sync_ctrl_reg__16BIT_CONTROL_CONTROL_REG CYREG_B0_UDB13_14_CTL
#define Control_Reg_1_Sync_ctrl_reg__16BIT_CONTROL_COUNT_REG CYREG_B0_UDB13_14_CTL
#define Control_Reg_1_Sync_ctrl_reg__16BIT_COUNT_CONTROL_REG CYREG_B0_UDB13_14_CTL
#define Control_Reg_1_Sync_ctrl_reg__16BIT_COUNT_COUNT_REG CYREG_B0_UDB13_14_CTL
#define Control_Reg_1_Sync_ctrl_reg__16BIT_MASK_MASK_REG CYREG_B0_UDB13_14_MSK
#define Control_Reg_1_Sync_ctrl_reg__16BIT_MASK_PERIOD_REG CYREG_B0_UDB13_14_MSK
#define Control_Reg_1_Sync_ctrl_reg__16BIT_PERIOD_MASK_REG CYREG_B0_UDB13_14_MSK
#define Control_Reg_1_Sync_ctrl_reg__16BIT_PERIOD_PERIOD_REG CYREG_B0_UDB13_14_MSK
#define Control_Reg_1_Sync_ctrl_reg__CONTROL_AUX_CTL_REG CYREG_B0_UDB13_ACTL
#define Control_Reg_1_Sync_ctrl_reg__CONTROL_REG CYREG_B0_UDB13_CTL
#define Control_Reg_1_Sync_ctrl_reg__CONTROL_ST_REG CYREG_B0_UDB13_ST_CTL
#define Control_Reg_1_Sync_ctrl_reg__COUNT_REG CYREG_B0_UDB13_CTL
#define Control_Reg_1_Sync_ctrl_reg__COUNT_ST_REG CYREG_B0_UDB13_ST_CTL
#define Control_Reg_1_Sync_ctrl_reg__MASK 0x01u
#define Control_Reg_1_Sync_ctrl_reg__MASK_CTL_AUX_CTL_REG CYREG_B0_UDB13_MSK_ACTL
#define Control_Reg_1_Sync_ctrl_reg__PER_CTL_AUX_CTL_REG CYREG_B0_UDB13_MSK_ACTL
#define Control_Reg_1_Sync_ctrl_reg__PERIOD_REG CYREG_B0_UDB13_MSK

/* Miscellaneous */
#define BCLK__BUS_CLK__HZ 72000000U
#define BCLK__BUS_CLK__KHZ 72000U
#define BCLK__BUS_CLK__MHZ 72U
#define CY_PROJECT_NAME "AMS"
#define CY_VERSION "PSoC Creator  4.0 Update 1"
#define CYDEV_CHIP_DIE_LEOPARD 1u
#define CYDEV_CHIP_DIE_PSOC4A 12u
#define CYDEV_CHIP_DIE_PSOC5LP 19u
#define CYDEV_CHIP_DIE_PSOC5TM 20u
#define CYDEV_CHIP_DIE_TMA4 2u
#define CYDEV_CHIP_DIE_UNKNOWN 0u
#define CYDEV_CHIP_FAMILY_FM0P 4u
#define CYDEV_CHIP_FAMILY_FM3 5u
#define CYDEV_CHIP_FAMILY_FM4 6u
#define CYDEV_CHIP_FAMILY_PSOC3 1u
#define CYDEV_CHIP_FAMILY_PSOC4 2u
#define CYDEV_CHIP_FAMILY_PSOC5 3u
#define CYDEV_CHIP_FAMILY_UNKNOWN 0u
#define CYDEV_CHIP_FAMILY_USED CYDEV_CHIP_FAMILY_PSOC5
#define CYDEV_CHIP_JTAG_ID 0x2E161069u
#define CYDEV_CHIP_MEMBER_3A 1u
#define CYDEV_CHIP_MEMBER_4A 12u
#define CYDEV_CHIP_MEMBER_4C 18u
#define CYDEV_CHIP_MEMBER_4D 8u
#define CYDEV_CHIP_MEMBER_4E 4u
#define CYDEV_CHIP_MEMBER_4F 13u
#define CYDEV_CHIP_MEMBER_4G 2u
#define CYDEV_CHIP_MEMBER_4H 11u
#define CYDEV_CHIP_MEMBER_4I 17u
#define CYDEV_CHIP_MEMBER_4J 9u
#define CYDEV_CHIP_MEMBER_4K 10u
#define CYDEV_CHIP_MEMBER_4L 16u
#define CYDEV_CHIP_MEMBER_4M 15u
#define CYDEV_CHIP_MEMBER_4N 6u
#define CYDEV_CHIP_MEMBER_4O 5u
#define CYDEV_CHIP_MEMBER_4P 14u
#define CYDEV_CHIP_MEMBER_4Q 7u
#define CYDEV_CHIP_MEMBER_4U 3u
#define CYDEV_CHIP_MEMBER_5A 20u
#define CYDEV_CHIP_MEMBER_5B 19u
#define CYDEV_CHIP_MEMBER_FM3 24u
#define CYDEV_CHIP_MEMBER_FM4 25u
#define CYDEV_CHIP_MEMBER_PDL_FM0P_TYPE1 21u
#define CYDEV_CHIP_MEMBER_PDL_FM0P_TYPE2 22u
#define CYDEV_CHIP_MEMBER_PDL_FM0P_TYPE3 23u
#define CYDEV_CHIP_MEMBER_UNKNOWN 0u
#define CYDEV_CHIP_MEMBER_USED CYDEV_CHIP_MEMBER_5B
#define CYDEV_CHIP_DIE_EXPECT CYDEV_CHIP_MEMBER_USED
#define CYDEV_CHIP_DIE_ACTUAL CYDEV_CHIP_DIE_EXPECT
#define CYDEV_CHIP_REV_LEOPARD_ES1 0u
#define CYDEV_CHIP_REV_LEOPARD_ES2 1u
#define CYDEV_CHIP_REV_LEOPARD_ES3 3u
#define CYDEV_CHIP_REV_LEOPARD_PRODUCTION 3u
#define CYDEV_CHIP_REV_PSOC4A_ES0 17u
#define CYDEV_CHIP_REV_PSOC4A_PRODUCTION 17u
#define CYDEV_CHIP_REV_PSOC5LP_ES0 0u
#define CYDEV_CHIP_REV_PSOC5LP_PRODUCTION 0u
#define CYDEV_CHIP_REV_PSOC5TM_ES0 0u
#define CYDEV_CHIP_REV_PSOC5TM_ES1 1u
#define CYDEV_CHIP_REV_PSOC5TM_PRODUCTION 1u
#define CYDEV_CHIP_REV_TMA4_ES 17u
#define CYDEV_CHIP_REV_TMA4_ES2 33u
#define CYDEV_CHIP_REV_TMA4_PRODUCTION 17u
#define CYDEV_CHIP_REVISION_3A_ES1 0u
#define CYDEV_CHIP_REVISION_3A_ES2 1u
#define CYDEV_CHIP_REVISION_3A_ES3 3u
#define CYDEV_CHIP_REVISION_3A_PRODUCTION 3u
#define CYDEV_CHIP_REVISION_4A_ES0 17u
#define CYDEV_CHIP_REVISION_4A_PRODUCTION 17u
#define CYDEV_CHIP_REVISION_4C_PRODUCTION 0u
#define CYDEV_CHIP_REVISION_4D_PRODUCTION 0u
#define CYDEV_CHIP_REVISION_4E_PRODUCTION 0u
#define CYDEV_CHIP_REVISION_4F_PRODUCTION 0u
#define CYDEV_CHIP_REVISION_4F_PRODUCTION_256DMA 0u
#define CYDEV_CHIP_REVISION_4F_PRODUCTION_256K 0u
#define CYDEV_CHIP_REVISION_4G_ES 17u
#define CYDEV_CHIP_REVISION_4G_ES2 33u
#define CYDEV_CHIP_REVISION_4G_PRODUCTION 17u
#define CYDEV_CHIP_REVISION_4H_PRODUCTION 0u
#define CYDEV_CHIP_REVISION_4I_PRODUCTION 0u
#define CYDEV_CHIP_REVISION_4J_PRODUCTION 0u
#define CYDEV_CHIP_REVISION_4K_PRODUCTION 0u
#define CYDEV_CHIP_REVISION_4L_PRODUCTION 0u
#define CYDEV_CHIP_REVISION_4M_PRODUCTION 0u
#define CYDEV_CHIP_REVISION_4N_PRODUCTION 0u
#define CYDEV_CHIP_REVISION_4O_PRODUCTION 0u
#define CYDEV_CHIP_REVISION_4P_PRODUCTION 0u
#define CYDEV_CHIP_REVISION_4Q_PRODUCTION 0u
#define CYDEV_CHIP_REVISION_4U_PRODUCTION 0u
#define CYDEV_CHIP_REVISION_5A_ES0 0u
#define CYDEV_CHIP_REVISION_5A_ES1 1u
#define CYDEV_CHIP_REVISION_5A_PRODUCTION 1u
#define CYDEV_CHIP_REVISION_5B_ES0 0u
#define CYDEV_CHIP_REVISION_5B_PRODUCTION 0u
#define CYDEV_CHIP_REVISION_FM3_PRODUCTION 0u
#define CYDEV_CHIP_REVISION_FM4_PRODUCTION 0u
#define CYDEV_CHIP_REVISION_PDL_FM0P_TYPE1_PRODUCTION 0u
#define CYDEV_CHIP_REVISION_PDL_FM0P_TYPE2_PRODUCTION 0u
#define CYDEV_CHIP_REVISION_PDL_FM0P_TYPE3_PRODUCTION 0u
#define CYDEV_CHIP_REVISION_USED CYDEV_CHIP_REVISION_5B_PRODUCTION
#define CYDEV_CHIP_REV_EXPECT CYDEV_CHIP_REVISION_USED
#define CYDEV_CONFIG_FASTBOOT_ENABLED 1
#define CYDEV_CONFIG_UNUSED_IO_AllowButWarn 0
#define CYDEV_CONFIG_UNUSED_IO CYDEV_CONFIG_UNUSED_IO_AllowButWarn
#define CYDEV_CONFIG_UNUSED_IO_AllowWithInfo 1
#define CYDEV_CONFIG_UNUSED_IO_Disallowed 2
#define CYDEV_CONFIGURATION_COMPRESSED 1
#define CYDEV_CONFIGURATION_DMA 0
#define CYDEV_CONFIGURATION_ECC 1
#define CYDEV_CONFIGURATION_IMOENABLED CYDEV_CONFIG_FASTBOOT_ENABLED
#define CYDEV_CONFIGURATION_MODE_COMPRESSED 0
#define CYDEV_CONFIGURATION_MODE CYDEV_CONFIGURATION_MODE_COMPRESSED
#define CYDEV_CONFIGURATION_MODE_DMA 2
#define CYDEV_CONFIGURATION_MODE_UNCOMPRESSED 1
#define CYDEV_DEBUG_ENABLE_MASK 0x20u
#define CYDEV_DEBUG_ENABLE_REGISTER CYREG_MLOGIC_DEBUG
#define CYDEV_DEBUGGING_DPS_SWD 2
#define CYDEV_DEBUGGING_DPS_SWD_SWV 6
#define CYDEV_DEBUGGING_DPS CYDEV_DEBUGGING_DPS_SWD_SWV
#define CYDEV_DEBUGGING_ENABLE 1
#define CYDEV_DEBUGGING_XRES 0
#define CYDEV_DMA_CHANNELS_AVAILABLE 24u
#define CYDEV_ECC_ENABLE 0
#define CYDEV_HEAP_SIZE 0x80
#define CYDEV_INSTRUCT_CACHE_ENABLED 1
#define CYDEV_INTR_RISING 0x00000000u
#define CYDEV_IS_EXPORTING_CODE 0
#define CYDEV_IS_IMPORTING_CODE 0
#define CYDEV_PROJ_TYPE 2
#define CYDEV_PROJ_TYPE_BOOTLOADER 1
#define CYDEV_PROJ_TYPE_LAUNCHER 5
#define CYDEV_PROJ_TYPE_LOADABLE 2
#define CYDEV_PROJ_TYPE_LOADABLEANDBOOTLOADER 4
#define CYDEV_PROJ_TYPE_MULTIAPPBOOTLOADER 3
#define CYDEV_PROJ_TYPE_STANDARD 0
#define CYDEV_PROTECTION_ENABLE 0
#define CYDEV_STACK_SIZE 0x0800
#define CYDEV_USB_CLK_OSC_LOCKING_ENABLED_AT_PWR_UP 
#define CYDEV_USE_BUNDLED_CMSIS 1
#define CYDEV_VARIABLE_VDDA 0
#define CYDEV_VDDA 5.0
#define CYDEV_VDDA_MV 5000
#define CYDEV_VDDD 5.0
#define CYDEV_VDDD_MV 5000
#define CYDEV_VDDIO0 5.0
#define CYDEV_VDDIO0_MV 5000
#define CYDEV_VDDIO1 5.0
#define CYDEV_VDDIO1_MV 5000
#define CYDEV_VDDIO2 5.0
#define CYDEV_VDDIO2_MV 5000
#define CYDEV_VDDIO3 5.0
#define CYDEV_VDDIO3_MV 5000
#define CYDEV_VIO0 5.0
#define CYDEV_VIO0_MV 5000
#define CYDEV_VIO1 5.0
#define CYDEV_VIO1_MV 5000
#define CYDEV_VIO2 5.0
#define CYDEV_VIO2_MV 5000
#define CYDEV_VIO3 5.0
#define CYDEV_VIO3_MV 5000
#define CYIPBLOCK_ARM_CM3_VERSION 0
#define CYIPBLOCK_P3_ANAIF_VERSION 0
#define CYIPBLOCK_P3_CAN_VERSION 0
#define CYIPBLOCK_P3_CAPSENSE_VERSION 0
#define CYIPBLOCK_P3_COMP_VERSION 0
#define CYIPBLOCK_P3_DECIMATOR_VERSION 0
#define CYIPBLOCK_P3_DFB_VERSION 0
#define CYIPBLOCK_P3_DMA_VERSION 0
#define CYIPBLOCK_P3_DRQ_VERSION 0
#define CYIPBLOCK_P3_DSM_VERSION 0
#define CYIPBLOCK_P3_EMIF_VERSION 0
#define CYIPBLOCK_P3_I2C_VERSION 0
#define CYIPBLOCK_P3_LCD_VERSION 0
#define CYIPBLOCK_P3_LPF_VERSION 0
#define CYIPBLOCK_P3_OPAMP_VERSION 0
#define CYIPBLOCK_P3_PM_VERSION 0
#define CYIPBLOCK_P3_SCCT_VERSION 0
#define CYIPBLOCK_P3_TIMER_VERSION 0
#define CYIPBLOCK_P3_USB_VERSION 0
#define CYIPBLOCK_P3_VIDAC_VERSION 0
#define CYIPBLOCK_P3_VREF_VERSION 0
#define CYIPBLOCK_S8_GPIO_VERSION 0
#define CYIPBLOCK_S8_IRQ_VERSION 0
#define CYIPBLOCK_S8_SAR_VERSION 0
#define CYIPBLOCK_S8_SIO_VERSION 0
#define CYIPBLOCK_S8_UDB_VERSION 0
#define DMA_CHANNELS_USED__MASK0 0x00000000u
#define CYDEV_BOOTLOADER_ENABLE 0

#endif /* INCLUDED_CYFITTER_H */
