UNCAMotorsports/UNCAMotorsports-2017/C-CAN/C-CAN_PSoC_DevKit/C-CAN.cydsn/codegentemp/CAN_1_TX_RX_func.c

/*******************************************************************************
* File Name: CAN_1_TX_RX_func.c
* Version 3.0
*
* Description:
*  There are functions process "Full" Receive and Transmit mailboxes:
*     - CAN_1_SendMsg0-7();
*     - CAN_1_ReceiveMsg0-15();
*  Transmission of message, and receive routine for "Basic" mailboxes:
*     - CAN_1_SendMsg();
*     - CAN_1_TxCancel();
*     - CAN_1_ReceiveMsg();
*
*  Note:
*   None
*
********************************************************************************
* Copyright 2008-2015, Cypress Semiconductor Corporation.  All rights reserved.
* You may use this file only in accordance with the license, terms, conditions,
* disclaimers, and limitations in the end user license agreement accompanying
* the software package with which this file was provided.
*******************************************************************************/

#include "CAN_1.h"


/* `#START TX_RX_FUNCTION` */

#define DATALENGTH1 0x08
extern uint8 TxMessage0[8];
extern uint8 TxMessage1[8];
extern uint8 TxMessage2[8];
extern uint8 TxMessage3[8];
extern uint8 RxMessage1[8];
extern uint8 RXDLC1;
extern uint8 RxFlag1;
uint8 bIndex;
uint8 bIndex1;

/* `#END` */


/*******************************************************************************
* FUNCTION NAME:   CAN_1_SendMsg
********************************************************************************
*
* Summary:
*  This function is Send Message from one of Basic mailboxes. The function loops
*  through the transmit message buffer designed as Basic CAN mailboxes for the
*  first free available and sends from it. The number of retries is limited.
*
* Parameters:
*  message: The pointer to a structure that contains all required data to send
*           messages.
*
* Return:
*  Indication if message has been sent.
*   Define                             Description
*    CYRET_SUCCESS                      The function passed successfully
*    CAN_1_FAIL              The function failed
*
*******************************************************************************/
uint8 CAN_1_SendMsg(const CAN_1_TX_MSG *message) 
{
    uint8 i, j, shift;
    uint8 retry = 0u;
    uint8 result = CAN_1_FAIL;
    uint32 regTemp;

    while (retry < CAN_1_RETRY_NUMBER)
    {
        shift = 1u;    /* Start from first mailbox */
        for (i = 0u; i < CAN_1_NUMBER_OF_TX_MAILBOXES; i++)
        {
            /* Find Basic TX mailboxes */
            if ((CAN_1_TX_MAILBOX_TYPE & shift) == 0u)
            {
                /* Find free mailbox */
                #if (CY_PSOC3 || CY_PSOC5)
                    if ((CAN_1_BUF_SR_REG.byte[2] & shift) == 0u)
                #else  /* CY_PSOC4 */
                    if ((CAN_1_BUF_SR_REG &
                        (uint32) ((uint32) shift << CAN_1_TWO_BYTE_OFFSET)) == 0u)
                #endif /* CY_PSOC3 || CY_PSOC5 */
                    {
                        regTemp = 0u;

                        /* Set message parameters */
                        if (message->rtr != CAN_1_STANDARD_MESSAGE)
                        {
                            regTemp = CAN_1_TX_RTR_MASK;    /* RTR message Enable */
                        }

                        if (message->ide == CAN_1_STANDARD_MESSAGE)
                        {
                            CAN_1_SET_TX_ID_STANDARD_MSG(i, message->id);
                        }
                        else
                        {
                            regTemp |= CAN_1_TX_IDE_MASK;
                            CAN_1_SET_TX_ID_EXTENDED_MSG(i, message->id);
                        }

                        if (message->dlc < CAN_1_TX_DLC_MAX_VALUE)
                        {
                            regTemp |= ((uint32) message->dlc) << CAN_1_TWO_BYTE_OFFSET;
                        }
                        else
                        {
                            regTemp |= CAN_1_TX_DLC_UPPER_VALUE;
                        }

                        if (message->irq != CAN_1_TRANSMIT_INT_DISABLE)
                        {
                            regTemp |= CAN_1_TX_INT_ENABLE_MASK;    /* Transmit Interrupt Enable */
                        }

                        for (j = 0u; (j < message->dlc) && (j < CAN_1_TX_DLC_MAX_VALUE); j++)
                        {
                            #if (CY_PSOC3 || CY_PSOC5)
                                CAN_1_TX_DATA_BYTE(i, j) = message->msg->byte[j];
                            #else /* CY_PSOC4 */
                                CAN_1_TX_DATA_BYTE(i, j, message->msg->byte[j]);
                            #endif /* CY_PSOC3 || CY_PSOC5 */
                        }

                        /* Disable isr */
    CyIntDisable(CAN_1_ISR_NUMBER);

                        /* WPN[23] and WPN[3] set to 1 for write to CAN Control reg */
                        CY_SET_REG32(CAN_1_TX_CMD_PTR(i), (regTemp | CAN_1_TX_WPN_SET));

                        #if (CY_PSOC3 || CY_PSOC5)
                            CY_SET_REG32(CAN_1_TX_CMD_PTR(i), CAN_1_SEND_MESSAGE);
                        #else /* CY_PSOC4 */
                            if (message->sst != CAN_1_STANDARD_MESSAGE)
                            {
                                /* Single Shot Transmission */
                                CAN_1_TX_CMD_REG(i) |= CAN_1_SEND_MESSAGE |
                                CAN_1_TX_ABORT_MASK;
                            }
                            else
                            {
                                CAN_1_TX_CMD_REG(i) |= CAN_1_SEND_MESSAGE;
                            }
                        #endif /* CY_PSOC3 || CY_PSOC5 */

                        /* Enable isr */
    CyIntEnable(CAN_1_ISR_NUMBER);

                        result = CYRET_SUCCESS;
                    }
            }
            shift <<= 1u;
            if (result == CYRET_SUCCESS)
            {
                break;
            }
        }
        if (result == CYRET_SUCCESS)
        {
            break;
        }
        else
        {
            retry++;
        }
    }

    return (result);
}


/*******************************************************************************
* FUNCTION NAME:   CAN_1_TxCancel
********************************************************************************
*
* Summary:
*  This function cancels transmission of a message that has been queued to be
*  transmitted. Values between 0 and 7 are valid.
*
* Parameters:
*  bufferId: The mailbox number.
*
* Return:
*  None.
*
*******************************************************************************/
void CAN_1_TxCancel(uint8 bufferId) 
{
    if (bufferId < CAN_1_NUMBER_OF_TX_MAILBOXES)
    {
        CAN_1_TX_ABORT_MESSAGE(bufferId);
    }
}


#if (CAN_1_TX0_FUNC_ENABLE)
    /*******************************************************************************
    * FUNCTION NAME:   CAN_1_SendMsg0
    ********************************************************************************
    *
    * Summary:
    *  This function is the entry point to Transmit Message 0. The function checks
    *  if mailbox 0 doesn't already have un-transmitted messages waiting for
    *  arbitration. If not initiate transmission of the message.
    *  Generated only for the Transmit mailbox designed as Full.
    *
    * Parameters:
    *  None.
    *
    * Return:
    *  Indication if Message has been sent.
    *   Define                             Description
    *    CYRET_SUCCESS                      The function passed successfully
    *    CAN_1_FAIL              The function failed
    *
    *******************************************************************************/
    uint8 CAN_1_SendMsg0(void) 
    {
        uint8 result = CYRET_SUCCESS;

        #if (CY_PSOC3 || CY_PSOC5)
            if ((CAN_1_TX[0u].txcmd.byte[0u] & CAN_1_TX_REQUEST_PENDING) != 0u)
        #else  /* CY_PSOC4 */
            if ((CAN_1_TX_CMD_REG(0u) & CAN_1_TX_REQUEST_PENDING) != 0u)
        #endif /* CY_PSOC3 || CY_PSOC5 */
            {
                result = CAN_1_FAIL;
            }
            else
            {
                /* `#START MESSAGE_0_TRASMITTED` */
                for(bIndex=0;bIndex<DATALENGTH1;bIndex++){
                    CAN_1_TX_DATA_BYTE(0,bIndex) = TxMessage0[bIndex];
                }
                /* `#END` */

                #ifdef CAN_1_SEND_MSG_0_CALLBACK
                    CAN_1_SendMsg_0_Callback();
                #endif /* CAN_1_SEND_MSG_0_CALLBACK */

                CY_SET_REG32(CAN_1_TX_CMD_PTR(0u),
                CY_GET_REG32(CAN_1_TX_CMD_PTR(0u)) | CAN_1_SEND_MESSAGE);
            }

        return (result);
    }
#endif /* CAN_1_TX0_FUNC_ENABLE */


#if (CAN_1_TX1_FUNC_ENABLE)
    /*******************************************************************************
    * FUNCTION NAME:   CAN_1_SendMsg1
    ********************************************************************************
    *
    * Summary:
    *  This function is the entry point to Transmit Message 1. The function checks
    *  if mailbox 1 doesn't already have un-transmitted messages waiting for
    *  arbitration. If not initiate transmission of the message.
    *  Generated only for the Transmit mailbox designed as Full.
    *
    * Parameters:
    *  None.
    *
    * Return:
    *  Indication if Message has been sent.
    *   Define                             Description
    *    CYRET_SUCCESS                      The function passed successfully
    *    CAN_1_FAIL              The function failed
    *
    *******************************************************************************/
    uint8 CAN_1_SendMsg1(void) 
    {
        uint8 result = CYRET_SUCCESS;

        #if (CY_PSOC3 || CY_PSOC5)
            if ((CAN_1_TX[1u].txcmd.byte[0u] & CAN_1_TX_REQUEST_PENDING) != 0u)
        #else  /* CY_PSOC4 */
            if ((CAN_1_TX_CMD_REG(1u) & CAN_1_TX_REQUEST_PENDING) != 0u)
        #endif /* CY_PSOC3 || CY_PSOC5 */
            {
                result = CAN_1_FAIL;
            }
            else
            {
                /* `#START MESSAGE_1_TRASMITTED` */
                for(bIndex1=0;bIndex1<DATALENGTH1;bIndex1++){
                    CAN_1_TX_DATA_BYTE(1,bIndex1) = TxMessage1[bIndex1];
                }
                /* `#END` */

                #ifdef CAN_1_SEND_MSG_1_CALLBACK
                    CAN_1_SendMsg_1_Callback();
                #endif /* CAN_1_SEND_MSG_1_CALLBACK */

                CY_SET_REG32(CAN_1_TX_CMD_PTR(1u),
                CY_GET_REG32(CAN_1_TX_CMD_PTR(1u)) | CAN_1_SEND_MESSAGE);
            }

        return (result);
    }
#endif /* CAN_1_TX1_FUNC_ENABLE */


#if (CAN_1_TX2_FUNC_ENABLE)
    /*******************************************************************************
    * FUNCTION NAME:   CAN_1_SendMsg2
    ********************************************************************************
    *
    * Summary:
    *  This function is the entry point to Transmit Message 2. The function checks
    *  if mailbox 2 doesn't already have un-transmitted messages waiting for
    *  arbitration. If not initiate transmission of the message.
    *  Generated only for the Transmit mailbox designed as Full.
    *
    * Parameters:
    *  None.
    *
    * Return:
    *  Indication if Message has been sent.
    *   Define                             Description
    *    CYRET_SUCCESS                      The function passed successfully
    *    CAN_1_FAIL              The function failed
    *
    *******************************************************************************/
    uint8 CAN_1_SendMsg2(void) 
    {
        uint8 result = CYRET_SUCCESS;

        #if (CY_PSOC3 || CY_PSOC5)
            if ((CAN_1_TX[2u].txcmd.byte[0u] & CAN_1_TX_REQUEST_PENDING) != 0u)
        #else  /* CY_PSOC4 */
            if ((CAN_1_TX_CMD_REG(2u) & CAN_1_TX_REQUEST_PENDING) != 0u)
        #endif /* CY_PSOC3 || CY_PSOC5 */
            {
                result = CAN_1_FAIL;
            }
            else
            {
                /* `#START MESSAGE_2_TRASMITTED` */
                for(bIndex1=0;bIndex1<DATALENGTH1;bIndex1++){
                    CAN_1_TX_DATA_BYTE(2,bIndex1) = TxMessage2[bIndex1];
                }
                /* `#END` */

                #ifdef CAN_1_SEND_MSG_2_CALLBACK
                    CAN_1_SendMsg_2_Callback();
                #endif /* CAN_1_SEND_MSG_2_CALLBACK */

                CY_SET_REG32(CAN_1_TX_CMD_PTR(2u),
                CY_GET_REG32(CAN_1_TX_CMD_PTR(2u)) | CAN_1_SEND_MESSAGE);
            }

        return (result);
    }
#endif /* CAN_1_TX2_FUNC_ENABLE */


#if (CAN_1_TX3_FUNC_ENABLE)
    /*******************************************************************************
    * FUNCTION NAME:   CAN_1_SendMsg3
    ********************************************************************************
    *
    * Summary:
    *  This function is the entry point to Transmit Message 3. The function checks
    *  if mailbox 3 doesn't already have un-transmitted messages waiting for
    *  arbitration. If not initiate transmission of the message.
    *  Generated only for the Transmit mailbox designed as Full.
    *
    * Parameters:
    *  None.
    *
    * Return:
    *  Indication if Message has been sent.
    *   Define                             Description
    *    CYRET_SUCCESS                      The function passed successfully
    *    CAN_1_FAIL              The function failed
    *
    *******************************************************************************/
    uint8 CAN_1_SendMsg3(void) 
    {
        uint8 result = CYRET_SUCCESS;

        #if (CY_PSOC3 || CY_PSOC5)
            if ((CAN_1_TX[3u].txcmd.byte[0u] & CAN_1_TX_REQUEST_PENDING) != 0u)
        #else  /* CY_PSOC4 */
            if ((CAN_1_TX_CMD_REG(3u) & CAN_1_TX_REQUEST_PENDING) != 0u)
        #endif /* CY_PSOC3 || CY_PSOC5 */
            {
                result = CAN_1_FAIL;
            }
            else
            {
                /* `#START MESSAGE_3_TRASMITTED` */
                for(bIndex1=0;bIndex1<DATALENGTH1;bIndex1++){
                    CAN_1_TX_DATA_BYTE(3,bIndex1) = TxMessage3[bIndex1];
                }
                /* `#END` */

                #ifdef CAN_1_SEND_MSG_3_CALLBACK
                    CAN_1_SendMsg_3_Callback();
                #endif /* CAN_1_SEND_MSG_3_CALLBACK */

                CY_SET_REG32(CAN_1_TX_CMD_PTR(3u),
                CY_GET_REG32(CAN_1_TX_CMD_PTR(3u)) | CAN_1_SEND_MESSAGE);
            }

        return (result);
    }
#endif /* CAN_1_TX3_FUNC_ENABLE */


#if (CAN_1_TX4_FUNC_ENABLE)
    /*******************************************************************************
    * FUNCTION NAME:   CAN_1_SendMsg4
    ********************************************************************************
    *
    * Summary:
    *  This function is the entry point to Transmit Message 4. The function checks
    *  if mailbox 4 doesn't already have un-transmitted messages waiting for
    *  arbitration. If not initiate transmission of the message.
    *  Generated only for the Transmit mailbox designed as Full.
    *
    * Parameters:
    *  None.
    *
    * Return:
    *  Indication if Message has been sent.
    *   Define                             Description
    *    CYRET_SUCCESS                      The function passed successfully
    *    CAN_1_FAIL              The function failed
    *
    *******************************************************************************/
    uint8 CAN_1_SendMsg4(void) 
    {
        uint8 result = CYRET_SUCCESS;

        #if (CY_PSOC3 || CY_PSOC5)
            if ((CAN_1_TX[4u].txcmd.byte[0u] & CAN_1_TX_REQUEST_PENDING) != 0u)
        #else  /* CY_PSOC4 */
            if ((CAN_1_TX_CMD_REG(4u) & CAN_1_TX_REQUEST_PENDING) != 0u)
        #endif /* CY_PSOC3 || CY_PSOC5 */
            {
                result = CAN_1_FAIL;
            }
            else
            {
                /* `#START MESSAGE_4_TRASMITTED` */

                /* `#END` */

                #ifdef CAN_1_SEND_MSG_4_CALLBACK
                    CAN_1_SendMsg_4_Callback();
                #endif /* CAN_1_SEND_MSG_4_CALLBACK */

                CY_SET_REG32(CAN_1_TX_CMD_PTR(4u),
                CY_GET_REG32(CAN_1_TX_CMD_PTR(4u)) | CAN_1_SEND_MESSAGE);
            }

        return (result);
    }
#endif /* CAN_1_TX4_FUNC_ENABLE */


#if (CAN_1_TX5_FUNC_ENABLE)
    /*******************************************************************************
    * FUNCTION NAME:   CAN_1_SendMsg5
    ********************************************************************************
    *
    * Summary:
    *  This function is the entry point to Transmit Message 5. The function checks
    *  if mailbox 5 doesn't already have un-transmitted messages waiting for
    *  arbitration. If not initiate transmission of the message.
    *  Generated only for the Transmit mailbox designed as Full.
    *
    * Parameters:
    *  None.
    *
    * Return:
    *  Indication if Message has been sent.
    *   Define                             Description
    *    CYRET_SUCCESS                      The function passed successfully
    *    CAN_1_FAIL              The function failed
    *
    *******************************************************************************/
    uint8 CAN_1_SendMsg5(void) 
    {
        uint8 result = CYRET_SUCCESS;

        #if (CY_PSOC3 || CY_PSOC5)
            if ((CAN_1_TX[5u].txcmd.byte[0u] & CAN_1_TX_REQUEST_PENDING) != 0u)
        #else  /* CY_PSOC4 */
            if ((CAN_1_TX_CMD_REG(5u) & CAN_1_TX_REQUEST_PENDING) != 0u)
        #endif /* CY_PSOC3 || CY_PSOC5 */
            {
                result = CAN_1_FAIL;
            }
            else
            {
                /* `#START MESSAGE_5_TRASMITTED` */

                /* `#END` */

                #ifdef CAN_1_SEND_MSG_5_CALLBACK
                    CAN_1_SendMsg_5_Callback();
                #endif /* CAN_1_SEND_MSG_5_CALLBACK */

                CY_SET_REG32(CAN_1_TX_CMD_PTR(5u),
                CY_GET_REG32(CAN_1_TX_CMD_PTR(5u)) | CAN_1_SEND_MESSAGE);
            }

        return (result);
    }
#endif /* CAN_1_TX5_FUNC_ENABLE */


#if (CAN_1_TX6_FUNC_ENABLE)
    /*******************************************************************************
    * FUNCTION NAME:   CAN_1_SendMsg6
    ********************************************************************************
    *
    * Summary:
    *  This function is the entry point to Transmit Message 6. The function checks
    *  if mailbox 6 doesn't already have un-transmitted messages waiting for
    *  arbitration. If not initiate transmission of the message.
    *  Generated only for the Transmit mailbox designed as Full.
    *
    * Parameters:
    *  None.
    *
    * Return:
    *  Indication if Message has been sent.
    *   Define                             Description
    *    CYRET_SUCCESS                      The function passed successfully
    *    CAN_1_FAIL              The function failed
    *
    *******************************************************************************/
    uint8 CAN_1_SendMsg6(void) 
    {
        uint8 result = CYRET_SUCCESS;

        #if (CY_PSOC3 || CY_PSOC5)
            if ((CAN_1_TX[6u].txcmd.byte[0u] & CAN_1_TX_REQUEST_PENDING) != 0u)
        #else  /* CY_PSOC4 */
            if ((CAN_1_TX_CMD_REG(6u) & CAN_1_TX_REQUEST_PENDING) != 0u)
        #endif /* CY_PSOC3 || CY_PSOC5 */
            {
                result = CAN_1_FAIL;
            }
            else
            {
                /* `#START MESSAGE_6_TRASMITTED` */

                /* `#END` */

                #ifdef CAN_1_SEND_MSG_6_CALLBACK
                    CAN_1_SendMsg_6_Callback();
                #endif /* CAN_1_SEND_MSG_6_CALLBACK */

                CY_SET_REG32(CAN_1_TX_CMD_PTR(6u),
                CY_GET_REG32(CAN_1_TX_CMD_PTR(6u)) | CAN_1_SEND_MESSAGE);
            }

        return (result);
    }
#endif /* CAN_1_TX6_FUNC_ENABLE */


#if (CAN_1_TX7_FUNC_ENABLE)
    /*******************************************************************************
    * FUNCTION NAME:   CAN_1_SendMsg7)
    ********************************************************************************
    *
    * Summary:
    *  This function is the entry point to Transmit Message 7. The function checks
    *  if mailbox 7 doesn't already have un-transmitted messages waiting for
    *  arbitration. If not initiate transmission of the message.
    *  Generated only for the Transmit mailbox designed as Full.
    *
    * Parameters:
    *  None.
    *
    * Return:
    *  Indication if Message has been sent.
    *   Define                             Description
    *    CYRET_SUCCESS                      The function passed successfully
    *    CAN_1_FAIL              The function failed
    *
    *******************************************************************************/
    uint8 CAN_1_SendMsg7(void) 
    {
        uint8 result = CYRET_SUCCESS;

        #if (CY_PSOC3 || CY_PSOC5)
            if ((CAN_1_TX[7u].txcmd.byte[0u] & CAN_1_TX_REQUEST_PENDING) != 0u)
        #else  /* CY_PSOC4 */
            if ((CAN_1_TX_CMD_REG(7u) & CAN_1_TX_REQUEST_PENDING) != 0u)
        #endif /* CY_PSOC3 || CY_PSOC5 */
            {
                result = CAN_1_FAIL;
            }
            else
            {
                /* `#START MESSAGE_7_TRASMITTED` */

                /* `#END` */

                #ifdef CAN_1_SEND_MSG_7_CALLBACK
                    CAN_1_SendMsg_7_Callback();
                #endif /* CAN_1_SEND_MSG_7_CALLBACK */

                CY_SET_REG32(CAN_1_TX_CMD_PTR(7u),
                CY_GET_REG32(CAN_1_TX_CMD_PTR(7u)) | CAN_1_SEND_MESSAGE);
            }

        return (result);
    }
#endif /* CAN_1_TX7_FUNC_ENABLE */


/*******************************************************************************
* FUNCTION NAME:   CAN_1_ReceiveMsg
********************************************************************************
*
* Summary:
*  This function is the entry point to Receive Message Interrupt for Basic
*  mailboxes. Clears the Receive particular Message interrupt flag. Generated
*  only if one of the Receive mailboxes is designed as Basic.
*
* Parameters:
*  rxMailbox: The mailbox number that trig Receive Message Interrupt.
*
* Return:
*  None.
*
* Reentrant:
*  Depends on the Customer code.
*
*******************************************************************************/
void CAN_1_ReceiveMsg(uint8 rxMailbox) 
{
    #if (CY_PSOC3 || CY_PSOC5)
        if ((CAN_1_RX[rxMailbox].rxcmd.byte[0u] & CAN_1_RX_ACK_MSG) != 0u)
    #else  /* CY_PSOC4 */
        if ((CAN_1_RX_CMD_REG(rxMailbox) & CAN_1_RX_ACK_MSG) != 0u)
    #endif /* CY_PSOC3 || CY_PSOC5 */
        {
            /* `#START MESSAGE_BASIC_RECEIVED` */
            
            /* `#END` */

            #ifdef CAN_1_RECEIVE_MSG_CALLBACK
                CAN_1_ReceiveMsg_Callback();
            #endif /* CAN_1_RECEIVE_MSG_CALLBACK */

            #if (CY_PSOC3 || CY_PSOC5)
                CAN_1_RX[rxMailbox].rxcmd.byte[0u] |= CAN_1_RX_ACK_MSG;
            #else  /* CY_PSOC4 */
                CAN_1_RX_CMD_REG(rxMailbox) |= CAN_1_RX_ACK_MSG;
            #endif /* CY_PSOC3 || CY_PSOC5 */
        }
}


#if (CAN_1_RX0_FUNC_ENABLE)
    /*******************************************************************************
    * FUNCTION NAME:   CAN_1_ReceiveMsgStart
    ********************************************************************************
    *
    * Summary:
    *  This function is the entry point to Receive Message 0 Interrupt. Clears the
    *  Receive Message 0 interrupt flag. Generated only for the Receive mailbox
    *  designed as Full.
    *
    * Parameters:
    *  None.
    *
    * Return:
    *  None.
    *
    * Reentrant:
    *  Depends on the Customer code.
    *
    *******************************************************************************/
    void CAN_1_ReceiveMsgStart(void) 
    {
        /* `#START MESSAGE_Start_RECEIVED` */

        /* `#END` */

        #ifdef CAN_1_RECEIVE_MSG_Start_CALLBACK
            CAN_1_ReceiveMsg_Start_Callback();
        #endif /* CAN_1_RECEIVE_MSG_Start_CALLBACK */

        CAN_1_RX[0u].rxcmd.byte[0u] |= CAN_1_RX_ACK_MSG;
    }
#endif /* CAN_1_RX0_FUNC_ENABLE */


#if (CAN_1_RX1_FUNC_ENABLE)
    /*******************************************************************************
    * FUNCTION NAME:    CAN_1_ReceiveMsgMode
    ********************************************************************************
    *
    * Summary:
    *  This function is the entry point to Receive Message 1 Interrupt. Clears the
    *  Receive Message 1 interrupt flag. Generated only for the Receive mailbox
    *  designed as Full.
    *
    * Parameters:
    *  None.
    *
    * Return:
    *  None.
    *
    * Reentrant:
    *  Depends on the Customer code.
    *
    *******************************************************************************/
    void CAN_1_ReceiveMsgMode(void) 
    {
        /* `#START MESSAGE_Mode_RECEIVED` */

        /* `#END` */

        #ifdef CAN_1_RECEIVE_MSG_Mode_CALLBACK
            CAN_1_ReceiveMsg_Mode_Callback();
        #endif /* CAN_1_RECEIVE_MSG_Mode_CALLBACK */

        CAN_1_RX[1u].rxcmd.byte[0u] |= CAN_1_RX_ACK_MSG;
    }
#endif /* CAN_1_RX1_FUNC_ENABLE */


#if (CAN_1_RX2_FUNC_ENABLE)
    /*******************************************************************************
    * FUNCTION NAME:   CAN_1_ReceiveMsgID
    ********************************************************************************
    *
    * Summary:
    *  This function is the entry point to Receive Message 2 Interrupt. Clears the
    *  Receive Message 2 interrupt flag. Generated only for the Receive mailbox
    *  designed as Full.
    *
    * Parameters:
    *  None.
    *
    * Return:
    *  None.
    *
    * Reentrant:
    *  Depends on the Customer code.
    *
    *******************************************************************************/
    void CAN_1_ReceiveMsgID(void) 
    {
        /* `#START MESSAGE_ID_RECEIVED` */

        /* `#END` */

        #ifdef CAN_1_RECEIVE_MSG_ID_CALLBACK
            CAN_1_ReceiveMsg_ID_Callback();
        #endif /* CAN_1_RECEIVE_MSG_ID_CALLBACK */

        CAN_1_RX[2u].rxcmd.byte[0u] |= CAN_1_RX_ACK_MSG;
    }
#endif /* CAN_1_RX2_FUNC_ENABLE */


#if (CAN_1_RX3_FUNC_ENABLE)
    /*******************************************************************************
    * FUNCTION NAME:   CAN_1_ReceiveMsgName
    ********************************************************************************
    *
    * Summary:
    *  This function is the entry point to Receive Message 3 Interrupt. Clears the
    *  Receive Message 3 interrupt flag. Generated only for the Receive mailbox
    *  designed as Full.
    *
    * Parameters:
    *  None.
    *
    * Return:
    *  None.
    *
    * Reentrant:
    *  Depends on the Customer code.
    *
    *******************************************************************************/
    void CAN_1_ReceiveMsgName(void) 
    {
        /* `#START MESSAGE_Name_RECEIVED` */

        /* `#END` */

        #ifdef CAN_1_RECEIVE_MSG_Name_CALLBACK
            CAN_1_ReceiveMsg_Name_Callback();
        #endif /* CAN_1_RECEIVE_MSG_Name_CALLBACK */

        CAN_1_RX[3u].rxcmd.byte[0u] |= CAN_1_RX_ACK_MSG;
    }
#endif /* CAN_1_RX3_FUNC_ENABLE */


#if (CAN_1_RX4_FUNC_ENABLE)
    /*******************************************************************************
    * FUNCTION NAME:   CAN_1_ReceiveMsgStatus
    ********************************************************************************
    *
    * Summary:
    *  This function is the entry point to Receive Message 4 Interrupt. Clears the
    *  Receive Message 4 interrupt flag. Generated only for the Receive mailbox
    *  designed as Full.
    *
    * Parameters:
    *  None.
    *
    * Return:
    *  None.
    *
    * Reentrant:
    *  Depends on the Customer code.
    *
    *******************************************************************************/
    void CAN_1_ReceiveMsgStatus(void) 
    {
        /* `#START MESSAGE_Status_RECEIVED` */

        /* `#END` */

        #ifdef CAN_1_RECEIVE_MSG_Status_CALLBACK
            CAN_1_ReceiveMsg_Status_Callback();
        #endif /* CAN_1_RECEIVE_MSG_Status_CALLBACK */

        CAN_1_RX[4u].rxcmd.byte[0u] |= CAN_1_RX_ACK_MSG;
    }
#endif /* CAN_1_RX4_FUNC_ENABLE */


#if (CAN_1_RX5_FUNC_ENABLE)
    /*******************************************************************************
    * FUNCTION NAME:   CAN_1_ReceiveMsgGetConfig
    ********************************************************************************
    *
    * Summary:
    *  This function is the entry point to Receive Message 5 Interrupt. Clears the
    *  Receive Message 5 interrupt flag. Generated only for the Receive mailbox
    *  designed as Full.
    *
    * Parameters:
    *  None.
    *
    * Return:
    *  None.
    *
    * Reentrant:
    *  Depends on the Customer code.
    *
    *******************************************************************************/
    void CAN_1_ReceiveMsgGetConfig(void) 
    {
        /* `#START MESSAGE_GetConfig_RECEIVED` */

        /* `#END` */

        #ifdef CAN_1_RECEIVE_MSG_GetConfig_CALLBACK
            CAN_1_ReceiveMsg_GetConfig_Callback();
        #endif /* CAN_1_RECEIVE_MSG_GetConfig_CALLBACK */

        CAN_1_RX[5u].rxcmd.byte[0u] |= CAN_1_RX_ACK_MSG;
    }
#endif /* CAN_1_RX5_FUNC_ENABLE */


#if (CAN_1_RX6_FUNC_ENABLE)
    /*******************************************************************************
    * FUNCTION NAME:   CAN_1_ReceiveMsgUpdateConfig
    ********************************************************************************
    *
    * Summary:
    *  This function is the entry point to Receive Message 6 Interrupt. Clears the
    *  Receive Message 6 interrupt flag. Generated only for the Receive mailbox
    *  designed as Full.
    *
    * Parameters:
    *  None.
    *
    * Return:
    *  None.
    *
    * Reentrant:
    *  Depends on the Customer code.
    *
    *******************************************************************************/
    void CAN_1_ReceiveMsgUpdateConfig(void) 
    {
        /* `#START MESSAGE_UpdateConfig_RECEIVED` */
            
        /* `#END` */

        #ifdef CAN_1_RECEIVE_MSG_UpdateConfig_CALLBACK
            CAN_1_ReceiveMsg_UpdateConfig_Callback();
        #endif /* CAN_1_RECEIVE_MSG_UpdateConfig_CALLBACK */

        CAN_1_RX[6u].rxcmd.byte[0u] |= CAN_1_RX_ACK_MSG;
    }
#endif /* CAN_1_RX6_FUNC_ENABLE */


#if (CAN_1_RX7_FUNC_ENABLE)
    /*******************************************************************************
    * FUNCTION NAME:   CAN_1_ReceiveMsgSoftReset
    ********************************************************************************
    *
    * Summary:
    *  This function is the entry point to Receive Message 7 Interrupt. Clears the
    *  Receive Message 7 interrupt flag. Generated only for the Receive mailbox
    *  designed as Full.
    *
    * Parameters:
    *  None.
    *
    * Return:
    *  None.
    *
    * Reentrant:
    *  Depends on the Customer code.
    *
    *******************************************************************************/
    void CAN_1_ReceiveMsgSoftReset(void) 
    {
        /* `#START MESSAGE_SoftReset_RECEIVED` */

        /* `#END` */

        #ifdef CAN_1_RECEIVE_MSG_SoftReset_CALLBACK
            CAN_1_ReceiveMsg_SoftReset_Callback();
        #endif /* CAN_1_RECEIVE_MSG_SoftReset_CALLBACK */

        CAN_1_RX[7u].rxcmd.byte[0u] |= CAN_1_RX_ACK_MSG;
    }
#endif /* CAN_1_RX7_FUNC_ENABLE */


#if (CAN_1_RX8_FUNC_ENABLE)
    /*******************************************************************************
    * FUNCTION NAME:   CAN_1_ReceiveMsgHalt
    ********************************************************************************
    *
    * Summary:
    *  This function is the entry point to Receive Message 8 Interrupt. Clears the
    *  Receive Message 8 interrupt flag. Generated only for the Receive mailbox
    *  designed as Full.
    *
    * Parameters:
    *  None.
    *
    * Return:
    *  None.
    *
    * Reentrant:
    *  Depends on the Customer code.
    *
    *******************************************************************************/
    void CAN_1_ReceiveMsgHalt(void) 
    {
        /* `#START MESSAGE_Halt_RECEIVED` */

        /* `#END` */

        #ifdef CAN_1_RECEIVE_MSG_Halt_CALLBACK
            CAN_1_ReceiveMsg_Halt_Callback();
        #endif /* CAN_1_RECEIVE_MSG_Halt_CALLBACK */

        CAN_1_RX[8u].rxcmd.byte[0u] |= CAN_1_RX_ACK_MSG;
    }
#endif /* CAN_1_RX8_FUNC_ENABLE */


#if (CAN_1_RX9_FUNC_ENABLE)
    /*******************************************************************************
    * FUNCTION NAME:   CAN_1_ReceiveMsg9
    ********************************************************************************
    *
    * Summary:
    *  This function is the entry point to Receive Message 9 Interrupt. Clears the
    *  Receive Message 9 interrupt flag. Generated only for the Receive mailbox
    *  designed as Full.
    *
    * Parameters:
    *  None.
    *
    * Return:
    *  None.
    *
    * Reentrant:
    *  Depends on the Customer code.
    *
    *******************************************************************************/
    void CAN_1_ReceiveMsg9(void) 
    {
        /* `#START MESSAGE_9_RECEIVED` */

        /* `#END` */

        #ifdef CAN_1_RECEIVE_MSG_9_CALLBACK
            CAN_1_ReceiveMsg_9_Callback();
        #endif /* CAN_1_RECEIVE_MSG_9_CALLBACK */

        CAN_1_RX[9u].rxcmd.byte[0u] |= CAN_1_RX_ACK_MSG;
    }
#endif /* CAN_1_RX9_FUNC_ENABLE */


#if (CAN_1_RX10_FUNC_ENABLE)
    /*******************************************************************************
    * FUNCTION NAME:   CAN_1_ReceiveMsg10
    ********************************************************************************
    *
    * Summary:
    *  This function is the entry point to Receive Message 10 Interrupt. Clears the
    *  Receive Message 10 interrupt flag. Generated only for the Receive mailbox
    *  designed as Full.
    *
    * Parameters:
    *  None.
    *
    * Return:
    *  None.
    *
    * Reentrant:
    *  Depends on the Customer code.
    *
    *******************************************************************************/
    void CAN_1_ReceiveMsg10(void) 
    {
        /* `#START MESSAGE_10_RECEIVED` */

        /* `#END` */

        #ifdef CAN_1_RECEIVE_MSG_10_CALLBACK
            CAN_1_ReceiveMsg_10_Callback();
        #endif /* CAN_1_RECEIVE_MSG_10_CALLBACK */

        CAN_1_RX[10u].rxcmd.byte[0u] |= CAN_1_RX_ACK_MSG;
    }
#endif /* CAN_1_RX10_FUNC_ENABLE */


#if (CAN_1_RX11_FUNC_ENABLE)
    /*******************************************************************************
    * FUNCTION NAME:   CAN_1_ReceiveMsg11
    ********************************************************************************
    *
    * Summary:
    *  This function is the entry point to Receive Message 11 Interrupt. Clears the
    *  Receive Message 11 interrupt flag. Generated only for the Receive mailbox
    *  designed as Full.
    *
    * Parameters:
    *  None.
    *
    * Return:
    *  None.
    *
    * Reentrant:
    *  Depends on the Customer code.
    *
    *******************************************************************************/
    void CAN_1_ReceiveMsg11(void) 
    {
        /* `#START MESSAGE_11_RECEIVED` */

        /* `#END` */

        #ifdef CAN_1_RECEIVE_MSG_11_CALLBACK
            CAN_1_ReceiveMsg_11_Callback();
        #endif /* CAN_1_RECEIVE_MSG_11_CALLBACK */

        CAN_1_RX[11u].rxcmd.byte[0u] |= CAN_1_RX_ACK_MSG;
    }
#endif /* CAN_1_RX11_FUNC_ENABLE */


#if (CAN_1_RX12_FUNC_ENABLE)
    /*******************************************************************************
    * FUNCTION NAME:   CAN_1_ReceiveMsg12
    ********************************************************************************
    *
    * Summary:
    *  This function is the entry point to Receive Message 12 Interrupt. Clears the
    *  Receive Message 12 interrupt flag. Generated only for the Receive mailbox
    *  designed as Full.
    *
    * Parameters:
    *  None.
    *
    * Return:
    *  None.
    *
    * Reentrant:
    *  Depends on the Customer code.
    *
    *******************************************************************************/
    void CAN_1_ReceiveMsg12(void) 
    {
        /* `#START MESSAGE_12_RECEIVED` */

        /* `#END` */

        #ifdef CAN_1_RECEIVE_MSG_12_CALLBACK
            CAN_1_ReceiveMsg_12_Callback();
        #endif /* CAN_1_RECEIVE_MSG_12_CALLBACK */

        CAN_1_RX[12u].rxcmd.byte[0u] |= CAN_1_RX_ACK_MSG;
    }
#endif /* CAN_1_RX12_FUNC_ENABLE */


#if (CAN_1_RX13_FUNC_ENABLE)
    /*******************************************************************************
    * FUNCTION NAME:   CAN_1_ReceiveMsg13
    ********************************************************************************
    *
    * Summary:
    *  This function is the entry point to Receive Message 13 Interrupt. Clears the
    *  Receive Message 13 interrupt flag. Generated only for the Receive mailbox
    *  designed as Full.
    *
    * Parameters:
    *  None.
    *
    * Return:
    *  None.
    *
    * Reentrant:
    *  Depends on the Customer code.
    *
    *******************************************************************************/
    void CAN_1_ReceiveMsg13(void) 
    {
        /* `#START MESSAGE_13_RECEIVED` */

        /* `#END` */

        #ifdef CAN_1_RECEIVE_MSG_13_CALLBACK
            CAN_1_ReceiveMsg_13_Callback();
        #endif /* CAN_1_RECEIVE_MSG_13_CALLBACK */

        CAN_1_RX[13u].rxcmd.byte[0u] |= CAN_1_RX_ACK_MSG;
    }
#endif /* CAN_1_RX13_FUNC_ENABLE */


#if (CAN_1_RX14_FUNC_ENABLE)
    /*******************************************************************************
    * FUNCTION NAME:   CAN_1_ReceiveMsg14
    ********************************************************************************
    *
    * Summary:
    *  This function is the entry point to Receive Message 14 Interrupt. Clears the
    *  Receive Message 14 interrupt flag. Generated only for the Receive mailbox
    *  designed as Full.
    *
    * Parameters:
    *  None.
    *
    * Return:
    *  None.
    *
    * Reentrant:
    *  Depends on the Customer code.
    *
    *******************************************************************************/
    void CAN_1_ReceiveMsg14(void) 
    {
        /* `#START MESSAGE_14_RECEIVED` */

        /* `#END` */

        #ifdef CAN_1_RECEIVE_MSG_14_CALLBACK
            CAN_1_ReceiveMsg_14_Callback();
        #endif /* CAN_1_RECEIVE_MSG_14_CALLBACK */

        CAN_1_RX[14u].rxcmd.byte[0u] |= CAN_1_RX_ACK_MSG;
    }
#endif /* CAN_1_RX14_FUNC_ENABLE */


#if (CAN_1_RX15_FUNC_ENABLE)
    /*******************************************************************************
    * FUNCTION NAME:   CAN_1_ReceiveMsg15
    ********************************************************************************
    *
    * Summary:
    *  This function is the entry point to Receive Message 15 Interrupt. Clears the
    *  Receive Message 15 interrupt flag. Generated only for the Receive mailbox
    *  designed as Full.
    *
    * Parameters:
    *  None.
    *
    * Return:
    *  None.
    *
    * Reentrant:
    *  Depends on the Customer code.
    *
    *******************************************************************************/
    void CAN_1_ReceiveMsg15(void) 
    {
        /* `#START MESSAGE_15_RECEIVED` */

        /* `#END` */

        #ifdef CAN_1_RECEIVE_MSG_15_CALLBACK
            CAN_1_ReceiveMsg_15_Callback();
        #endif /* CAN_1_RECEIVE_MSG_15_CALLBACK */

        CAN_1_RX[15u].rxcmd.byte[0u] |= CAN_1_RX_ACK_MSG;
    }
#endif /* CAN_1_RX15_FUNC_ENABLE */


/* [] END OF FILE */
