UNCAMotorsports/UNCAMotorsports-2017/(commit log)

2016-11-11 Change Folder Structure
    [Aug31_Differential.csv, Aug31_no_differential.csv]
2016-11-11 Start VehicleController KiCad Project
    [VehicleController.kicad_pcb, VehicleController.sch]
2016-11-13 Create VehicleIMU schematic
    [VehicleIMU.kicad_pcb, VehicleIMU.sch]
2016-11-18 Interpret C-CAN throttle messages differently
2016-11-18 Added throttle calibation code to C-CAN
2016-11-23 Convert Energy Meter over to new Repo
    [Energy_Meter.kicad_pcb, Energy_Meter.sch]
2016-12-20 TestMule DAC changes, tractive system
    [Tractive System.kicad_pcb, Tractive System.sch]
2016-12-20 Energy Meter layout is done
    [Energy_Meter.sch]
2016-12-20 Changes to VehicleIMU, create CAT6_Adapter
    [CAT6_Adapater.kicad_pcb, CAT6_Adapater.sch, VehicleIMU.sch]
2016-12-20 Energy Meter tweaks
    [Energy_Meter-B.Cu.gbl, Energy_Meter-B.Mask.gbs, Energy_Meter-B.SilkS.gbo, Energy_Meter-Edge.Cuts.gm1, Energy_Meter-F.Cu.gtl, Energy_Meter-F.Mask.gts, Energy_Meter-F.SilkS.gto, Energy_Meter.drl]
2016-12-24 ESF_Diagrams and System Blocks lib
    [ESF_Diagrams.kicad_pcb, ESF_Diagrams.sch]
2016-12-24 Energy Meter is *more* done
    [Energy_Meter-B.Cu.gbl, Energy_Meter-B.Mask.gbs, Energy_Meter-B.SilkS.gbo, Energy_Meter-Edge.Cuts.gm1, Energy_Meter-F.Cu.gtl, Energy_Meter-F.Mask.gts, Energy_Meter-F.SilkS.gto, Energy_Meter.drl]
2016-12-24 CPL and CAT6 Adapter
    [CAT6_Adapater.kicad_pcb, CAT6_Adapater.sch]
2016-12-27 CAN bus ESF Diagram
    [ESF_Diagrams.sch]
2016-12-30 Throttle Implausibility Check
    The C-CAN responsible for throttle now checks to see if the throttle readings are implausible for more than 100ms
2016-12-30 Fixed throttle implausibility flag
    [main.c]
2016-12-30 Check for MSB in throttle for throttle implausibility
2016-12-30 Implement new timers, pass CAN message structs by pointer
2016-12-31 Updates to ESF Diagrams
    [ESF_Diagrams.sch]
2017-01-02 Throttle Implausiblity Check improvement
    A timer constant changes with the sampling rate to make the TIC rate-dependent
2017-01-02 Create TSAL
    [TSAL.kicad_pcb, TSAL.sch, VehicleController.sch]
2017-01-02 Small TSAL changes
    [TSAL.sch]
2017-01-04 Battery additions
    [ESF_Diagrams.sch]
2017-01-10 More work on ESF Diagrams
    [ESF_Diagrams.sch, file5874D542.sch]
2017-01-10 Energy Meter changes?
    [Energy_Meter.kicad_pcb]
2017-01-10 Brake system plausibility device
    Small work on BSPD circuit. Attempt at minimizing component cost and count.
    [bspd.kicad_pcb, bspd.sch]
2017-01-11 BSPD schematic done.
    Fuse and power entry included. Needs footprint association and pcb design still. Pausing here so that we have a schematic for the first ESF.
    [bspd.sch]
2017-01-11 BSPD progress, shutdown_circuit
    The shutdown_circuit schematic has been started. BSPD component association is half-way done.
    [bspd.sch, shutdown_circuit.kicad_pcb, shutdown_circuit.sch]
2017-01-13 ESF updates, TSAL board updates
    [ESF_Diagrams.sch, TSAL.sch]
2017-01-13 C-CAN changes
    Steering is now attached to sensor.one
2017-01-14 Update TestMule code to handle steering pot over CAN
2017-01-14 GLV Battery input schematic
    [ESF_Diagrams.sch, file5874D542.sch, file587991D1.sch]
2017-01-14 Update Teensy 3.5 symbol, recreate Vehicle Controller schematic
    [VehicleController.kicad_pcb, VehicleController.sch]
2017-01-17 Updates all around
    [PowerDistribution.sch, VehicleController.sch, file587991D1.sch]
2017-01-31 Fix 2
    [ESF_Diagrams.sch]
2017-02-01 Remake battery drawing
    [ESF_Diagrams.sch, file5874D542.sch]
2017-02-18 Remade battery drawing to new configuration
    [ESF_Diagrams.sch]
2017-02-23 Vehicle Controller updates
    [PowerDistribution.sch, VehicleController.sch, file58B2371B.sch, file58B363B0.sch]
2017-02-23 TSAL Done in a sane manner - schematic, footprint associations and BOM good. No PCB yet
    [tsal.sch]
2017-02-23 Accumulator changes
    [Accumulator.sch, ESF_Diagrams.sch, file5874D542.sch]
2017-02-23 Add boxes to ESF Diagram
    [ESF_Diagrams.sch]
2017-02-24 TSAL Updates
    [tsal.sch]
2017-02-24 Added SENtral Fusion Hub to VC Schematic
    [VehicleController.sch]
2017-02-24 Added GPS, DAC, Isolation sheet, buzzer to VC
    [PowerDistribution.sch, VehicleController.sch, file58B1642D.sch, file58B2371B.sch, file58B363B0.sch]
2017-02-24 Not sure what i changed
    [tsal.sch]
2017-02-24 Shutdown Circuit Relay Board
    The schematic has been started. The last thing is to pick the relay in KiCAD
2017-02-25 Add battery voltage sense, remove i2c pullups for UFS
    [VehicleController.sch]
2017-03-02 Began production C-CAN
    [C-CAN_Y17.kicad_pcb, C-CAN_Y17.sch]
2017-03-02 3D model of 16 pin, MX150_8 pin symbol
    [194270049.SLDPRT, 194270049.stp, VehicleController.sch, file58B1642D.sch, file58B363B0.sch]
2017-03-02 More work on new C-CAN
    [C-CAN_Y17.sch]
2017-03-02 Add MX150 8 pin, add Motor Controller connector
    [PowerDistribution.sch, VehicleController.sch, file58B1642D.sch, file58B2371B.sch, file58B363B0.sch]
2017-03-03 Add High-G Accel, connectors
    [PowerDistribution.sch, VehicleController.sch, file58B1642D.sch, file58B2371B.sch, file58B363B0.sch]
2017-03-04 C-CAN_Y17 done except for pcb
    [C-CAN_Y17.sch]
2017-03-04 Nearly finished with VC Schematic
    [PowerDistribution.sch, VehicleController.sch, file58B1642D.sch, file58B2371B.sch, file58B363B0.sch]
2017-03-05 Remove uneccesary junctions, add MX150 symbols
    [C-CAN_Y17.sch]
2017-03-05 Fix AP1117 error, remove extraneous PWR_FLAG
    [C-CAN_Y17.sch]
2017-03-06 C-CAN layout done. Needs to be compared to oshpark DRC still.
    [C-CAN_Y17.kicad_pcb, C-CAN_Y17.sch]
2017-03-07 C-CAN_Y17 Layout done, Oshpark DRC compliant
    Still need to do the BOM but everything on the KiCAD side is complete
    [C-CAN_Y17.kicad_pcb, C-CAN_Y17.sch]
2017-03-09 Added a bunch of step export files, some solidworks too for the C-CAN_Y17 Enclosure
    [Board_and_Connectors.SLDASM, C-CAN_Enclosure_1.SLDPRT, C-CAN_Y17.SLDPRT, C-CAN_Y17.kicad_pcb, C-CAN_Y17.sch, C-CAN_Y17.stp, COMPOUND.sldprt, C_CAN_Enclosure_2.SLDPRT]
2017-03-09 See if this fixes the question marks in Eeschema
    [C-CAN_Y17.sch]
2017-03-10 C-CAN Fixes
    [194270049.SLDPRT, 194270049.stp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]
2017-03-10 More status LEDs and fuses
    [PowerDistribution.sch, VehicleController.sch, file58B1642D.sch, file58B2371B.sch, file58B363B0.sch]
2017-03-10 C-CAN_Y17 Rev 1.0
    This is the C-CAN ordered on march 9th, 2017
    [C-CAN_Y17.kicad_pcb, C-CAN_Y17.sch]
2017-03-10 Begin nailing down VC schematic details
    [PowerDistribution.sch, VehicleController.sch, file58B1642D.sch, file58B2371B.sch, file58B363B0.sch]
2017-03-11 Finish VCU schematic, most footprint selections. Start layout
    [194270032.stp, PowerDistribution.sch, VehicleController.sch, file58B1642D.sch, file58B2371B.sch, file58B363B0.sch]
2017-03-15 ESF Fixes
    [Accumulator.sch, C-CAN_Y17.kicad_pcb, ESF_Diagrams.sch, PowerDistribution.sch, VehicleController.kicad_pcb, VehicleController.sch, file5874D542.sch, file58B1642D.sch]
2017-03-15 Not sure
    [bspd.sch, shutdown_circuit.sch]
2017-03-16 Update TSAL to comply with ESF Feedback
    [tsal.sch]
2017-03-16 VCU Changes post ESF
    [PowerDistribution.sch, VehicleController.sch, file58B1642D.sch, file58B2371B.sch, file58B363B0.sch]
2017-03-20 Shutdown circuit changes, IMD begun
    [IMD.kicad_pcb, IMD.sch, shutdown_circuit.sch]
2017-03-20 BSPD is more fleshed out. IMD latching continuing
    [IMD.sch, bspd.kicad_pcb, bspd.sch]
2017-03-25 ESF-related changes to current system schematics
    [IMD.sch, bspd.sch]
2017-03-25 Tweaks to IMD and tsal for ESF
    [IMD.sch, tsal.sch]
2017-04-10 C-CAN changes and new enclosure
    [Board_and_Connectors.SLDASM, Board_and_Connectors_2.SLDASM, C-CAN_Enclosure_1.SLDPRT, C-CAN_Y17.SLDPRT, COMPOUND.sldprt, C_CAN_Enclosure_2.SLDPRT, Part14.sldprt, Part15.sldprt]
2017-04-11 TestMule schematic for skillshare
    [C-CAN_Y17-F.Mask.dxf, TestMule.kicad_pcb, TestMule.sch, VehicleController.sch]
2017-04-13 Add reset switch on VCU
    [PowerDistribution.sch, VehicleController.sch, file58B1642D.sch, file58B2371B.sch, file58B363B0.sch]
2017-04-13 More C-CAN changes
    [box.sldprt, box2.sldprt, lid.STL, lid2.STL, lid2.sldprt, new_b_and_c.SLDASM]
2017-04-13 Add BTS4130's for 12v and 5v outputs
    [VehicleController.sch, file58B1642D.sch, file58B363B0.sch]
2017-04-16 More updates prior to finalizing design
    [PowerDistribution.sch, VehicleController.sch, file58B1642D.sch, file58B2371B.sch, file58B363B0.sch]
2017-04-16 C-CAN enclosure changes
    [box.sldprt]
2017-04-20 New enclosure designed
    See box2, lid2, and gasket
    [C-CAN_Y17.SLDPRT, Gasket.sldprt, box2.sldprt, lid2.STL, lid2.sldprt, m12_connector_female.SLDPRT, new_b_and_c.SLDASM]
2017-04-28 VCU changes to precharge and MC Override
    [PowerDistribution.sch, VehicleController.sch, file58B1642D.sch, file58B2371B.sch, file58B363B0.sch]
2017-04-28 Build the Shutdown Circuit in the ESF Diagram
    [ESF_Diagrams.sch, file5874D542.sch]
2017-05-02 Fix error in Precharge Circuit in ESF Diagram
    [ESF_Diagrams.sch, file5874D542.sch]
2017-05-02 Fix Motor Controller Override circuit, better net names
    [PowerDistribution.sch, VehicleController.sch, file58B1642D.sch, file58B2371B.sch, file58B363B0.sch]
2017-05-03 Decoupling caps annotated
    [Gasket.STL, Gasket.sldprt, IMD.sch, bspd.sch, shutdown_circuit.sch]
2017-05-03 Decoupling updates, small VCU changes
    [IMD.sch, PowerDistribution.sch, VehicleController.sch, bspd.sch, file58B1642D.sch, file58B2371B.sch, file58B363B0.sch, reset_latching.kicad_pcb]
2017-05-08 Small changes to VCU
    [PowerDistribution.sch, VehicleController.sch, file58B1642D.sch]
2017-05-11 BSPD Layout Done
    [bspd.kicad_pcb, bspd.sch]
2017-05-11 Fixed board error on BSPD
    Track near via error corrected
    [BSPD_Cart_digikey.csv, bspd.kicad_pcb, shutdown_circuit.sch]
2017-05-11 TSAL board layout
    [tsal.kicad_pcb, tsal.sch]
2017-05-11 Reduce pour clearance to .1", add label
    [bspd.kicad_pcb]
2017-05-11 Changed position of resistor
    The P-FET will now turn off reliably.
    [tsal.kicad_pcb, tsal.sch]
2017-05-13 SCRB layout done
    Shutdown Circuit Relay Board
    [Digikey_BOM.csv, shutdown_circuit.sch]
2017-05-15 MX120, GDS->GSD FETs on VCU
    [PowerDistribution.sch, VehicleController.kicad_pcb, VehicleController.sch, file58B1642D.sch, file58B2371B.sch, file58B363B0.sch]
2017-05-15 Revert "MX120, GDS->GSD FETs on VCU"
    This reverts commit 5f93bf7ab8a0e63cb004bd031bee3d8b2541593f.
    [PowerDistribution.sch, VehicleController.kicad_pcb, VehicleController.sch, file58B1642D.sch, file58B2371B.sch, file58B363B0.sch]
2017-05-15 Re-do MX120, GDS->GSD, Associations.
    [PowerDistribution.sch, VehicleController.kicad_pcb, VehicleController.sch, file58B1642D.sch, file58B2371B.sch, file58B363B0.sch]
2017-05-15 Library Fixes
    [PowerDistribution.sch, VehicleController.kicad_pcb, VehicleController.sch, file58B1642D.sch, file58B2371B.sch, file58B363B0.sch]
2017-05-15 Small schematic fixes, start layout
    [PowerDistribution.sch, VehicleController.kicad_pcb, VehicleController.sch, file58B1642D.sch, file58B2371B.sch, file58B363B0.sch]
2017-05-16 Move trace to avoid screw head
    [shutdown_circuit.kicad_pcb]
2017-05-18 More enclosure revisions
    printing time reduced 30%
    [C-CAN_Y17.SLDPRT, Gasket.STL, Gasket.sldprt, box2.sldprt, lid2.sldprt, new_b_and_c.SLDASM]
2017-05-24 Yet more enclosure revisions for C-CAN
    [C-CAN_Box.STL, C-CAN_Gasket.STL, C-CAN_Lid.STL, Gasket.STL, Gasket.sldprt, box2.STL, box2.sldprt, lid.STL]
2017-05-25 Major layout of VCU begins. Moved some nets to facilitate layout
    [PowerDistribution.sch, VehicleController.kicad_pcb, VehicleController.sch, file58B1642D.sch, file58B2371B.sch, file58B363B0.sch]
2017-05-25 C-CAN Gasket, lid changes (3 connector version)
    [C-CAN_Box.STL, C-CAN_Gasket.STL, C-CAN_Lid.STL, Gasket.STL, Gasket.sldprt, box2.STL, box2.sldprt, lid.STL]
2017-05-25 VCU layout progress
    [VehicleController.kicad_pcb, file58B1642D.sch]
2017-05-25 More VCU layout work
    connectors changed to 2x4 molex nanofits for the 12v and 5v outputs.
    [C-CAN_footprint-box2.DXF, VehicleController.kicad_pcb, VehicleController.sch, file58B1642D.sch, file58B363B0.sch]
2017-05-31 2x10 connector is now a nanofit, VCU
    [PowerDistribution.sch, VehicleController.kicad_pcb, VehicleController.sch, file58B1642D.sch, file58B2371B.sch, file58B363B0.sch]
2017-06-01 Routing changed
    [VehicleController.kicad_pcb, file58B1642D.sch]
2017-06-02 Major VCU Layout changes
    [PowerDistribution.sch, VehicleController.kicad_pcb, VehicleController.sch, file58B1642D.sch, file58B2371B.sch, file58B363B0.sch]
2017-06-02 Finish VCU 4 layer
    [VehicleController.kicad_pcb, VehicleController.sch, file58B1642D.sch]
2017-06-02 box change
    [box2.sldprt]
2017-06-07 VCU Finalization, BOM generation
    [PowerDistribution.sch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]
2017-06-07 C-CAN 5 connector version started
    [Assem1.SLDASM, C-CAN_Y17.SLDPRT, C-CAN_footprint-box2.DXF, Gasket.STL, Gasket.sldprt, Part1.sldprt, box2.STL, box2.sldprt]
2017-06-10 C-CAN software changes, shutdown circuit
    shutdown circuit step file generated. C-CAN software is making progress to be able to store configurations in eeprom and receive new configs over CAN
    [5_connector_box.SLDPRT, 5_connector_box.STL, 5_connector_gasket.sldprt, 5_connector_lid.STL, 5_connector_lid.sldprt, Assem1.SLDASM, Part1.sldprt, shutdown_circuit.stp]
2017-06-10 C-CAN software changes
    throttle improved
2017-06-13 VCU Build, start code
    [VehicleController.sch, VehicleController.xlsx, _saved_VehicleController.sch]
2017-06-13 VCU Board Fix
    [VehicleControllerwut.kicad_pcb, _saved_VehicleController.sch]
2017-06-13 I2C Scanner, GPS Working, Version response, etc
2017-06-13 C-CAN changes
    [Part4.sldprt, bspd.SLDPRT, buspod_box.STL, buspod_box.sldprt, buspod_lid.STL, buspod_lid.sldprt, m12_connector_female.SLDPRT, push_button.SLDPRT]
2017-06-15 vcu board step file generated
    [VehicleController.stp]
2017-06-15 vcu board SLDPRT generated
    [VehicleController.SLDPRT]
2017-06-17 AMS firmware nearing production
    large switch case for parsing CAN messages from the BMS modules. Functions written for getting temperature and voltage data from the BMS modules, as well as the "address claim" so that the psoc is the "ecu" of the system.
2017-06-17 Pin defines, pin startup states
2017-07-19 many changes
    [relay_driver.kicad_pcb, relay_driver.sch]
2017-07-19 Shutdown, AIR+, and buzzer enable
    [VehicleController.ino]
2017-07-24 Fix timeout bug due to improper bracketing
    [VehicleController.ino]
2017-08-01 Reset DEBUG defines to something reasonable
    [VCDefines.h]
2017-08-01 Fix define names, implement timer for GPS, CAN messaging & debugs
    [VC_CAN.h, VC_GPS.h, VC_Timers.h, VehicleController.ino]
2017-08-09 CAN WORKS ON 2017 CAR
    changed the FlexCAN library on the VCU to the 'Collin80' version from github to make CAN work on the teensy. Changed a || to a | to correctly handle bitshifted values in the CAN handler function o nthe VCU. Changed the message IDs on the C-CAN to reflect the correct values. Scaled the throttle input to a (0,4000) range.
    [VCDefines.h, VC_CAN.h, VC_VarStore.cpp, VehicleController.ino, main.c]
2017-09-05 Fix UltimateSensorFusion footprint
2017-09-05 Add SHUTDOWN_CTRL commands to enable shutdown circuit
2017-09-07 No changes, just resaves
    [VehicleController.FCStd, VehicleController1.step]
2017-11-10 Start harness schematic
    [2017_Harness.kicad_pcb, 2017_Harness.sch, PowerDistribution.sch, VehicleController.sch, file58B1642D.sch, file58B2371B.sch, file58B363B0.sch, file5A01513A.sch]
2017-11-10 Fleshed out harness diagram
    [2017_Harness.sch, C-CAN_Y17.sch, PowerDistribution.sch, VehicleController.sch, file58B1642D.sch, file58B2371B.sch, file58B363B0.sch, file5A05254A.sch]
